ICST-AHMI/HSoundplane_design/eagle/piezo-driver/_export/jpg/piezo-driver-BOT.jpg

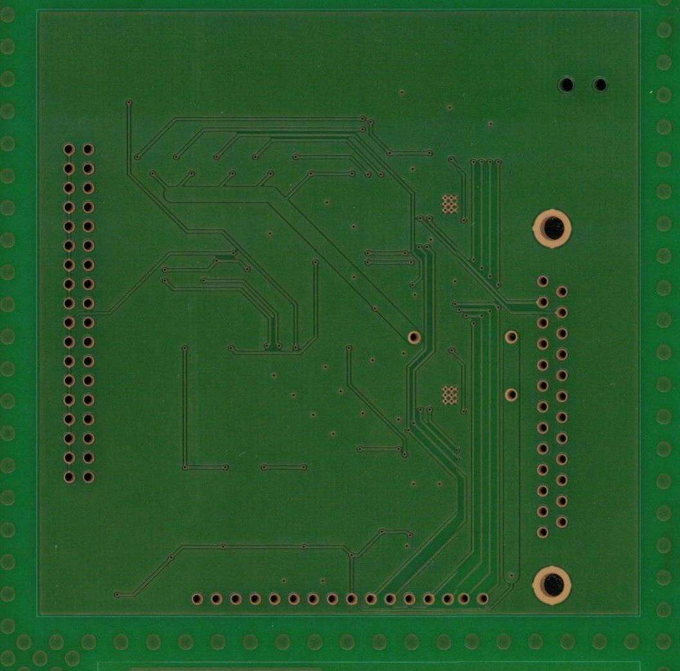
eagle/piezo-driver/_export/jpg/piezo-driver-BOT.jpg
