ICST-AHMI/HSoundplane_design/eagle/piezo-driver/_export/jpg/piezo-driver-TOP.jpg

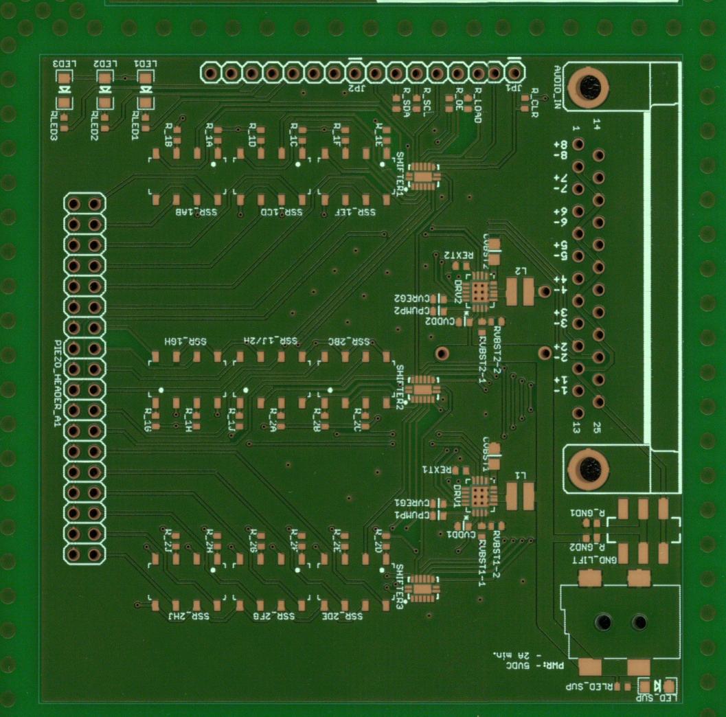
eagle/piezo-driver/_export/jpg/piezo-driver-TOP.jpg
