ICST-AHMI/HSoundplane_design/blender/texturen/soundplane_v0.95-R002.png

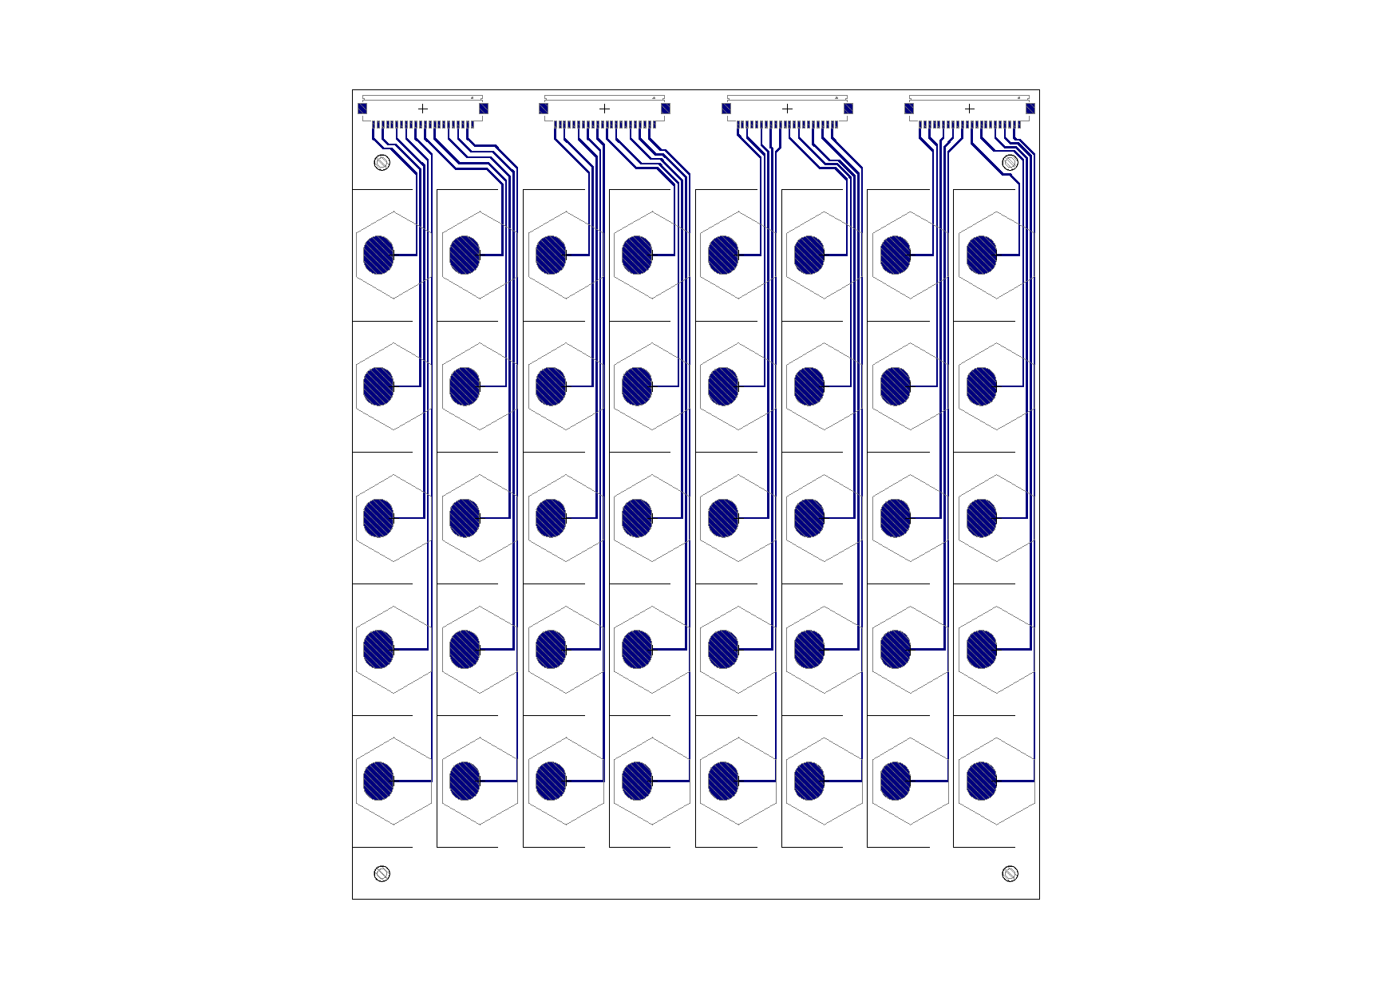
blender/texturen/soundplane_v0.95-R002.png
