ICST-AHMI/HSoundplane_design/blender/texturen/soundplane_v0.95-R004.png

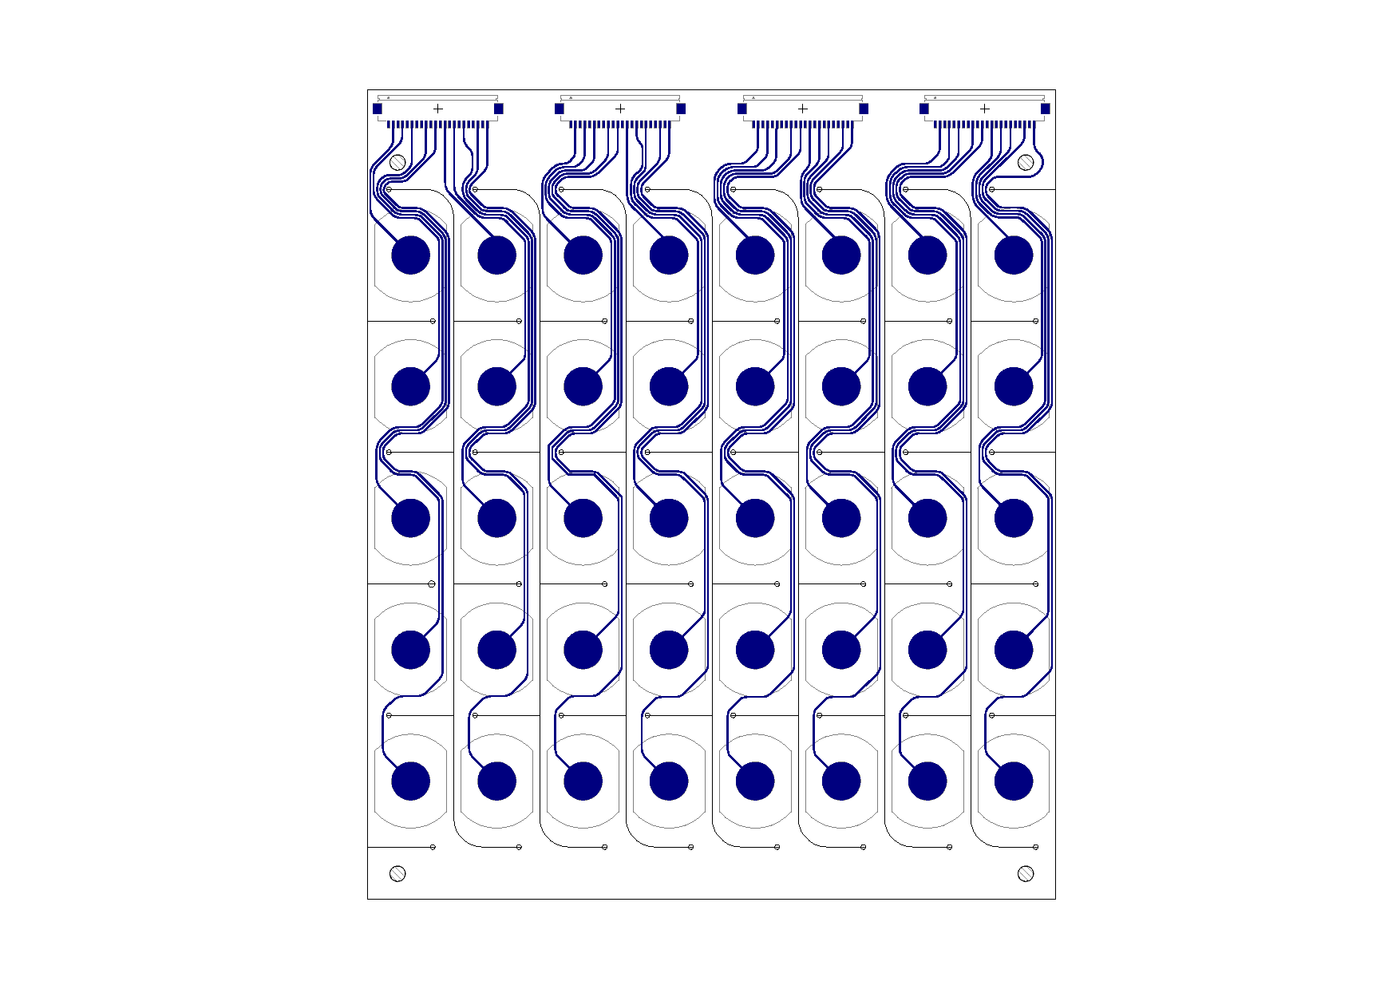
blender/texturen/soundplane_v0.95-R004.png
