ICST-AHMI/HSoundplane_design/blender/texturen/soundplane_v0.95-R006.png

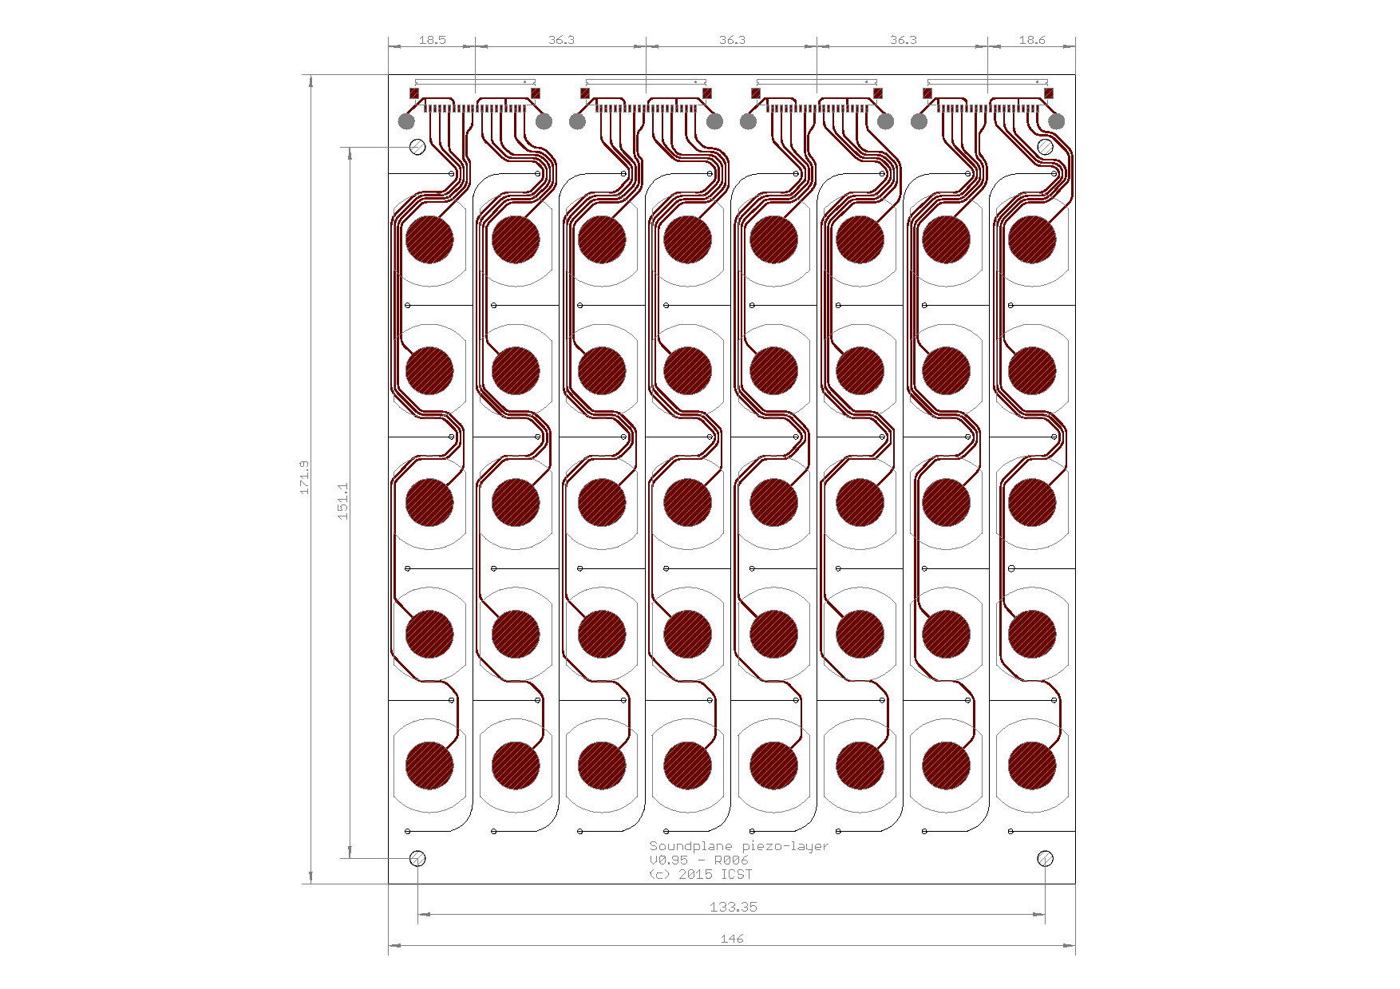
blender/texturen/soundplane_v0.95-R006.png
