ICST-AHMI/HSoundplane_design/(list of files, cad)

Other CAD files:
blender/SP_0072_V2.blend
blender/SP_0072_V3.blend
blender/SP_0072_V4.blend
blender/SP_0072_V5.blend
blender/SP_0072_V6.blend
blender/SP_0072_V7.blend
blender/SP_0072_V8.blend
blender/SP_0072_V9.blend
blender/Sketch.blend
