ICST-AHMI/HSoundplane_design/blender/texturen/multi-touch_v0.95-R003_MEASURES.pdf

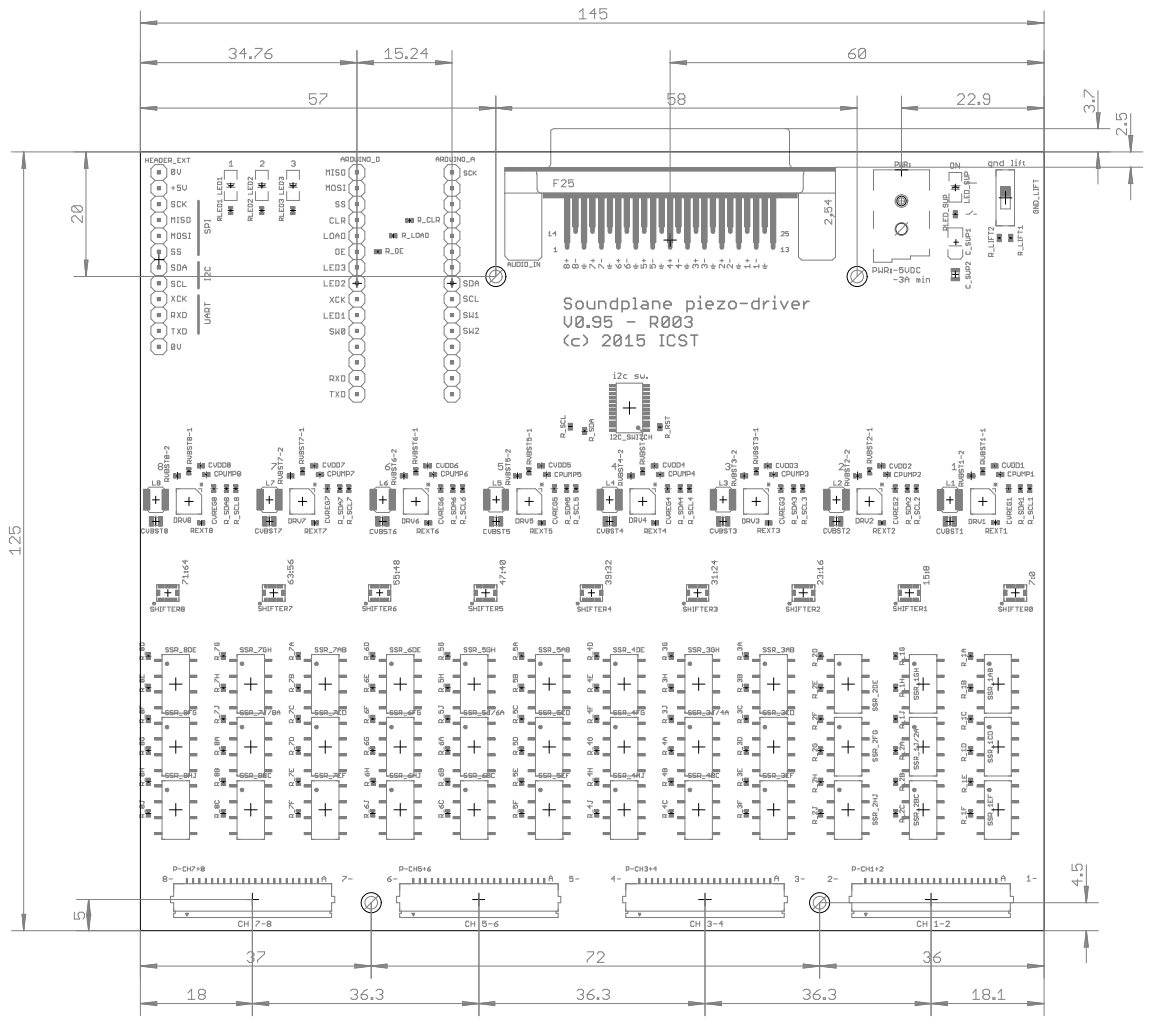
[picture p7: page 1]
