ICST-AHMI/HSoundplane_design/eagle/piezo-driver/_export/pdf/piezo-driver_v0.95-R002_MEASURES.pdf

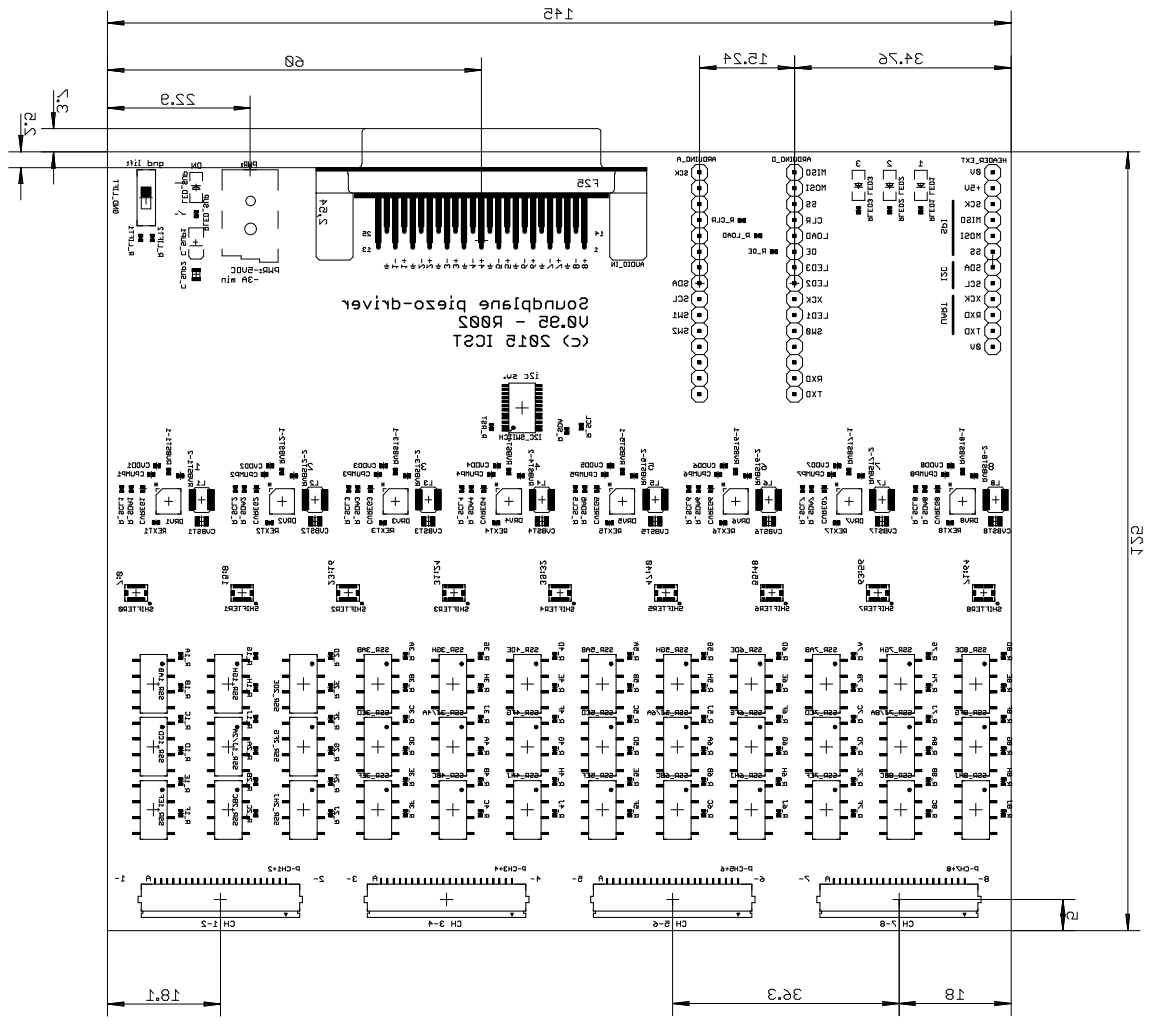
[picture p8: page 1]
