ICST-AHMI/HSoundplane_design/blender/texturen/soundplane_v0.95-R002.pdf

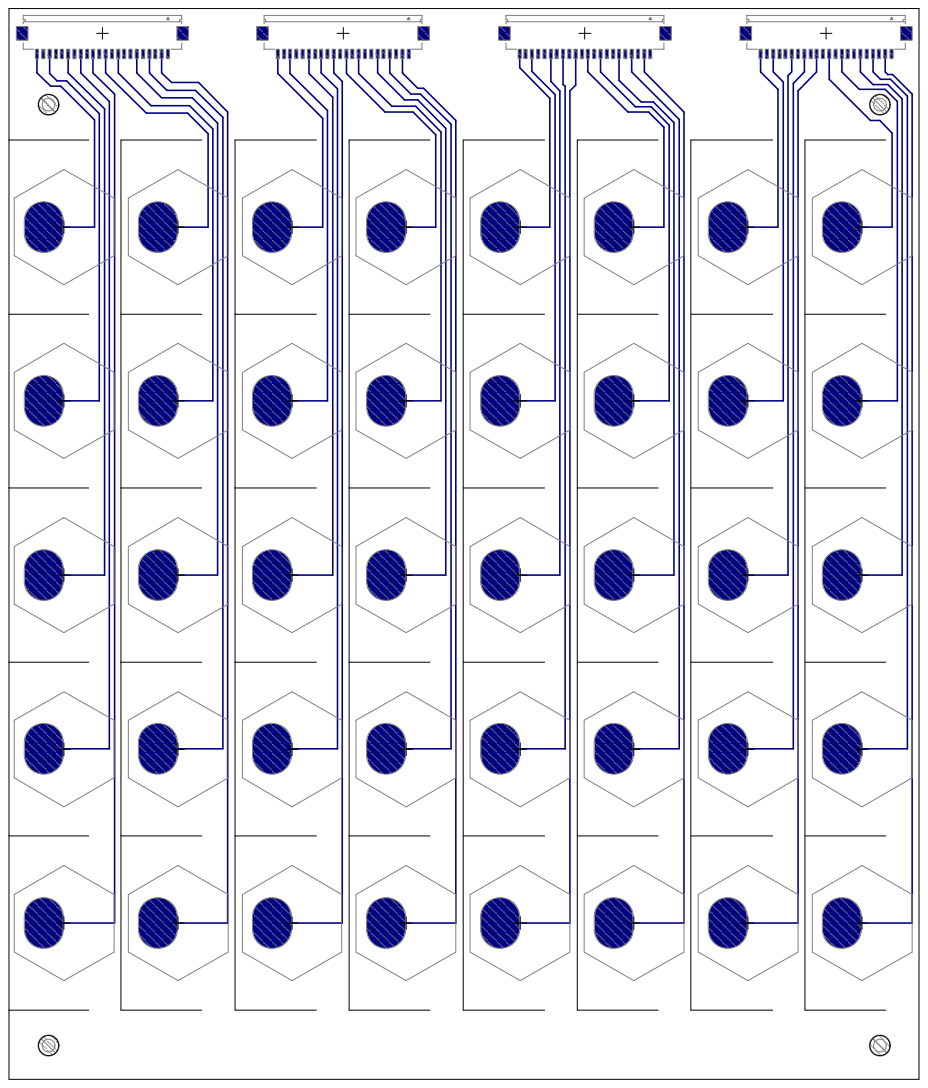
[picture p9: page 1]
