ICST-AHMI/HSoundplane_design/blender/texturen/soundplane_v0.95-R004.pdf

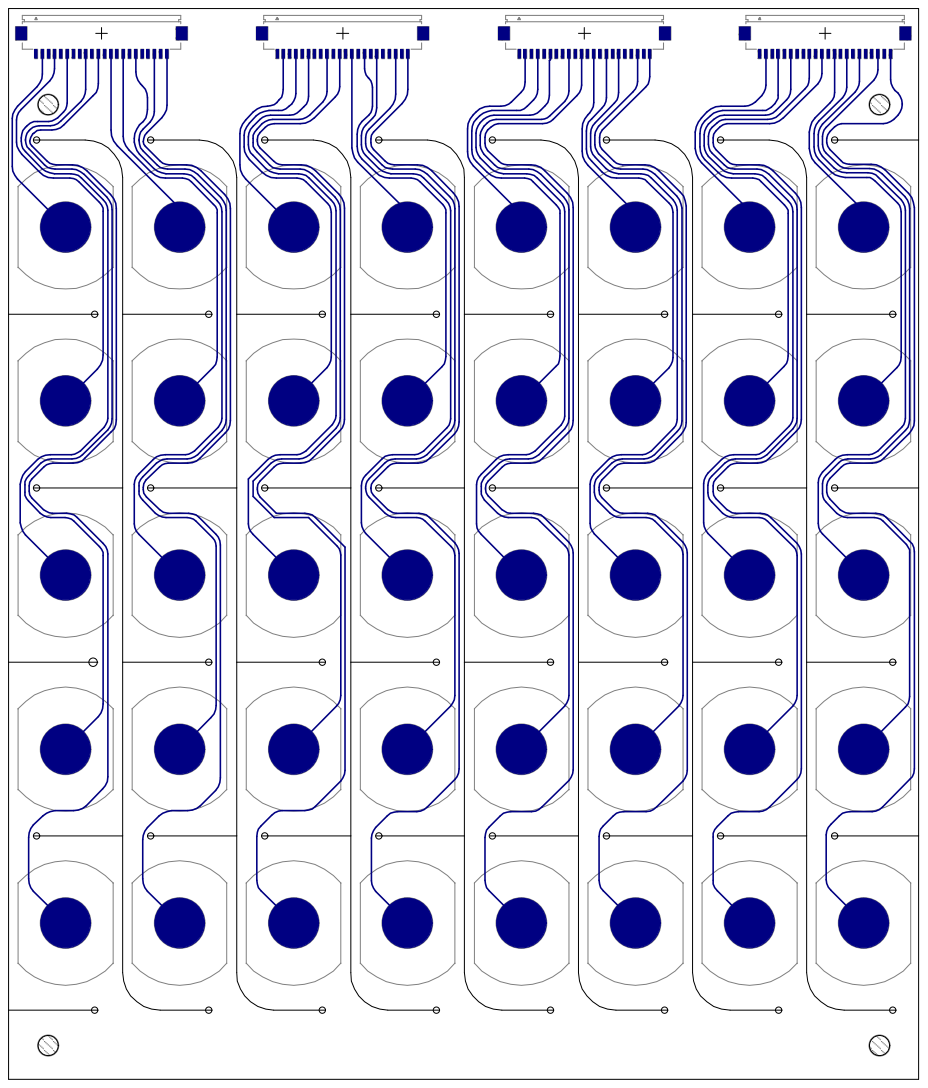
[picture p10: page 1]
