ICST-AHMI/HSoundplane_design/blender/texturen/soundplane_v0.95-R006.pdf

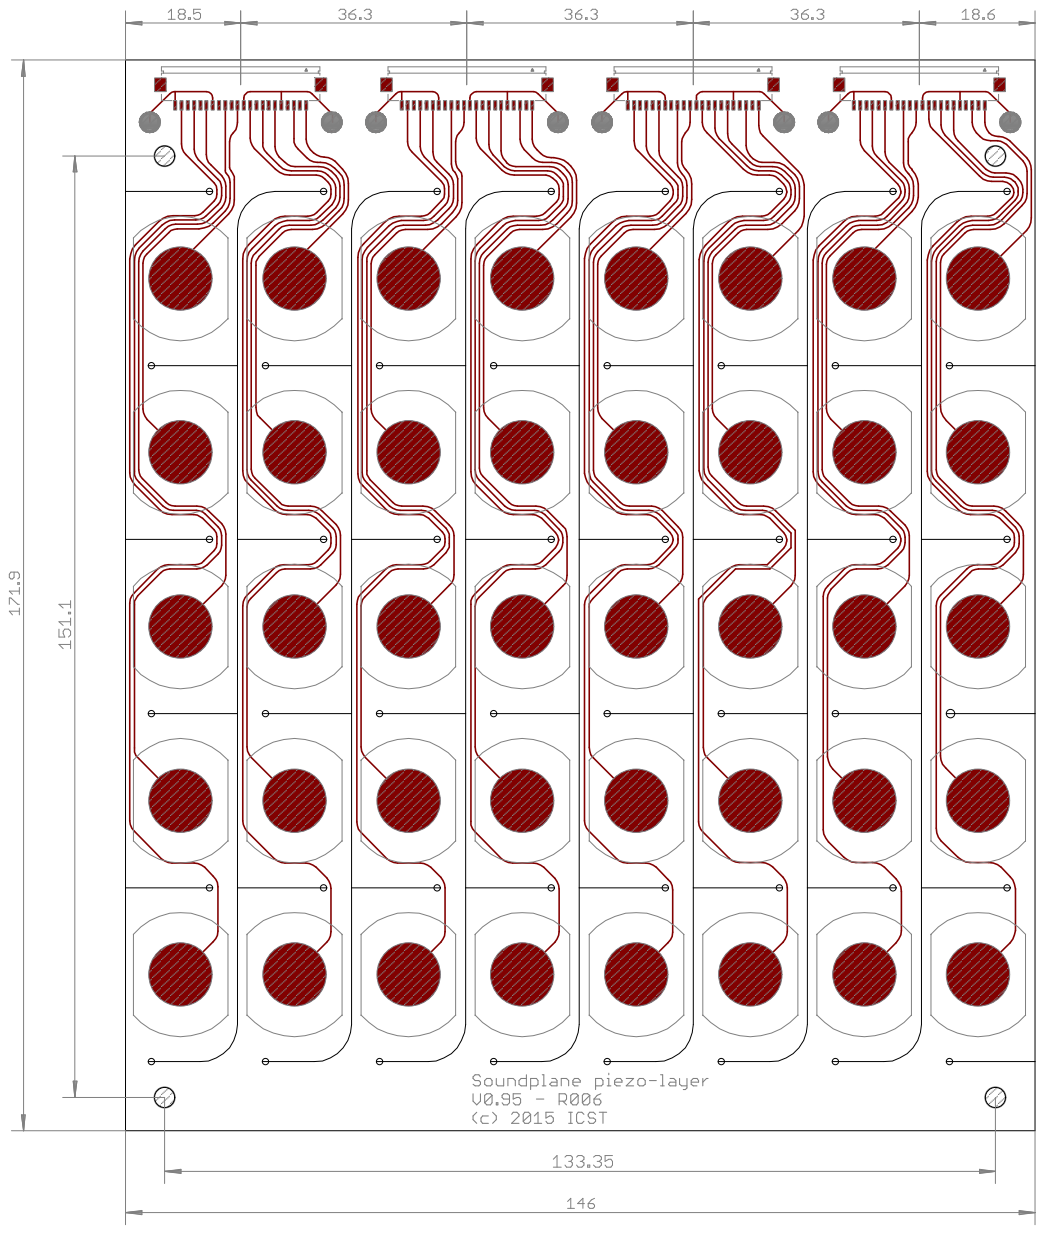
[picture p11: page 1]
