ICST-AHMI/HSoundplane_design/eagle/piezo-driver/_export/pdf/piezo-driver_v0.1-R001_TOP.pdf

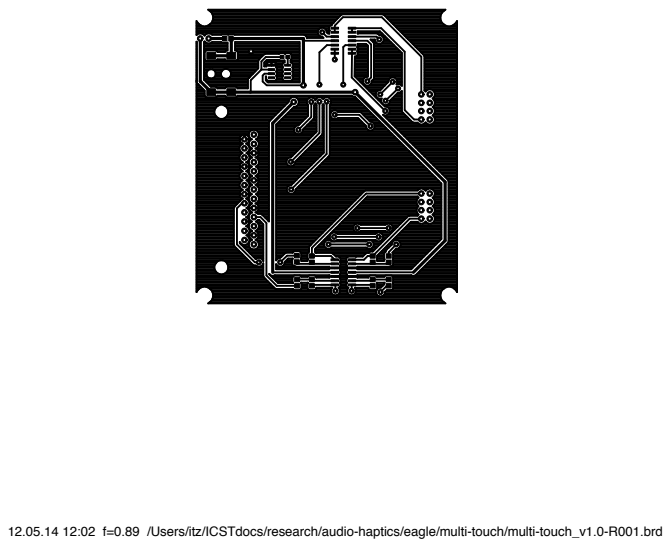
[picture p13: page 1]

12.05.14 12:02 f=0.89 /Users/itz/ICSTdocs/research/audio-haptics/eagle/multi-touch/multi-touch_v1.0-R001.brd
