ICST-AHMI/HSoundplane_design/eagle/piezo-driver/_export/pdf/piezo-driver_v0.1-R002_BOT.pdf

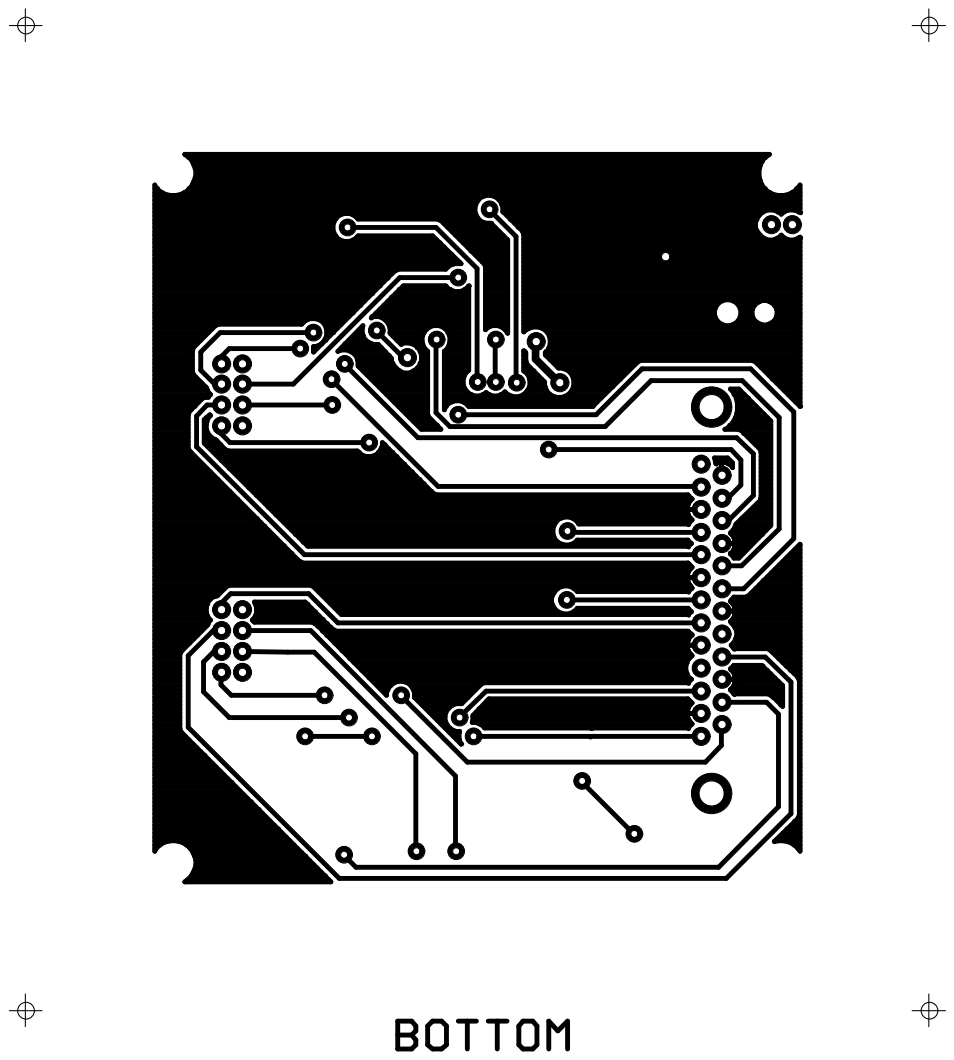
[picture p14: page 1]
