ICST-AHMI/HSoundplane_design/eagle/piezo-driver/_export/pdf/piezo-driver_v0.1-R002_TOP.pdf

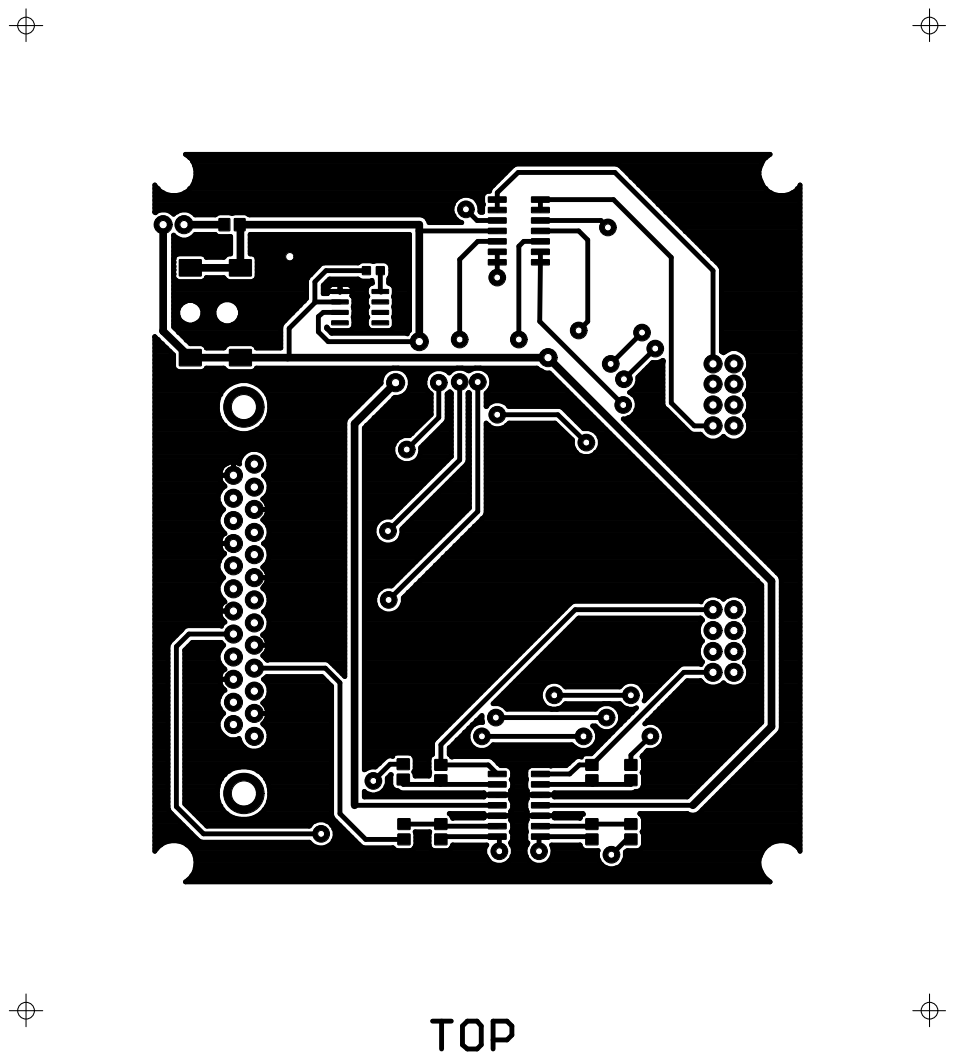
[picture p15: page 1]
