ICST-AHMI/HSoundplane_design/eagle/piezo-driver/_export/pdf/piezo-driver_v0.95-R002.pdf

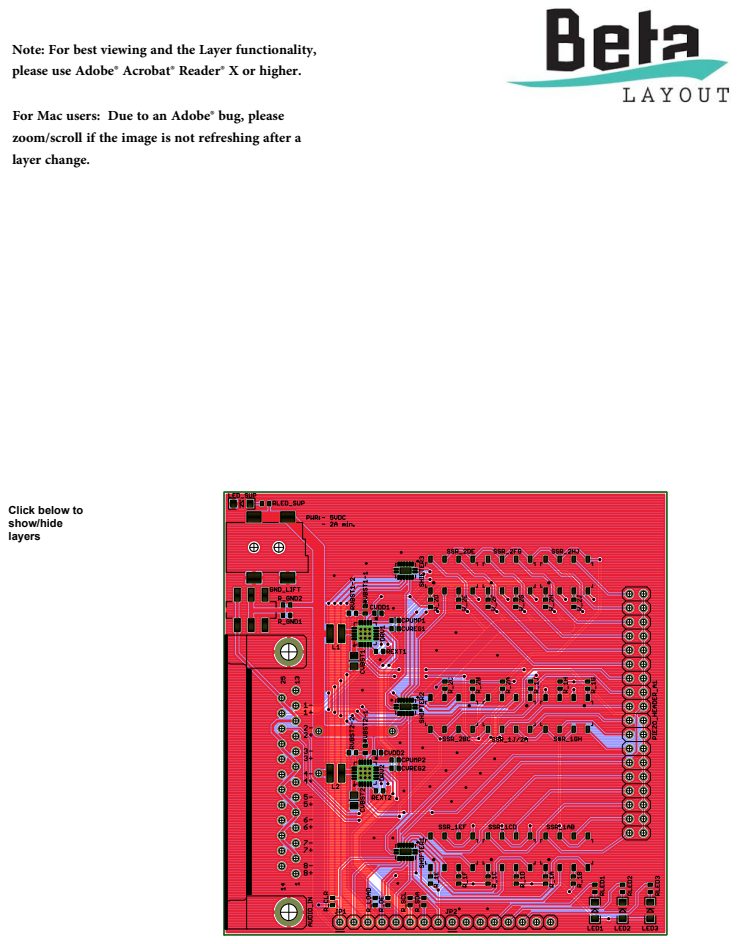
[picture p16: page 1]

Note: For best viewing and the Layer functionality,
please use Adobe® Acrobat® Reader® X or higher.
For Mac users: Due to an Adobe® bug, please
zoom/scroll if the image is not refreshing after a
layer change.
