ICST-AHMI/HSoundplane_design/eagle/piezo-driver/_export/pdf/piezo-driver_v0.95-R002_BESTUECKUNG.pdf

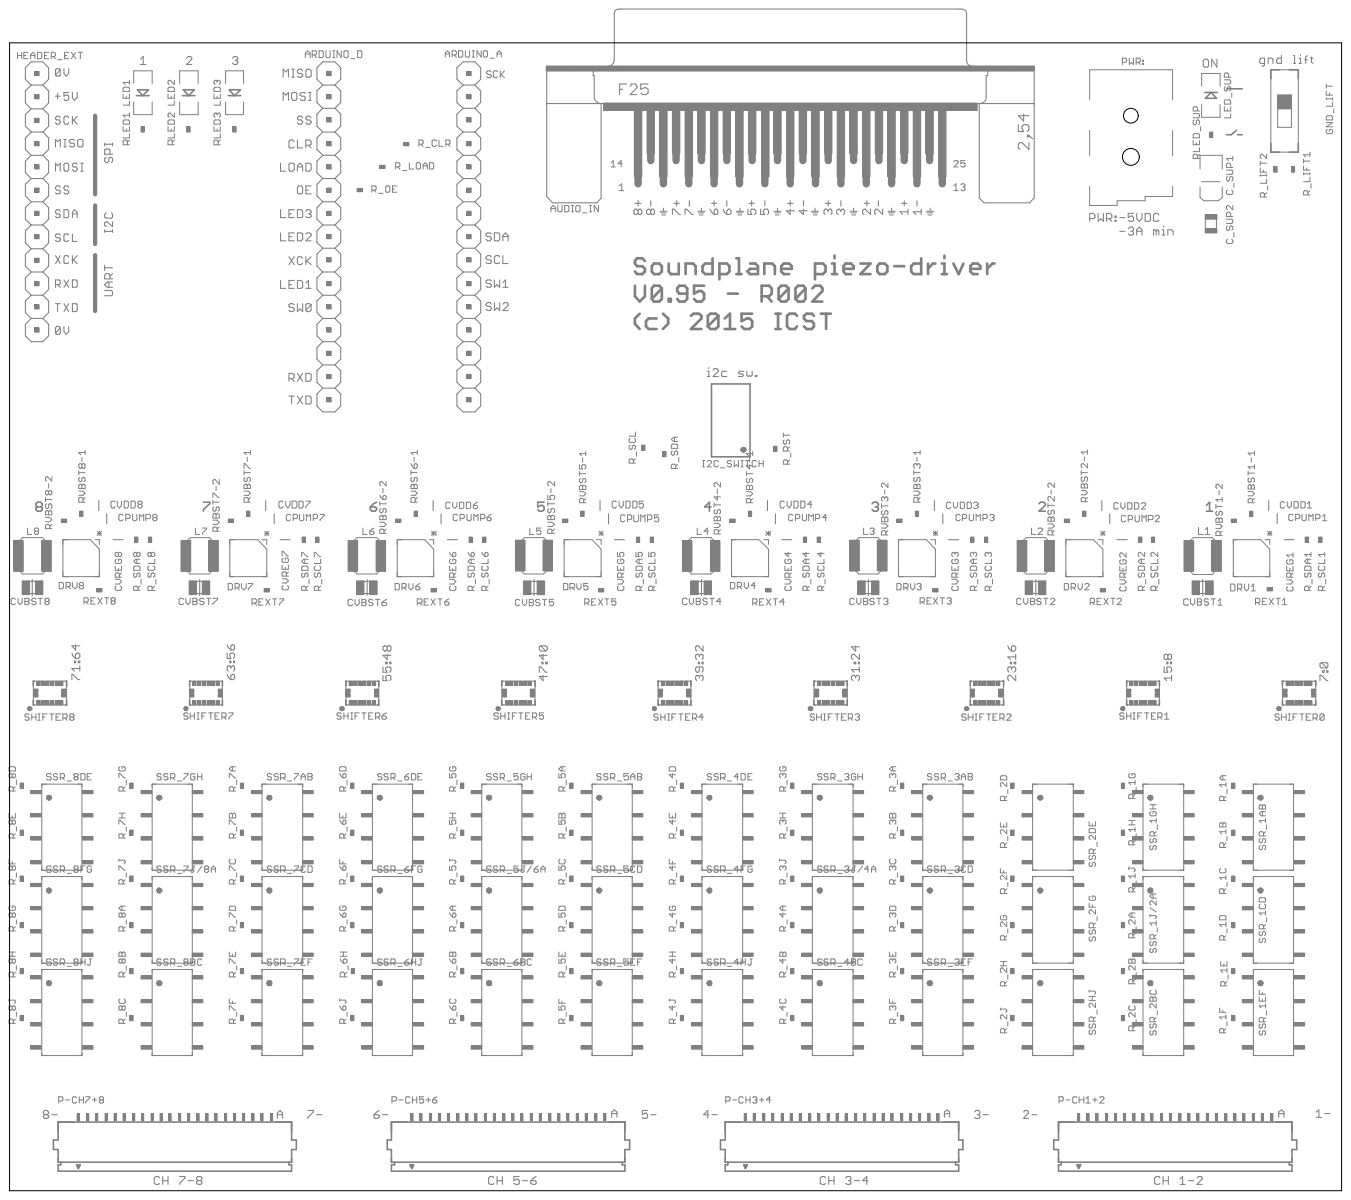
[picture p17: page 1]
