ICST-AHMI/HSoundplane_design/eagle/piezo-layer/_export/pdf/piezo-layer_v0.1-R002.pdf

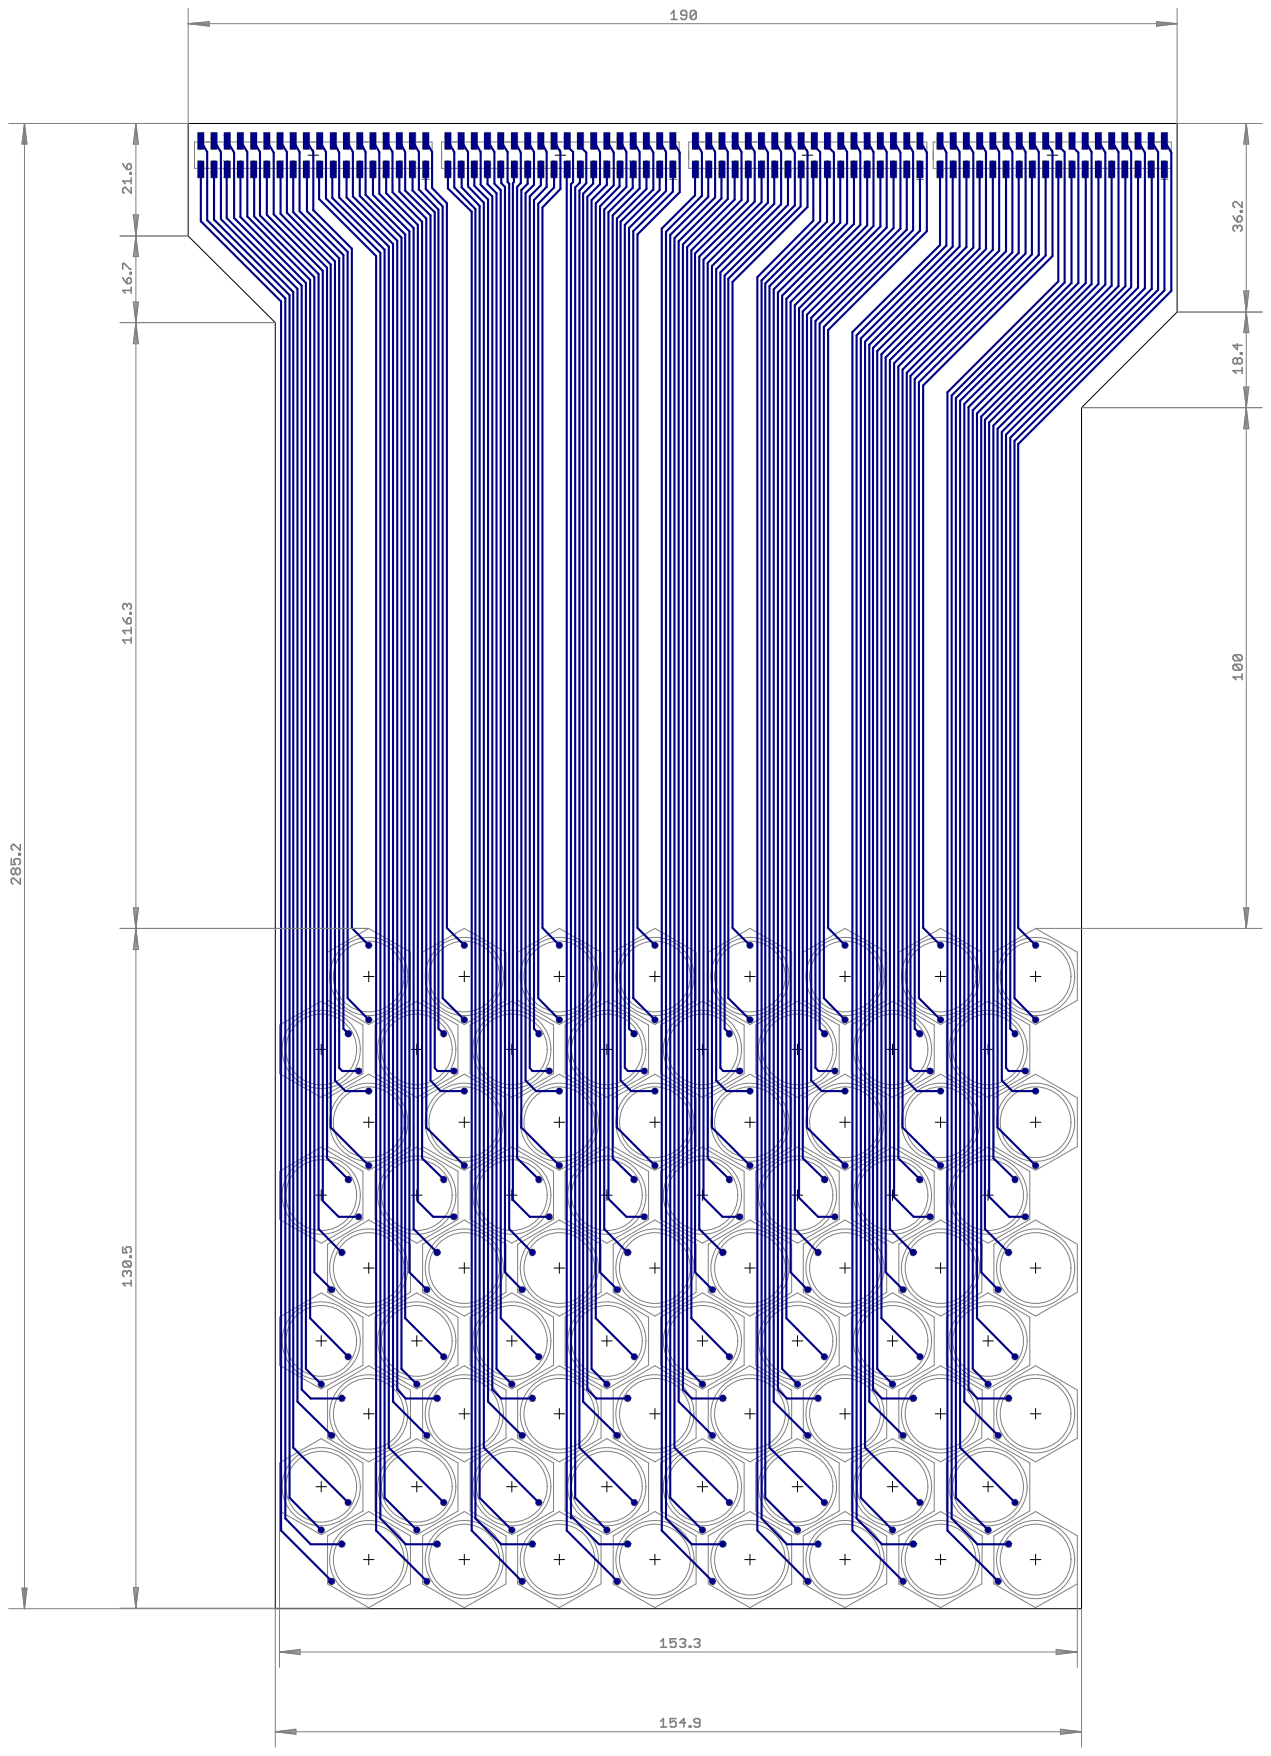
[picture p18: page 1]
