ICST-AHMI/HSoundplane_design/eagle/piezo-layer/_export/pdf/piezo-layer_v0.3-R001.pdf

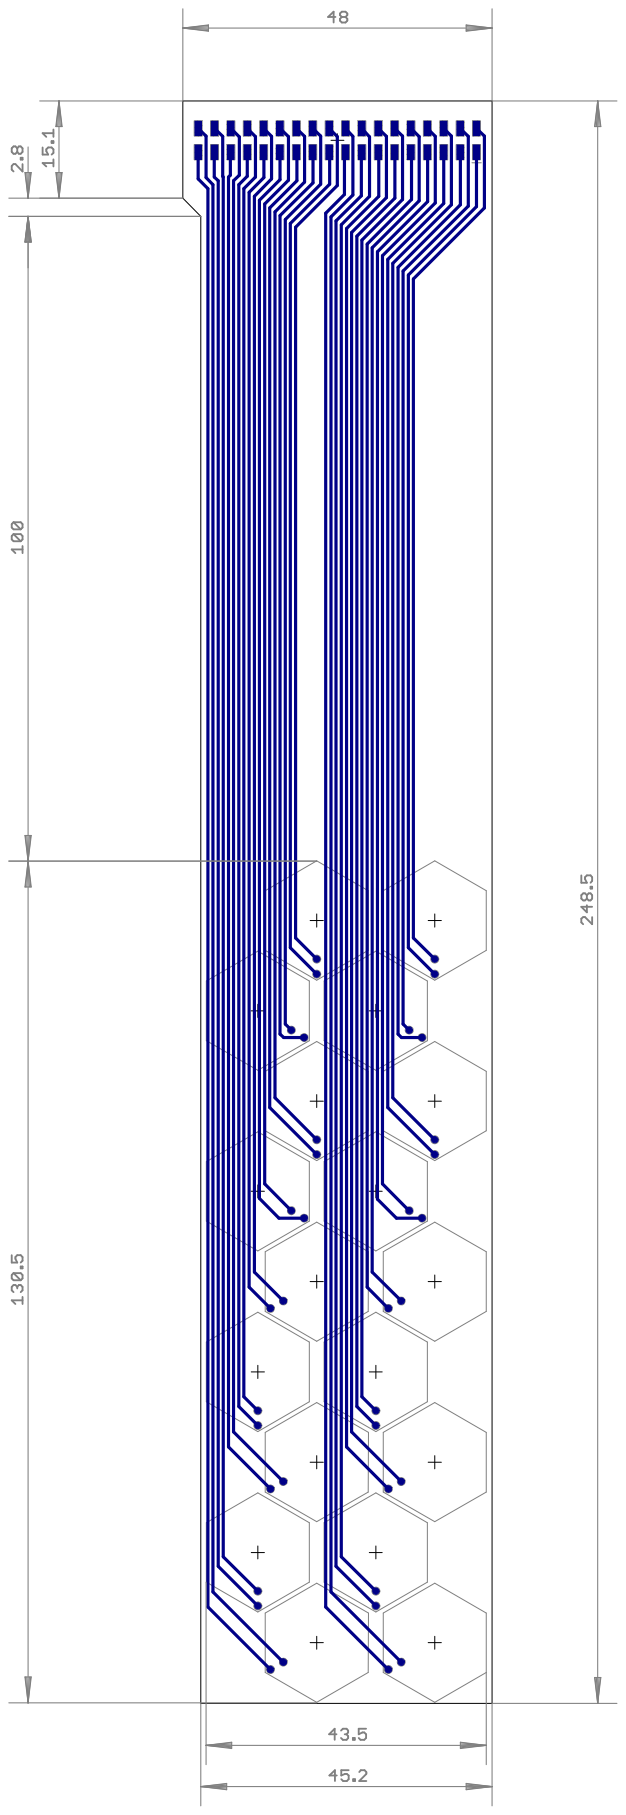
[picture p19: page 1]
