ICST-AHMI/HSoundplane_design/eagle/piezo-layer/_export/pdf/piezo-layer_v0.95-R006_dimension.pdf

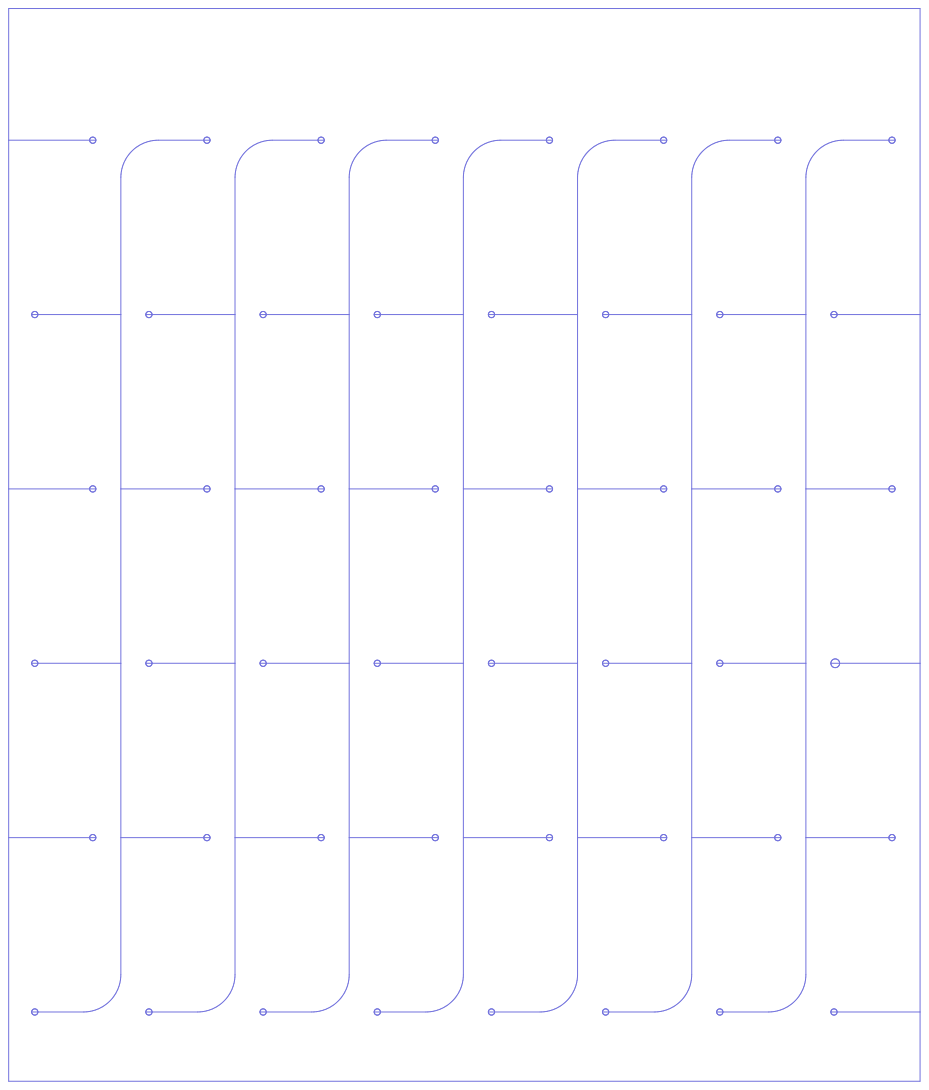
[picture p20: page 1]
