ICST-AHMI/HSoundplane_design/eagle/piezo-layer/_export/pdf/piezo-layer_v0.95-R006_top.pdf

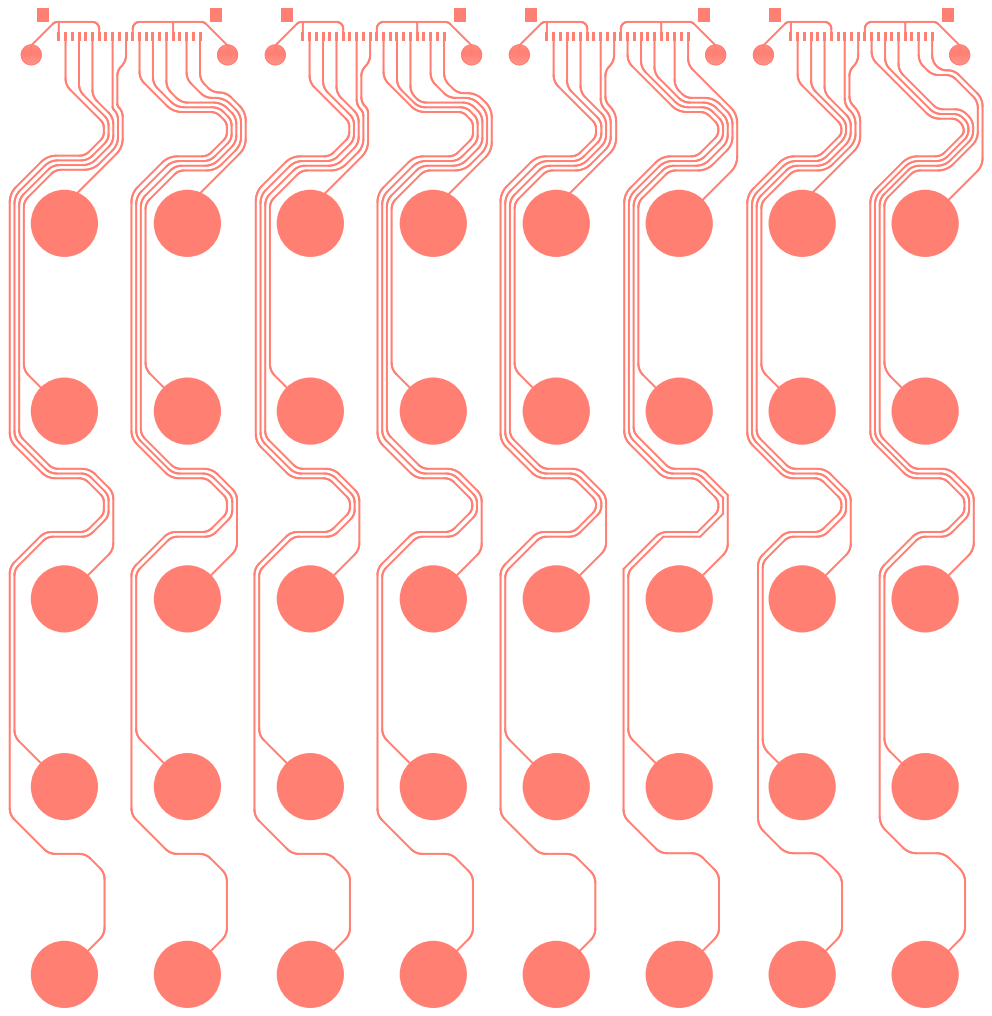
[picture p21: page 1]
