ICST-AHMI/HSoundplane_design/eagle/piezo-layer/_export/pdf/piezo-layer_v0.95-R006_tSilk.pdf

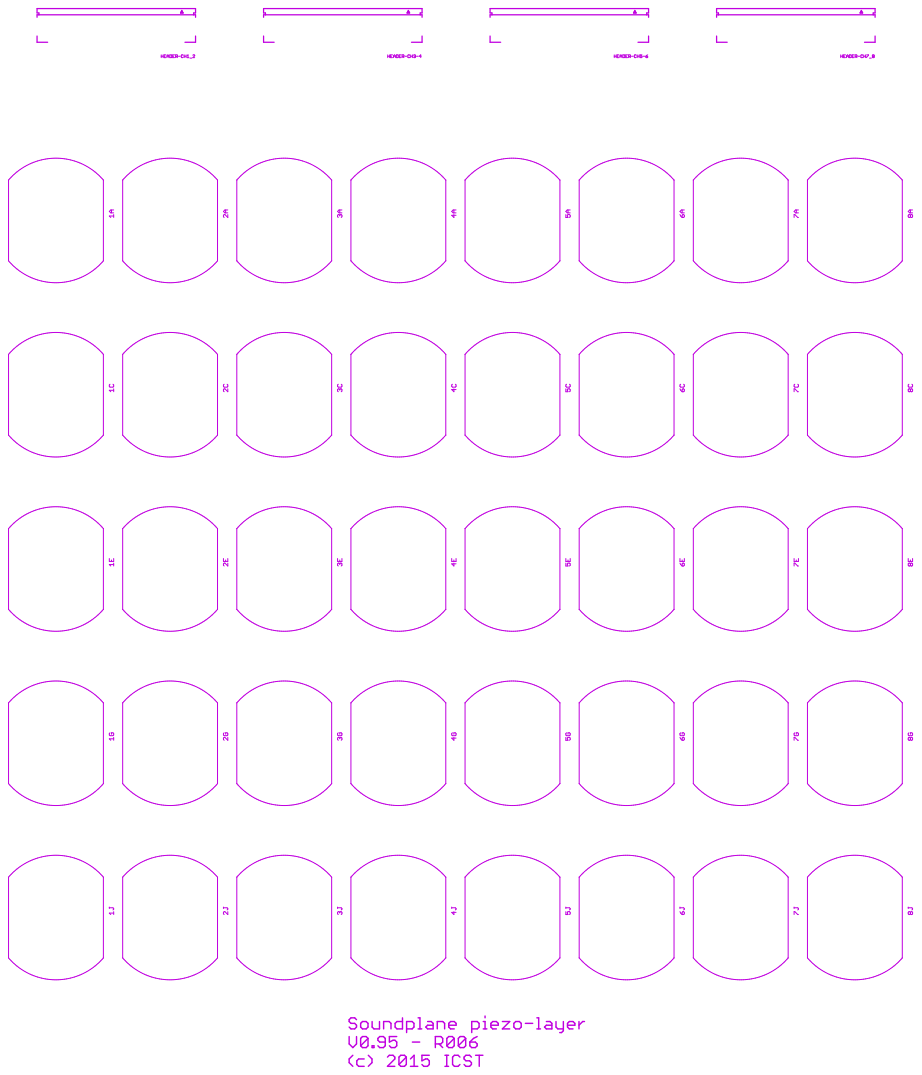
[picture p22: page 1]
