ICST-AHMI/HSoundplane_design/eagle/piezo-layer/_export/pdf/piezo-layer_v0.95-R006_tStop.pdf

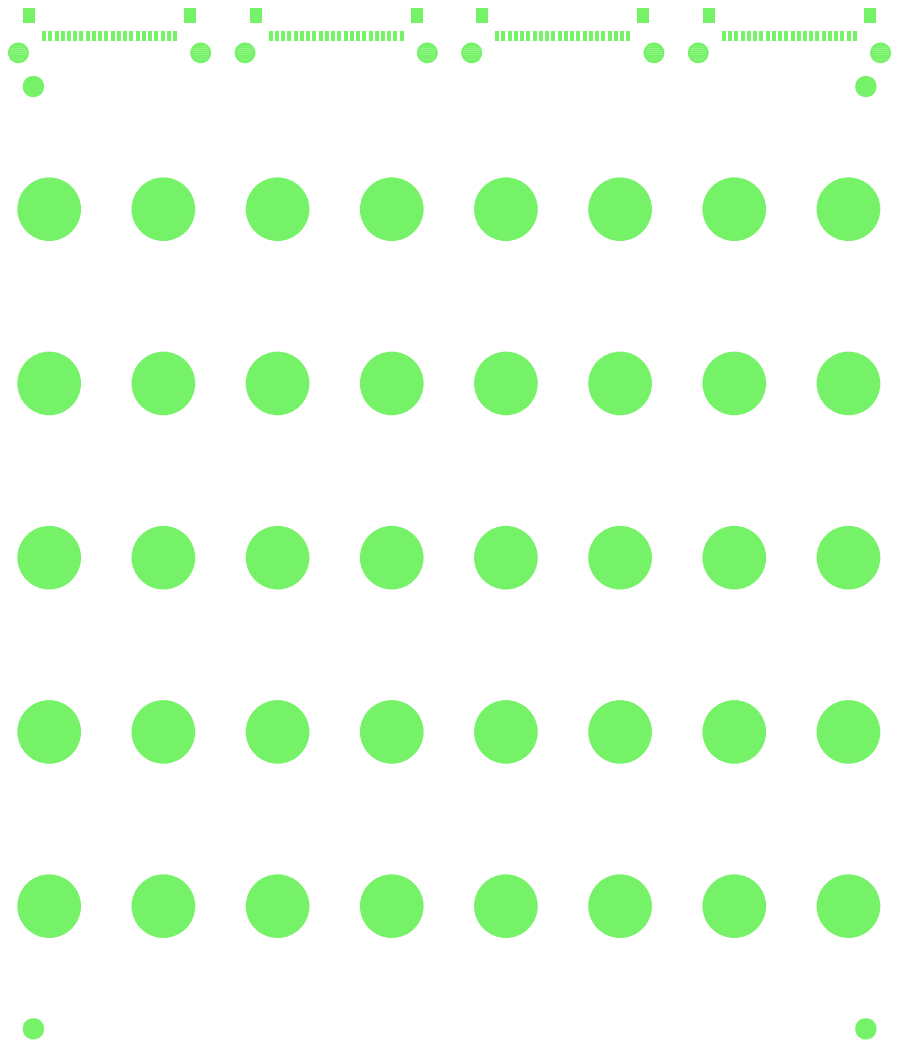
[picture p23: page 1]
