ICST-AHMI/HSoundplane_design/eagle/piezo-layer/_export/pdf/piezo-layer_v0.1-R001.pdf

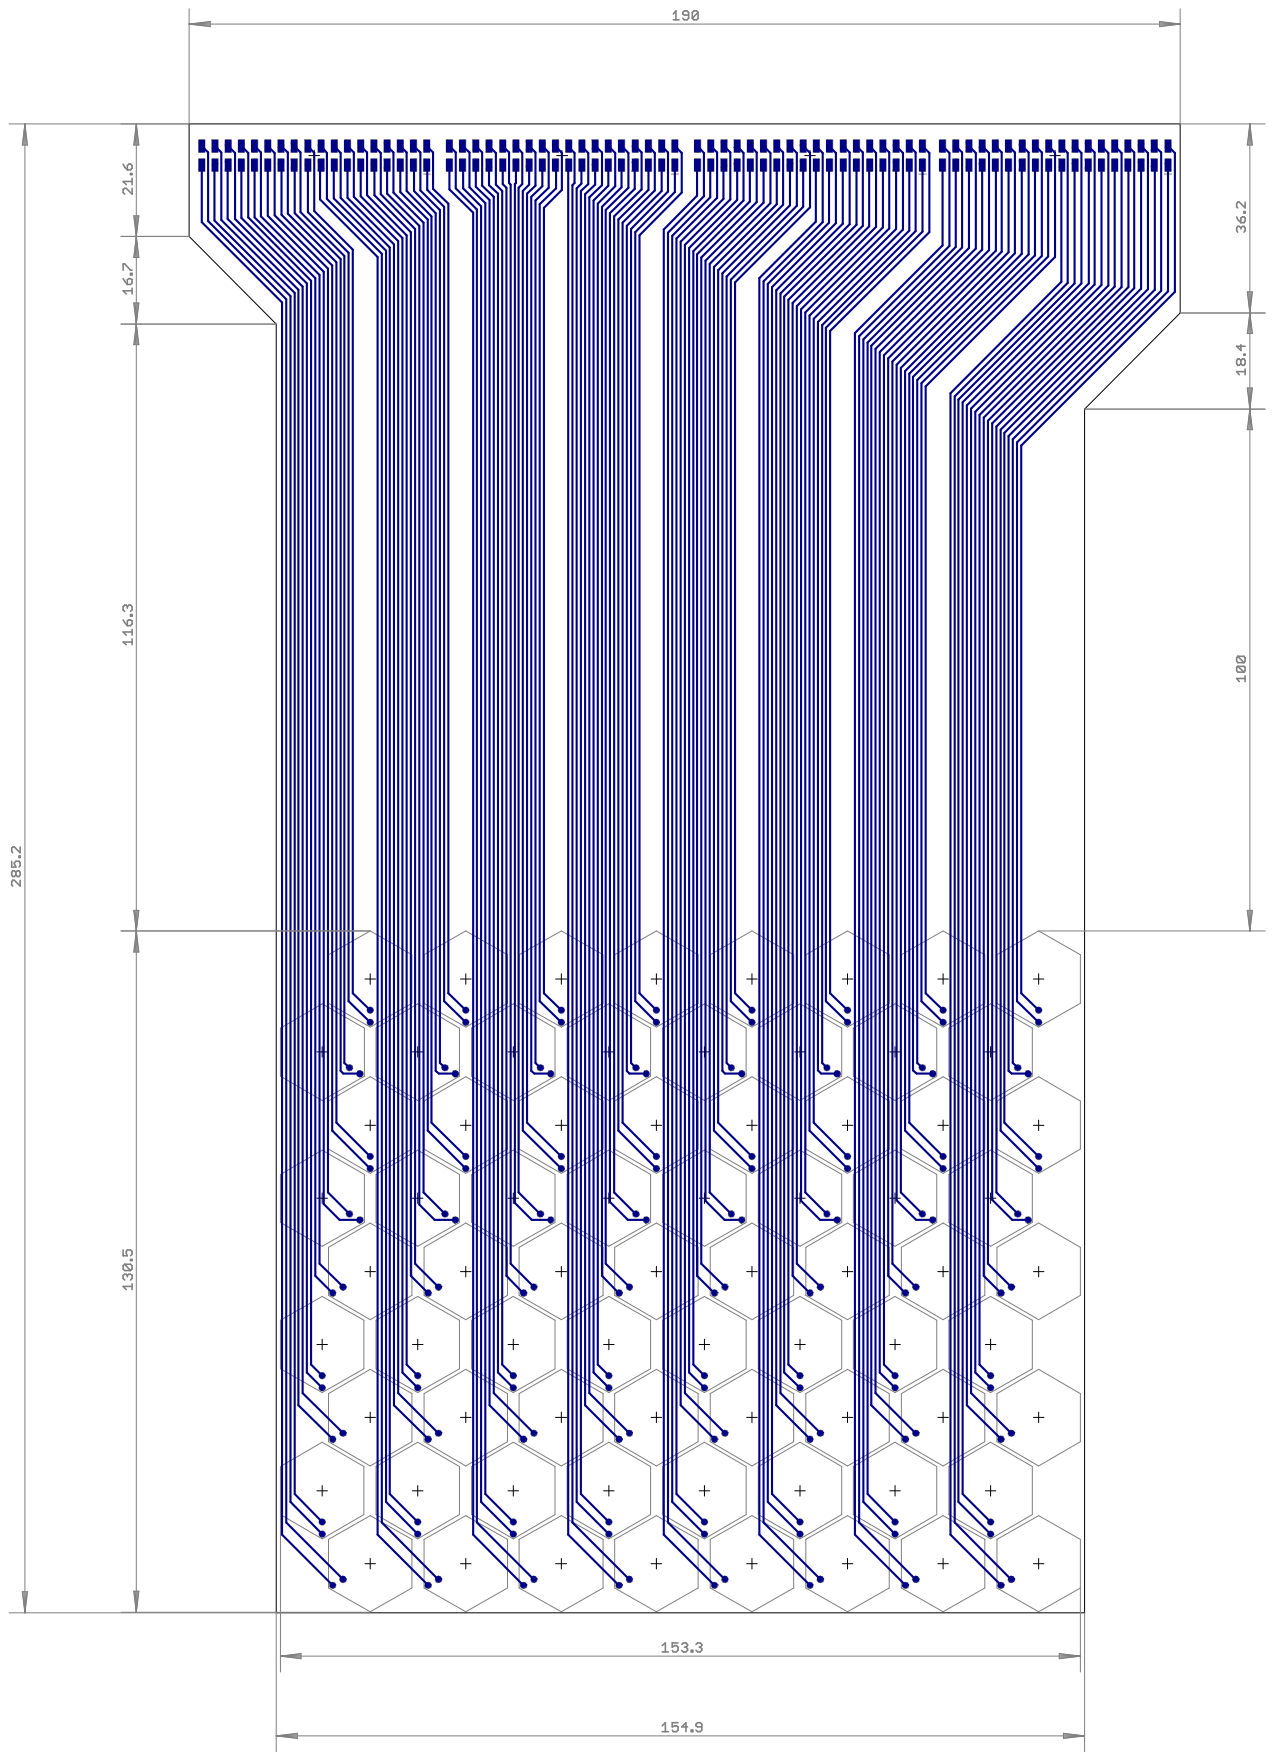
[picture p24: page 1]
