ICST-AHMI/HSoundplane_design/eagle/piezo-layer/_export/pdf/piezo-layer_v0.2-R001.pdf

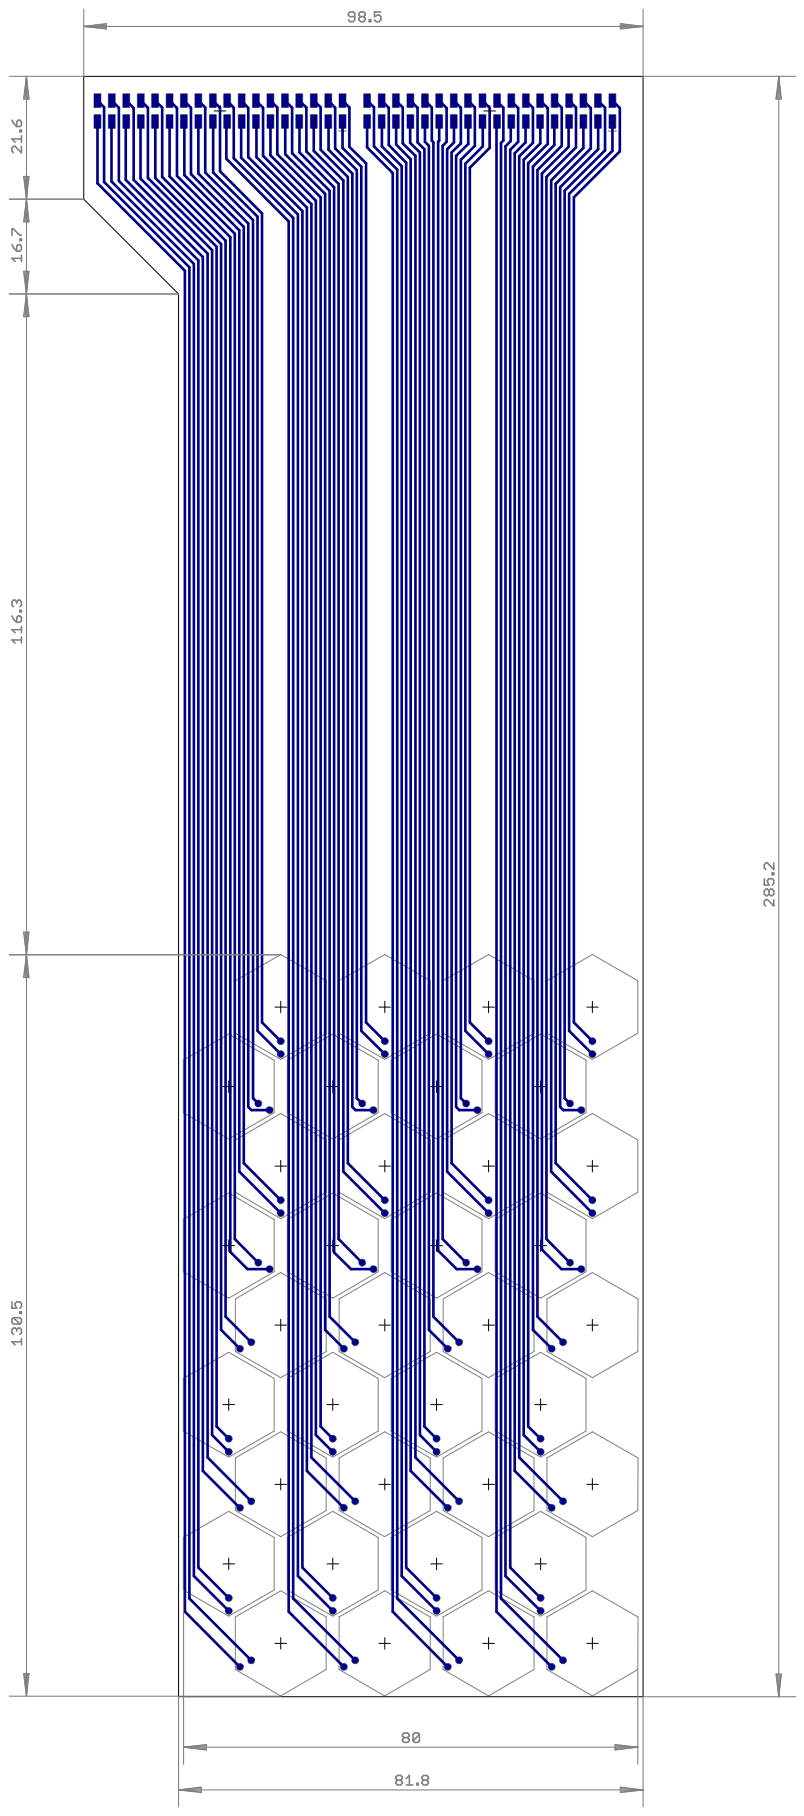
[picture p25: page 1]
