ICST-AHMI/HSoundplane_design/eagle/piezo-layer/piezo-layer_v0.95-R002.brd

## EAGLE design eagle/piezo-layer/piezo-layer_v0.95-R002.brd (2015-09-08)

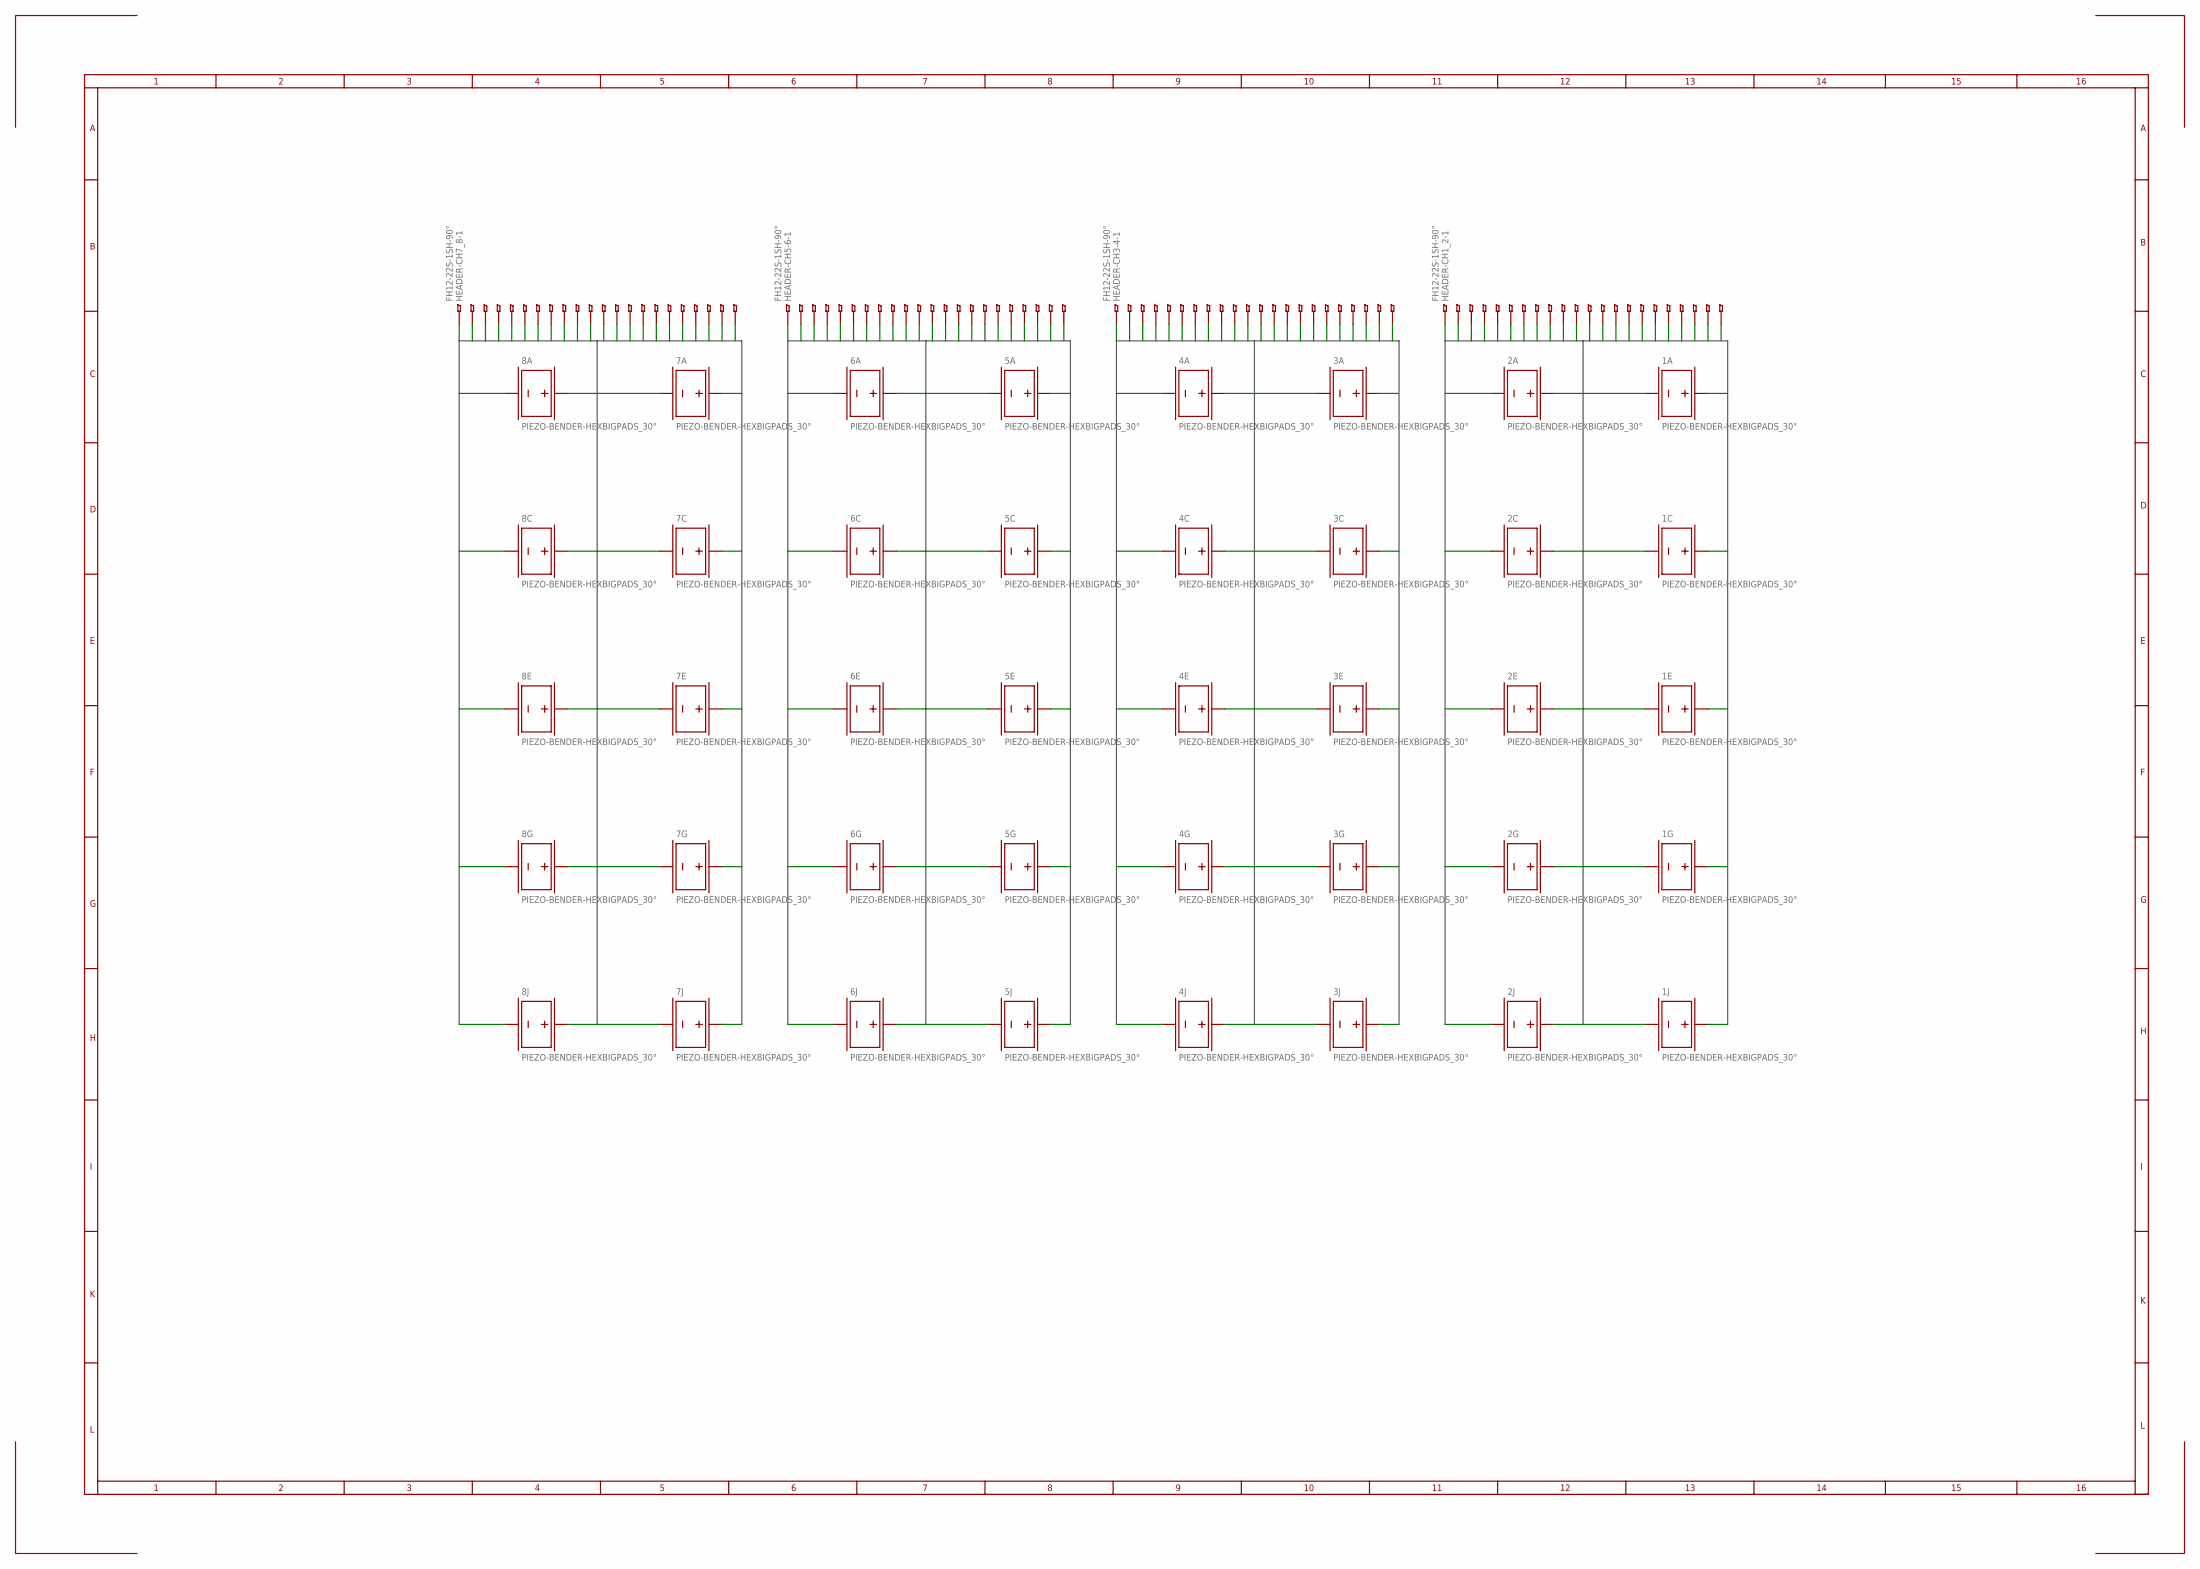
[picture p26: schematic piezo-layer_v0.95-R002.sch]

Parts:
1A, 1C, 1E, 1G, 1J, 2A, 2C, 2E, 2G, 2J, 3A, 3C, 3E, 3G, 3J, 4A, 4C, 4E, 4G, 4J, 5A, 5C, 5E, 5G, 5J, 6A, 6C, 6E, 6G, 6J, 7A, 7C, 7E, 7G, 7J, 8A, 8C, 8E, 8G, 8J: PIEZO-BENDER-HEXBIGPADS_30°; PIEZO-BENDER-HEX_16MM_BIGPAD-30°
HEADER-CH1_2, HEADER-CH3-4, HEADER-CH5-6, HEADER-CH7_8: FH12-22S-1SH-90°; FH12-22S-1SH

Connections:
BUS1: 1A.TOP (+_1), HEADER-CH1_2.22
BUS2: HEADER-CH1_2.21
BUS3: 1C.TOP (+_1), HEADER-CH1_2.20
BUS4: HEADER-CH1_2.19
BUS5: 1A.BOTTOM (-_1), 1C.BOTTOM (-_1), 1E.BOTTOM (-_1), 1G.BOTTOM (-_1), 1J.BOTTOM (-_1), HEADER-CH1_2.12, HEADER-CH1_2.18
BUS6: 1E.TOP (+_1), HEADER-CH1_2.17
BUS7: HEADER-CH1_2.16
BUS8: 1G.TOP (+_1), HEADER-CH1_2.15
BUS9: HEADER-CH1_2.14
BUS10: 1J.TOP (+_1), HEADER-CH1_2.13
BUS11: 2A.TOP (+_1), HEADER-CH1_2.11
BUS12: HEADER-CH1_2.10
BUS13: 2C.TOP (+_1), HEADER-CH1_2.9
BUS14: HEADER-CH1_2.8
BUS15: 2A.BOTTOM (-_1), 2C.BOTTOM (-_1), 2E.BOTTOM (-_1), 2G.BOTTOM (-_1), 2J.BOTTOM (-_1), HEADER-CH1_2.1, HEADER-CH1_2.7
BUS16: 2E.TOP (+_1), HEADER-CH1_2.6
BUS17: HEADER-CH1_2.5
BUS18: 2G.TOP (+_1), HEADER-CH1_2.4
BUS19: HEADER-CH1_2.3
BUS20: 2J.TOP (+_1), HEADER-CH1_2.2
BUS21: 3A.TOP (+_1), HEADER-CH3-4.22
BUS22: HEADER-CH3-4.21
BUS23: 3C.TOP (+_1), HEADER-CH3-4.20
BUS24: HEADER-CH3-4.19
BUS25: 3A.BOTTOM (-_1), 3C.BOTTOM (-_1), 3E.BOTTOM (-_1), 3G.BOTTOM (-_1), 3J.BOTTOM (-_1), HEADER-CH3-4.12, HEADER-CH3-4.18
BUS26: 3E.TOP (+_1), HEADER-CH3-4.17
BUS27: HEADER-CH3-4.16
BUS28: 3G.TOP (+_1), HEADER-CH3-4.15
BUS29: HEADER-CH3-4.14
BUS30: 3J.TOP (+_1), HEADER-CH3-4.13
BUS31: 4A.TOP (+_1), HEADER-CH3-4.11
BUS32: HEADER-CH3-4.10
BUS33: 4C.TOP (+_1), HEADER-CH3-4.9
BUS34: HEADER-CH3-4.8
BUS35: 4A.BOTTOM (-_1), 4C.BOTTOM (-_1), 4E.BOTTOM (-_1), 4G.BOTTOM (-_1), 4J.BOTTOM (-_1), HEADER-CH3-4.1, HEADER-CH3-4.7
BUS36: 4E.TOP (+_1), HEADER-CH3-4.6
BUS37: HEADER-CH3-4.5
BUS38: 4G.TOP (+_1), HEADER-CH3-4.4
BUS39: HEADER-CH3-4.3
BUS40: 4J.TOP (+_1), HEADER-CH3-4.2
BUS41: 5A.TOP (+_1), HEADER-CH5-6.22
BUS42: HEADER-CH5-6.21
BUS43: 5C.TOP (+_1), HEADER-CH5-6.20
BUS44: HEADER-CH5-6.19
BUS45: 5A.BOTTOM (-_1), 5C.BOTTOM (-_1), 5E.BOTTOM (-_1), 5G.BOTTOM (-_1), 5J.BOTTOM (-_1), HEADER-CH5-6.12, HEADER-CH5-6.18
BUS46: 5E.TOP (+_1), HEADER-CH5-6.17
BUS47: HEADER-CH5-6.16
BUS48: 5G.TOP (+_1), HEADER-CH5-6.15
BUS49: HEADER-CH5-6.14
BUS50: 5J.TOP (+_1), HEADER-CH5-6.13
BUS51: 6A.TOP (+_1), HEADER-CH5-6.11
BUS52: HEADER-CH5-6.10
BUS53: 6C.TOP (+_1), HEADER-CH5-6.9
BUS54: HEADER-CH5-6.8
BUS55: 6A.BOTTOM (-_1), 6C.BOTTOM (-_1), 6E.BOTTOM (-_1), 6G.BOTTOM (-_1), 6J.BOTTOM (-_1), HEADER-CH5-6.1, HEADER-CH5-6.7
BUS56: 6E.TOP (+_1), HEADER-CH5-6.6
BUS57: HEADER-CH5-6.5
BUS58: 6G.TOP (+_1), HEADER-CH5-6.4
BUS59: HEADER-CH5-6.3
BUS60: 6J.TOP (+_1), HEADER-CH5-6.2
BUS61: 7A.TOP (+_1), HEADER-CH7_8.22
BUS62: HEADER-CH7_8.21
BUS63: 7C.TOP (+_1), HEADER-CH7_8.20
BUS64: HEADER-CH7_8.19
BUS65: 7A.BOTTOM (-_1), 7C.BOTTOM (-_1), 7E.BOTTOM (-_1), 7G.BOTTOM (-_1), 7J.BOTTOM (-_1), HEADER-CH7_8.12, HEADER-CH7_8.18
BUS66: 7E.TOP (+_1), HEADER-CH7_8.17
BUS67: HEADER-CH7_8.16
BUS68: 7G.TOP (+_1), HEADER-CH7_8.15
BUS69: HEADER-CH7_8.14
BUS70: 7J.TOP (+_1), HEADER-CH7_8.13
BUS71: 8A.TOP (+_1), HEADER-CH7_8.11
BUS72: HEADER-CH7_8.10
BUS73: 8C.TOP (+_1), HEADER-CH7_8.9
BUS74: HEADER-CH7_8.8
BUS75: 8A.BOTTOM (-_1), 8C.BOTTOM (-_1), 8E.BOTTOM (-_1), 8G.BOTTOM (-_1), 8J.BOTTOM (-_1), HEADER-CH7_8.1, HEADER-CH7_8.7
BUS76: 8E.TOP (+_1), HEADER-CH7_8.6
BUS77: HEADER-CH7_8.5
BUS78: 8G.TOP (+_1), HEADER-CH7_8.4
BUS79: HEADER-CH7_8.3
BUS80: 8J.TOP (+_1), HEADER-CH7_8.2

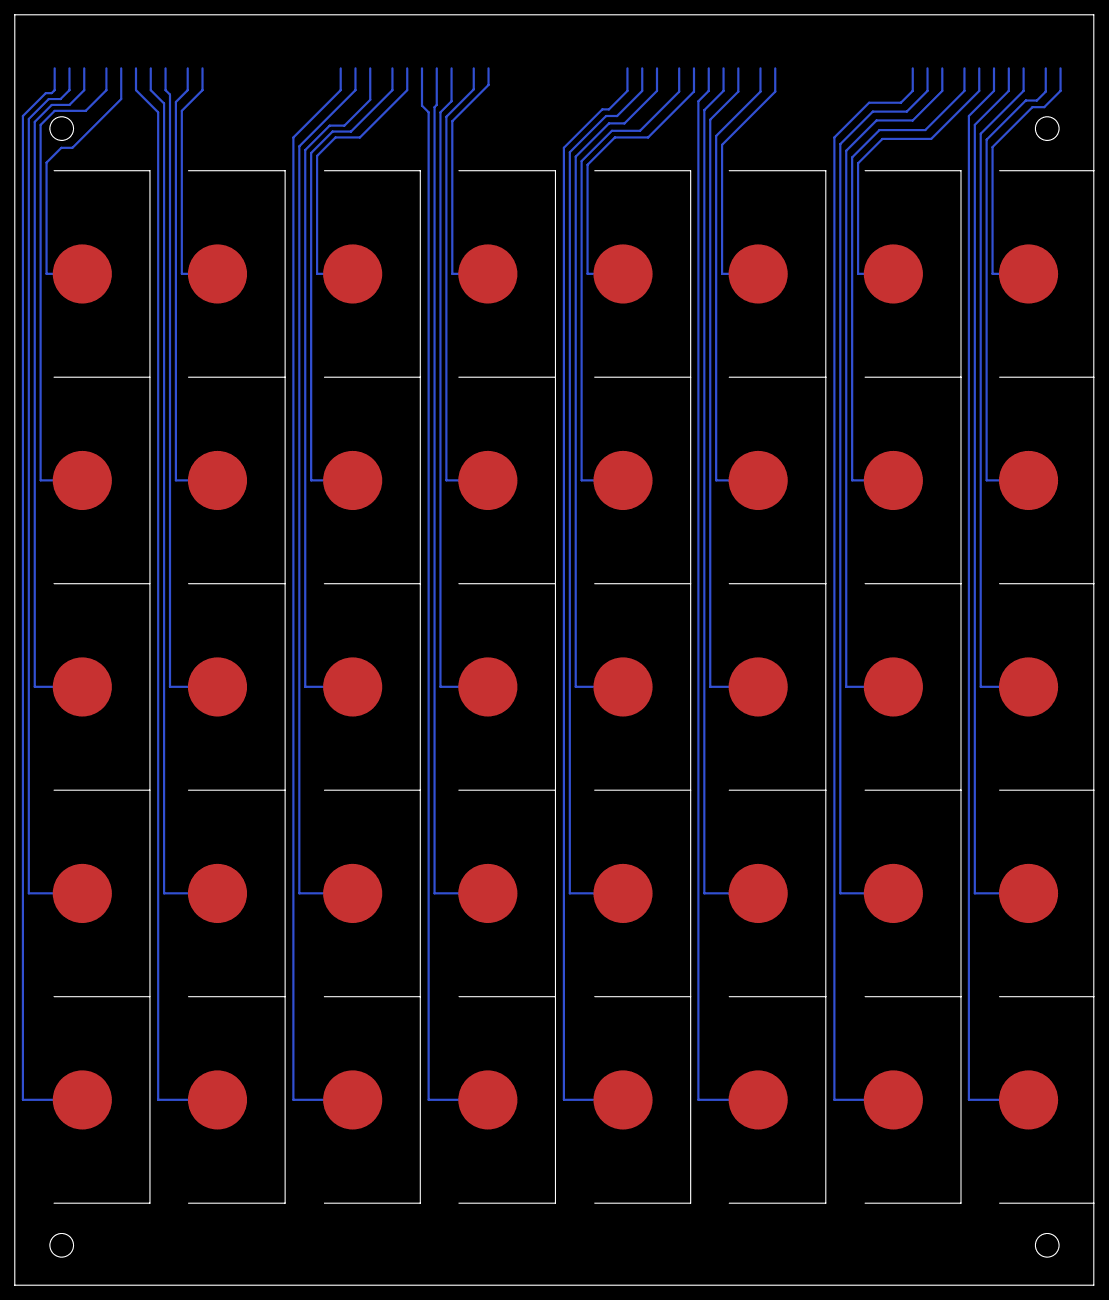
[picture p27: board piezo-layer_v0.95-R002.brd from above]

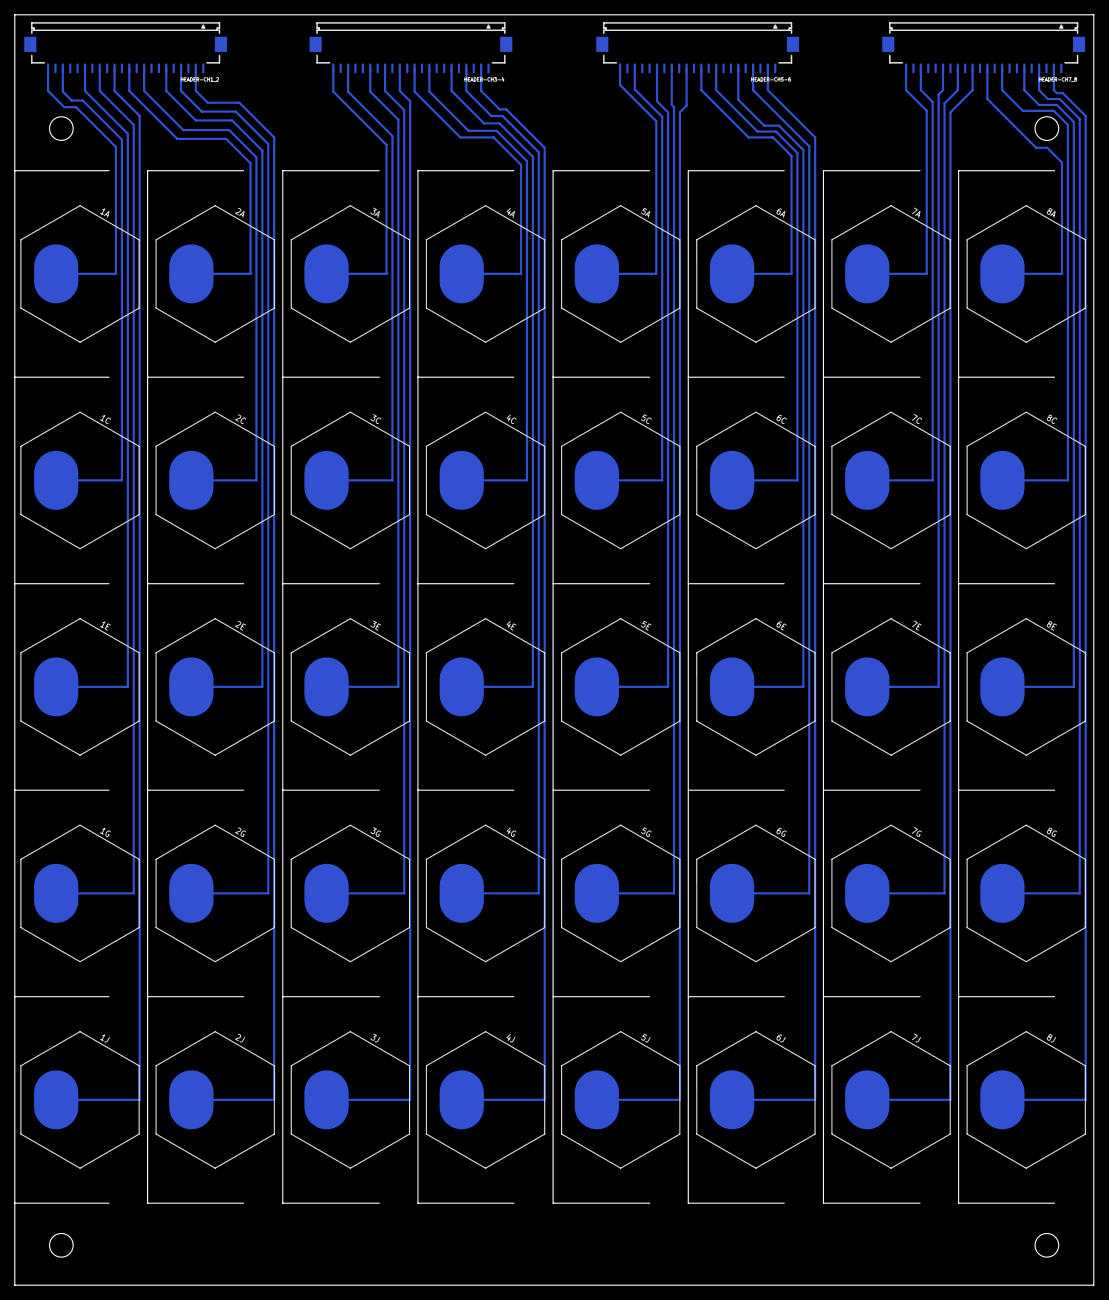
[picture p28: board piezo-layer_v0.95-R002.brd from below]

Board: 2 copper layers, 146.0 x 171.9 mm, 44 parts (44 on the bottom side), 48 nets.
