ICST-AHMI/HSoundplane_design/eagle/piezo-driver/piezo-driver_v0.2-R001.brd

## EAGLE design eagle/piezo-driver/piezo-driver_v0.2-R001.brd (2015-09-08, an earlier design)

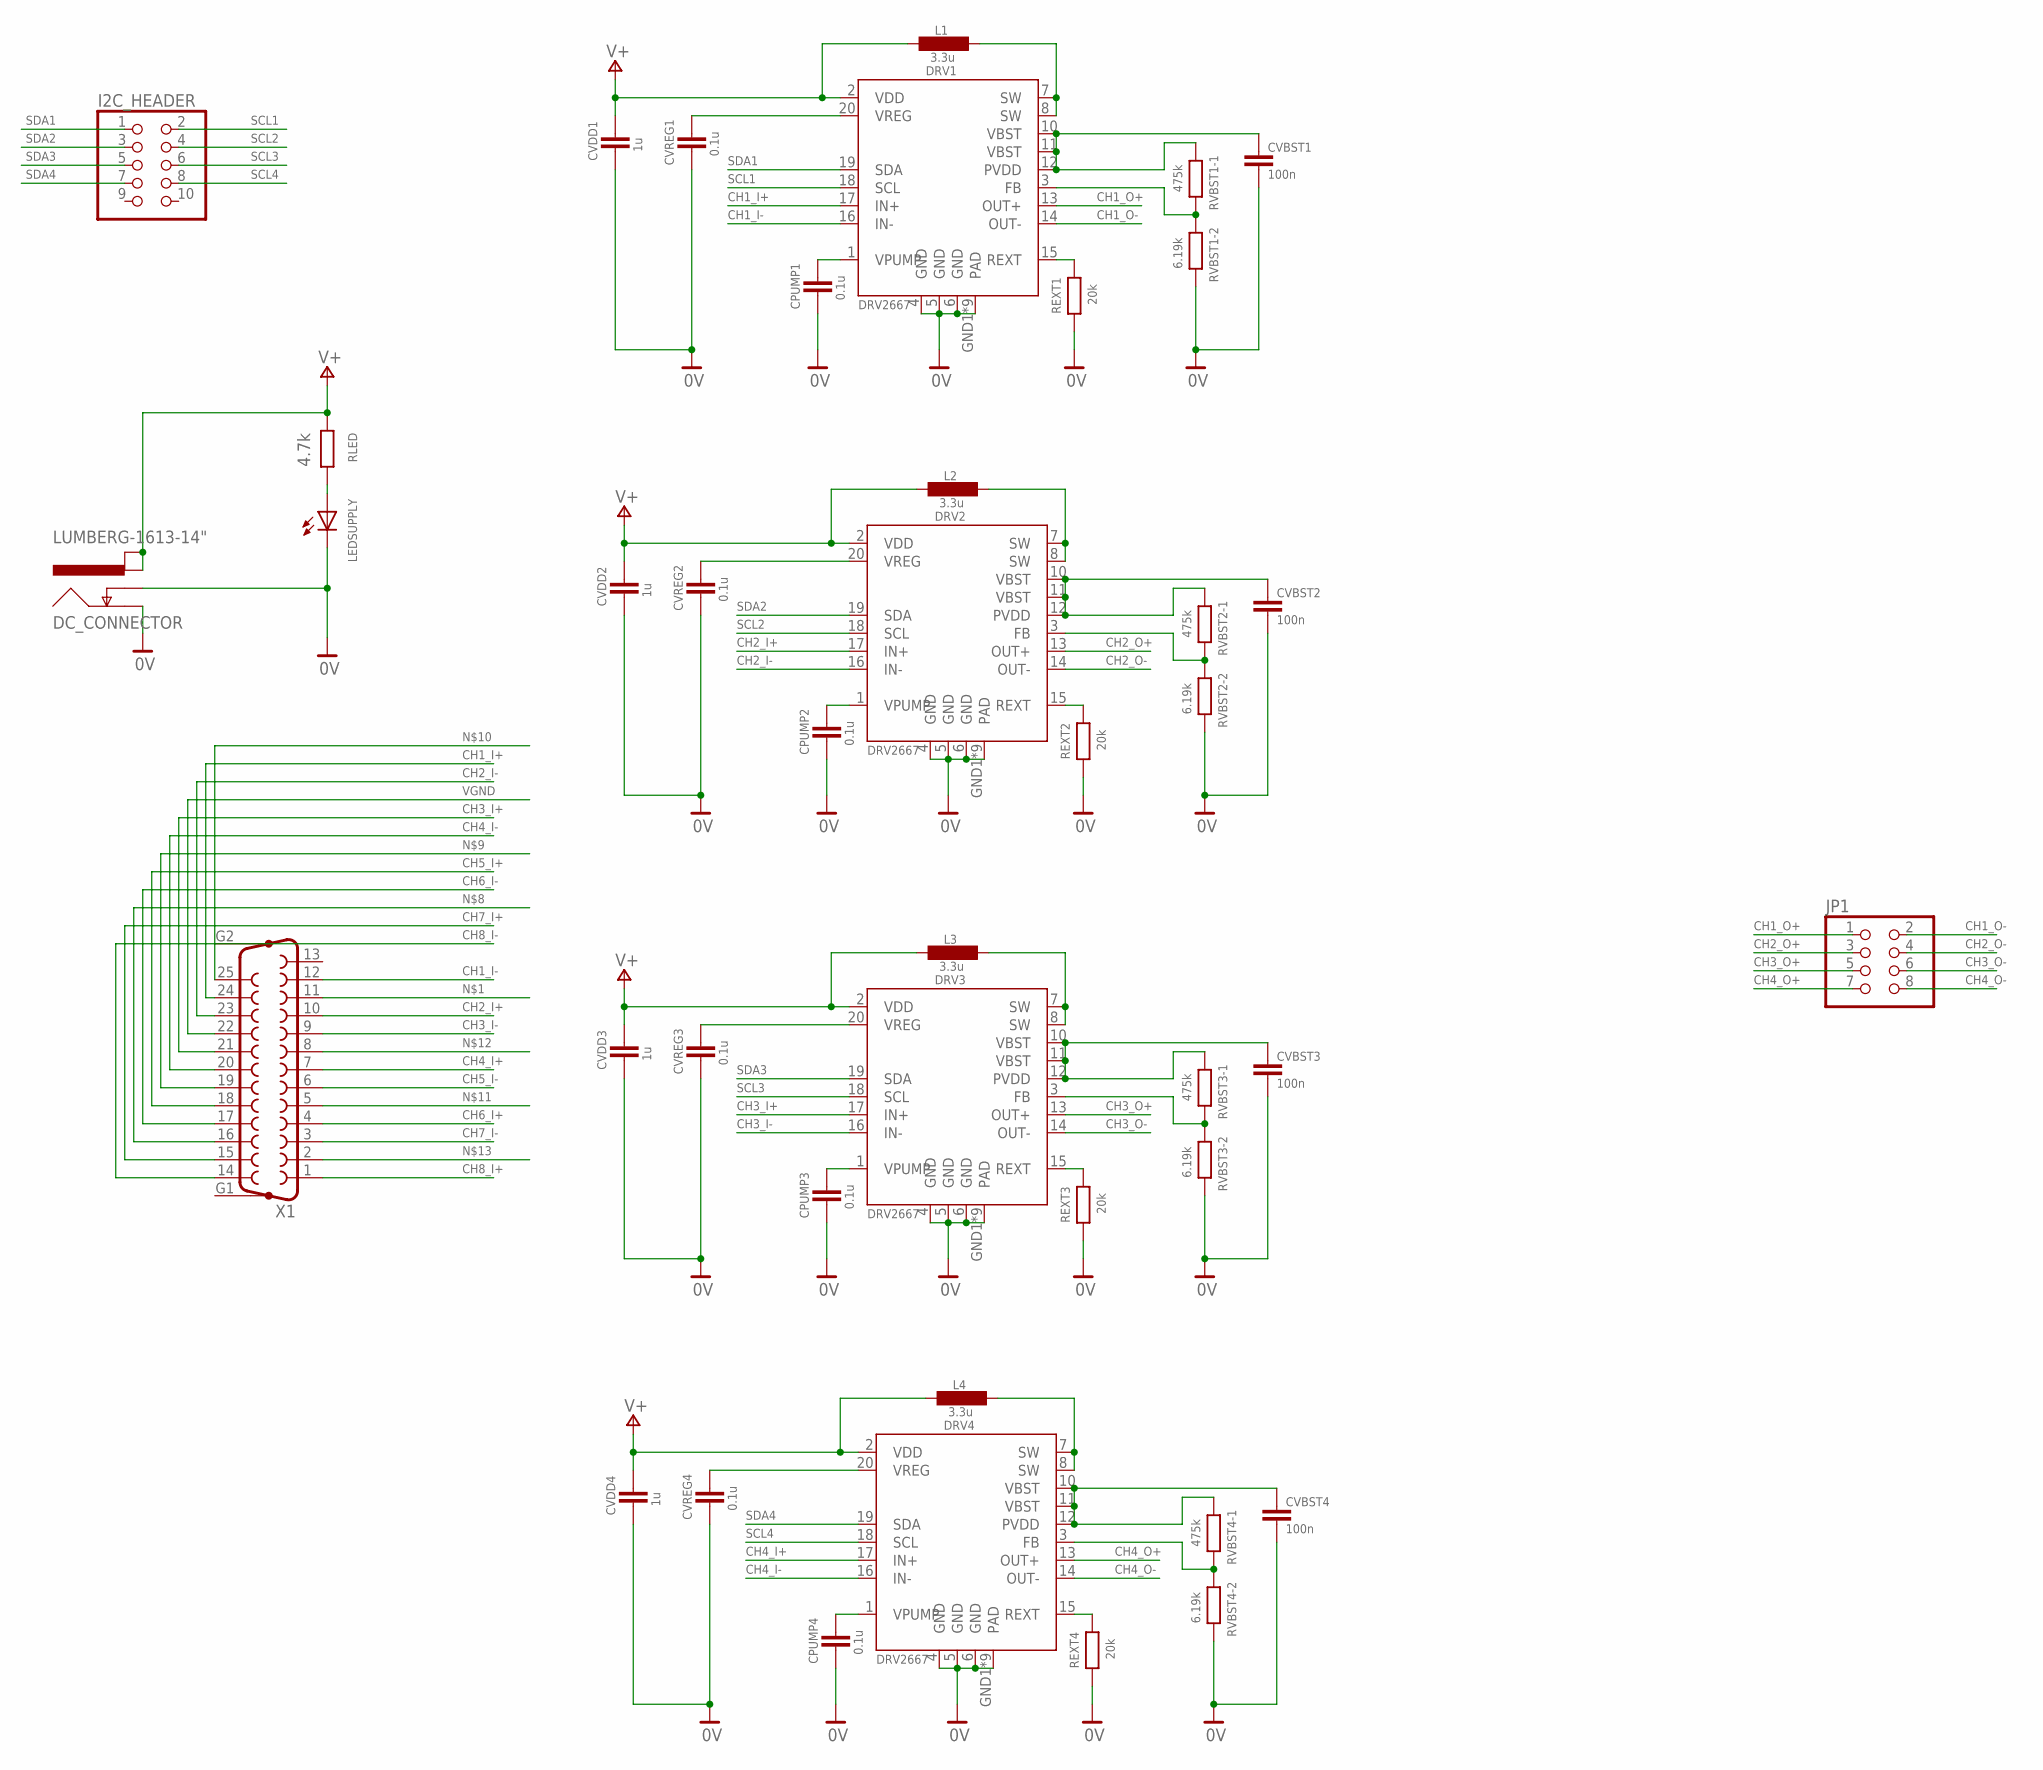
[picture p29: schematic piezo-driver_v0.2-R001.sch]

Parts:
CPUMP1, CPUMP2, CPUMP3, CPUMP4: 0.1u; C0805
CVBST1, CVBST2, CVBST3, CVBST4: 100n; C0805
CVDD1, CVDD2, CVDD3, CVDD4: 1u; C0805
CVREG1, CVREG2, CVREG3, CVREG4: 0.1u; C0805
DC_CONNECTOR: LUMBERG-1613-14"; LUMBERG-1613_14
DRV1, DRV2, DRV3, DRV4: DRV2667QFN; QFN400X400
I2C_HEADER: HEADER_2X52.54_FEMALE; 2X05_2.54
JP1: PINHD-2X4/90; 2X04/90
L1, L2, L3, L4: 3.3u; L3225M
LEDSUPPLY: LED0603; LED-0603
REXT1, REXT2, REXT3, REXT4: 20k; R0805
RLED: 4.7k; R0805
RVBST1-1, RVBST2-1, RVBST3-1, RVBST4-1: 475k; R0805
RVBST1-2, RVBST2-2, RVBST3-2, RVBST4-2: 6.19k; R0805
X1: F25HP

Connections:
0V: CPUMP1.2, CPUMP2.2, CPUMP3.2, CPUMP4.2, CVBST1.2, CVBST2.2, CVBST3.2, CVBST4.2, CVDD1.2, CVDD2.2, CVDD3.2, CVDD4.2, CVREG1.2, CVREG2.2, CVREG3.2, CVREG4.2, DC_CONNECTOR.1 (GND), DC_CONNECTOR.2 (GND_INS), DRV1.4 (GND), DRV1.5 (GND), DRV1.6 (GND), DRV1.GND1 (PAD), DRV1.GND2 (PAD), DRV1.GND3 (PAD), DRV1.GND4 (PAD), DRV1.GND5 (PAD), DRV1.GND6 (PAD), DRV1.GND7 (PAD), DRV1.GND8 (PAD), DRV1.GND9 (PAD), DRV2.4 (GND), DRV2.5 (GND), DRV2.6 (GND), DRV2.GND1 (PAD), DRV2.GND2 (PAD), DRV2.GND3 (PAD), DRV2.GND4 (PAD), DRV2.GND5 (PAD), DRV2.GND6 (PAD), DRV2.GND7 (PAD), DRV2.GND8 (PAD), DRV2.GND9 (PAD), DRV3.4 (GND), DRV3.5 (GND), DRV3.6 (GND), DRV3.GND1 (PAD), DRV3.GND2 (PAD), DRV3.GND3 (PAD), DRV3.GND4 (PAD), DRV3.GND5 (PAD), DRV3.GND6 (PAD), DRV3.GND7 (PAD), DRV3.GND8 (PAD), DRV3.GND9 (PAD), DRV4.4 (GND), DRV4.5 (GND), DRV4.6 (GND), DRV4.GND1 (PAD), DRV4.GND2 (PAD), DRV4.GND3 (PAD), DRV4.GND4 (PAD), DRV4.GND5 (PAD), DRV4.GND6 (PAD), DRV4.GND7 (PAD), DRV4.GND8 (PAD), DRV4.GND9 (PAD), LEDSUPPLY.C, REXT1.1, REXT2.1, REXT3.1, REXT4.1, RVBST1-2.1, RVBST2-2.1, RVBST3-2.1, RVBST4-2.1
CH1_I+: DRV1.17 (IN+), X1.24
CH1_I-: DRV1.16 (IN-), X1.12
CH1_O+: DRV1.13 (OUT+), JP1.1
CH1_O-: DRV1.14 (OUT-), JP1.2
CH2_I+: DRV2.17 (IN+), X1.10
CH2_I-: DRV2.16 (IN-), X1.23
CH2_O+: DRV2.13 (OUT+), JP1.3
CH2_O-: DRV2.14 (OUT-), JP1.4
CH3_I+: DRV3.17 (IN+), X1.21
CH3_I-: DRV3.16 (IN-), X1.9
CH3_O+: DRV3.13 (OUT+), JP1.5
CH3_O-: DRV3.14 (OUT-), JP1.6
CH4_I+: DRV4.17 (IN+), X1.7
CH4_I-: DRV4.16 (IN-), X1.20
CH4_O+: DRV4.13 (OUT+), JP1.7
CH4_O-: DRV4.14 (OUT-), JP1.8
CH5_I+: X1.18
CH5_I-: X1.6
CH6_I+: X1.4
CH6_I-: X1.17
CH7_I+: X1.15
CH7_I-: X1.3
CH8_I+: X1.1
CH8_I-: X1.14
unnamed: DRV1.7 (SW), DRV1.8 (SW), L1.1
unnamed: CVBST1.1, DRV1.10 (VBST), DRV1.11 (VBST), DRV1.12 (PVDD), RVBST1-1.2
unnamed: DRV1.3 (FB), RVBST1-1.1, RVBST1-2.2
unnamed: DRV1.15 (REXT), REXT1.2
unnamed: CPUMP1.1, DRV1.1 (VPUMP)
unnamed: CVREG1.1, DRV1.20 (VREG)
unnamed: LEDSUPPLY.A, RLED.1
unnamed: DRV2.7 (SW), DRV2.8 (SW), L2.1
unnamed: CVBST2.1, DRV2.10 (VBST), DRV2.11 (VBST), DRV2.12 (PVDD), RVBST2-1.2
unnamed: DRV2.3 (FB), RVBST2-1.1, RVBST2-2.2
unnamed: DRV2.15 (REXT), REXT2.2
unnamed: CPUMP2.1, DRV2.1 (VPUMP)
unnamed: CVREG2.1, DRV2.20 (VREG)
unnamed: DRV3.7 (SW), DRV3.8 (SW), L3.1
unnamed: CVBST3.1, DRV3.10 (VBST), DRV3.11 (VBST), DRV3.12 (PVDD), RVBST3-1.2
unnamed: DRV3.3 (FB), RVBST3-1.1, RVBST3-2.2
unnamed: DRV3.15 (REXT), REXT3.2
unnamed: CPUMP3.1, DRV3.1 (VPUMP)
unnamed: CVREG3.1, DRV3.20 (VREG)
unnamed: DRV4.7 (SW), DRV4.8 (SW), L4.1
unnamed: CVBST4.1, DRV4.10 (VBST), DRV4.11 (VBST), DRV4.12 (PVDD), RVBST4-1.2
unnamed: DRV4.3 (FB), RVBST4-1.1, RVBST4-2.2
unnamed: DRV4.15 (REXT), REXT4.2
unnamed: CPUMP4.1, DRV4.1 (VPUMP)
unnamed: CVREG4.1, DRV4.20 (VREG)
SCL1: DRV1.18 (SCL), I2C_HEADER.2
SCL2: DRV2.18 (SCL), I2C_HEADER.4
SCL3: DRV3.18 (SCL), I2C_HEADER.6
SCL4: DRV4.18 (SCL), I2C_HEADER.8
SDA1: DRV1.19 (SDA), I2C_HEADER.1
SDA2: DRV2.19 (SDA), I2C_HEADER.3
SDA3: DRV3.19 (SDA), I2C_HEADER.5
SDA4: DRV4.19 (SDA), I2C_HEADER.7
V+: CVDD1.1, CVDD2.1, CVDD3.1, CVDD4.1, DC_CONNECTOR.3 (PWR_1), DC_CONNECTOR.4 (PWR_2), DRV1.2 (VDD), DRV2.2 (VDD), DRV3.2 (VDD), DRV4.2 (VDD), L1.2, L2.2, L3.2, L4.2, RLED.2
VGND: X1.22

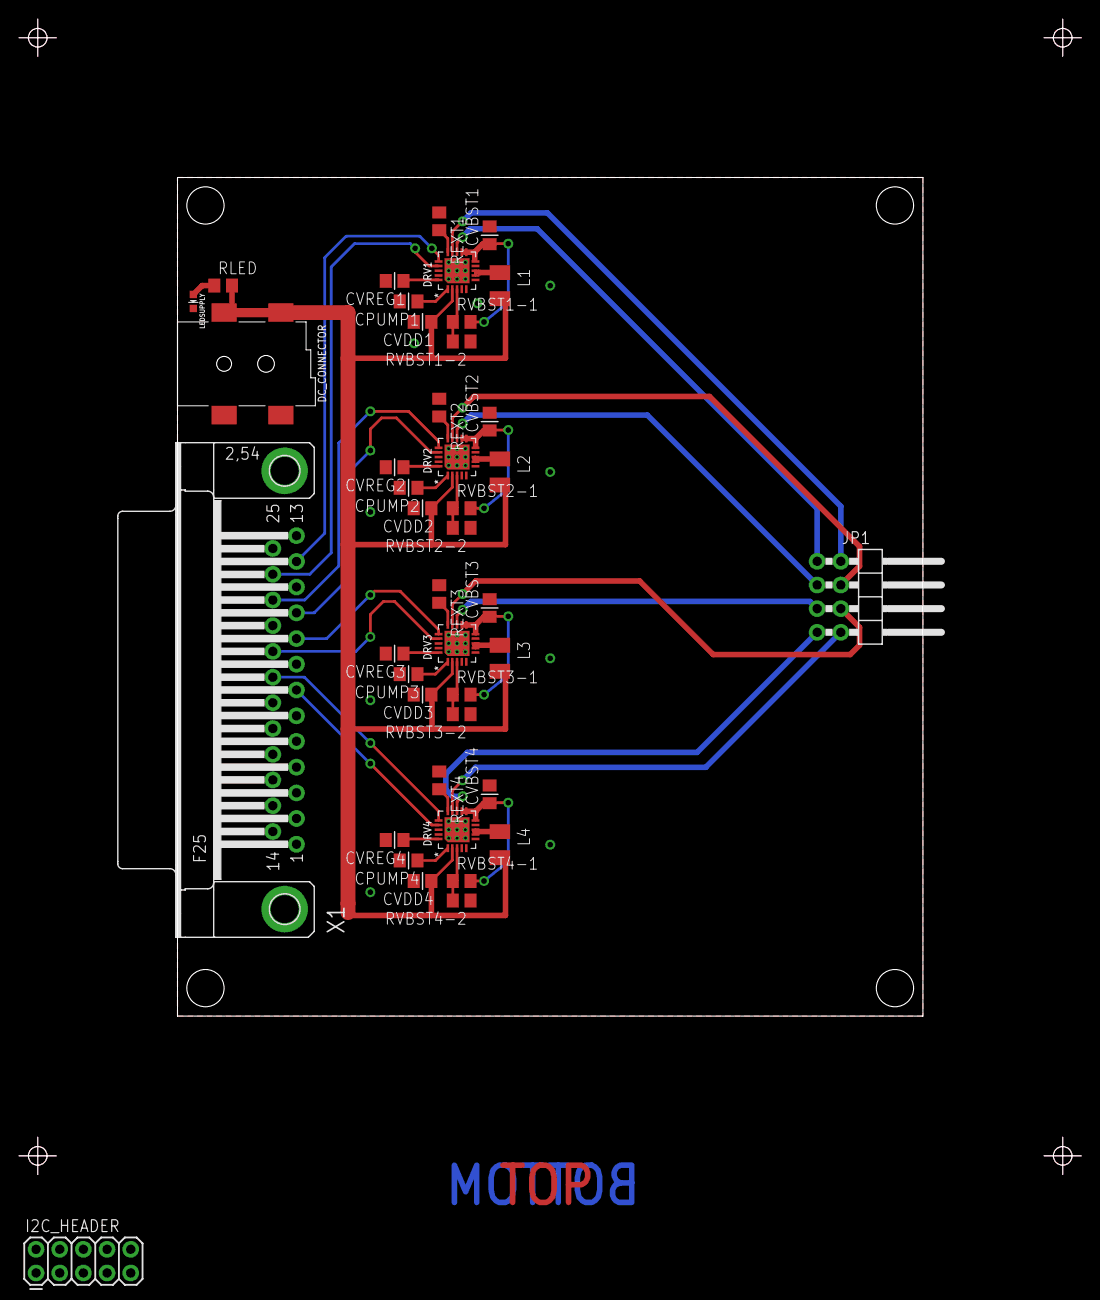
[picture p30: board piezo-driver_v0.2-R001.brd from above]

Board: 2 copper layers, 80.0 x 90.0 mm, 42 parts (0 on the bottom side), 51 nets.
