ICST-AHMI/HSoundplane_design/eagle/piezo-layer/piezo-layer_v0.95-R006.brd

## EAGLE design eagle/piezo-layer/piezo-layer_v0.95-R006.brd (2015-09-08)

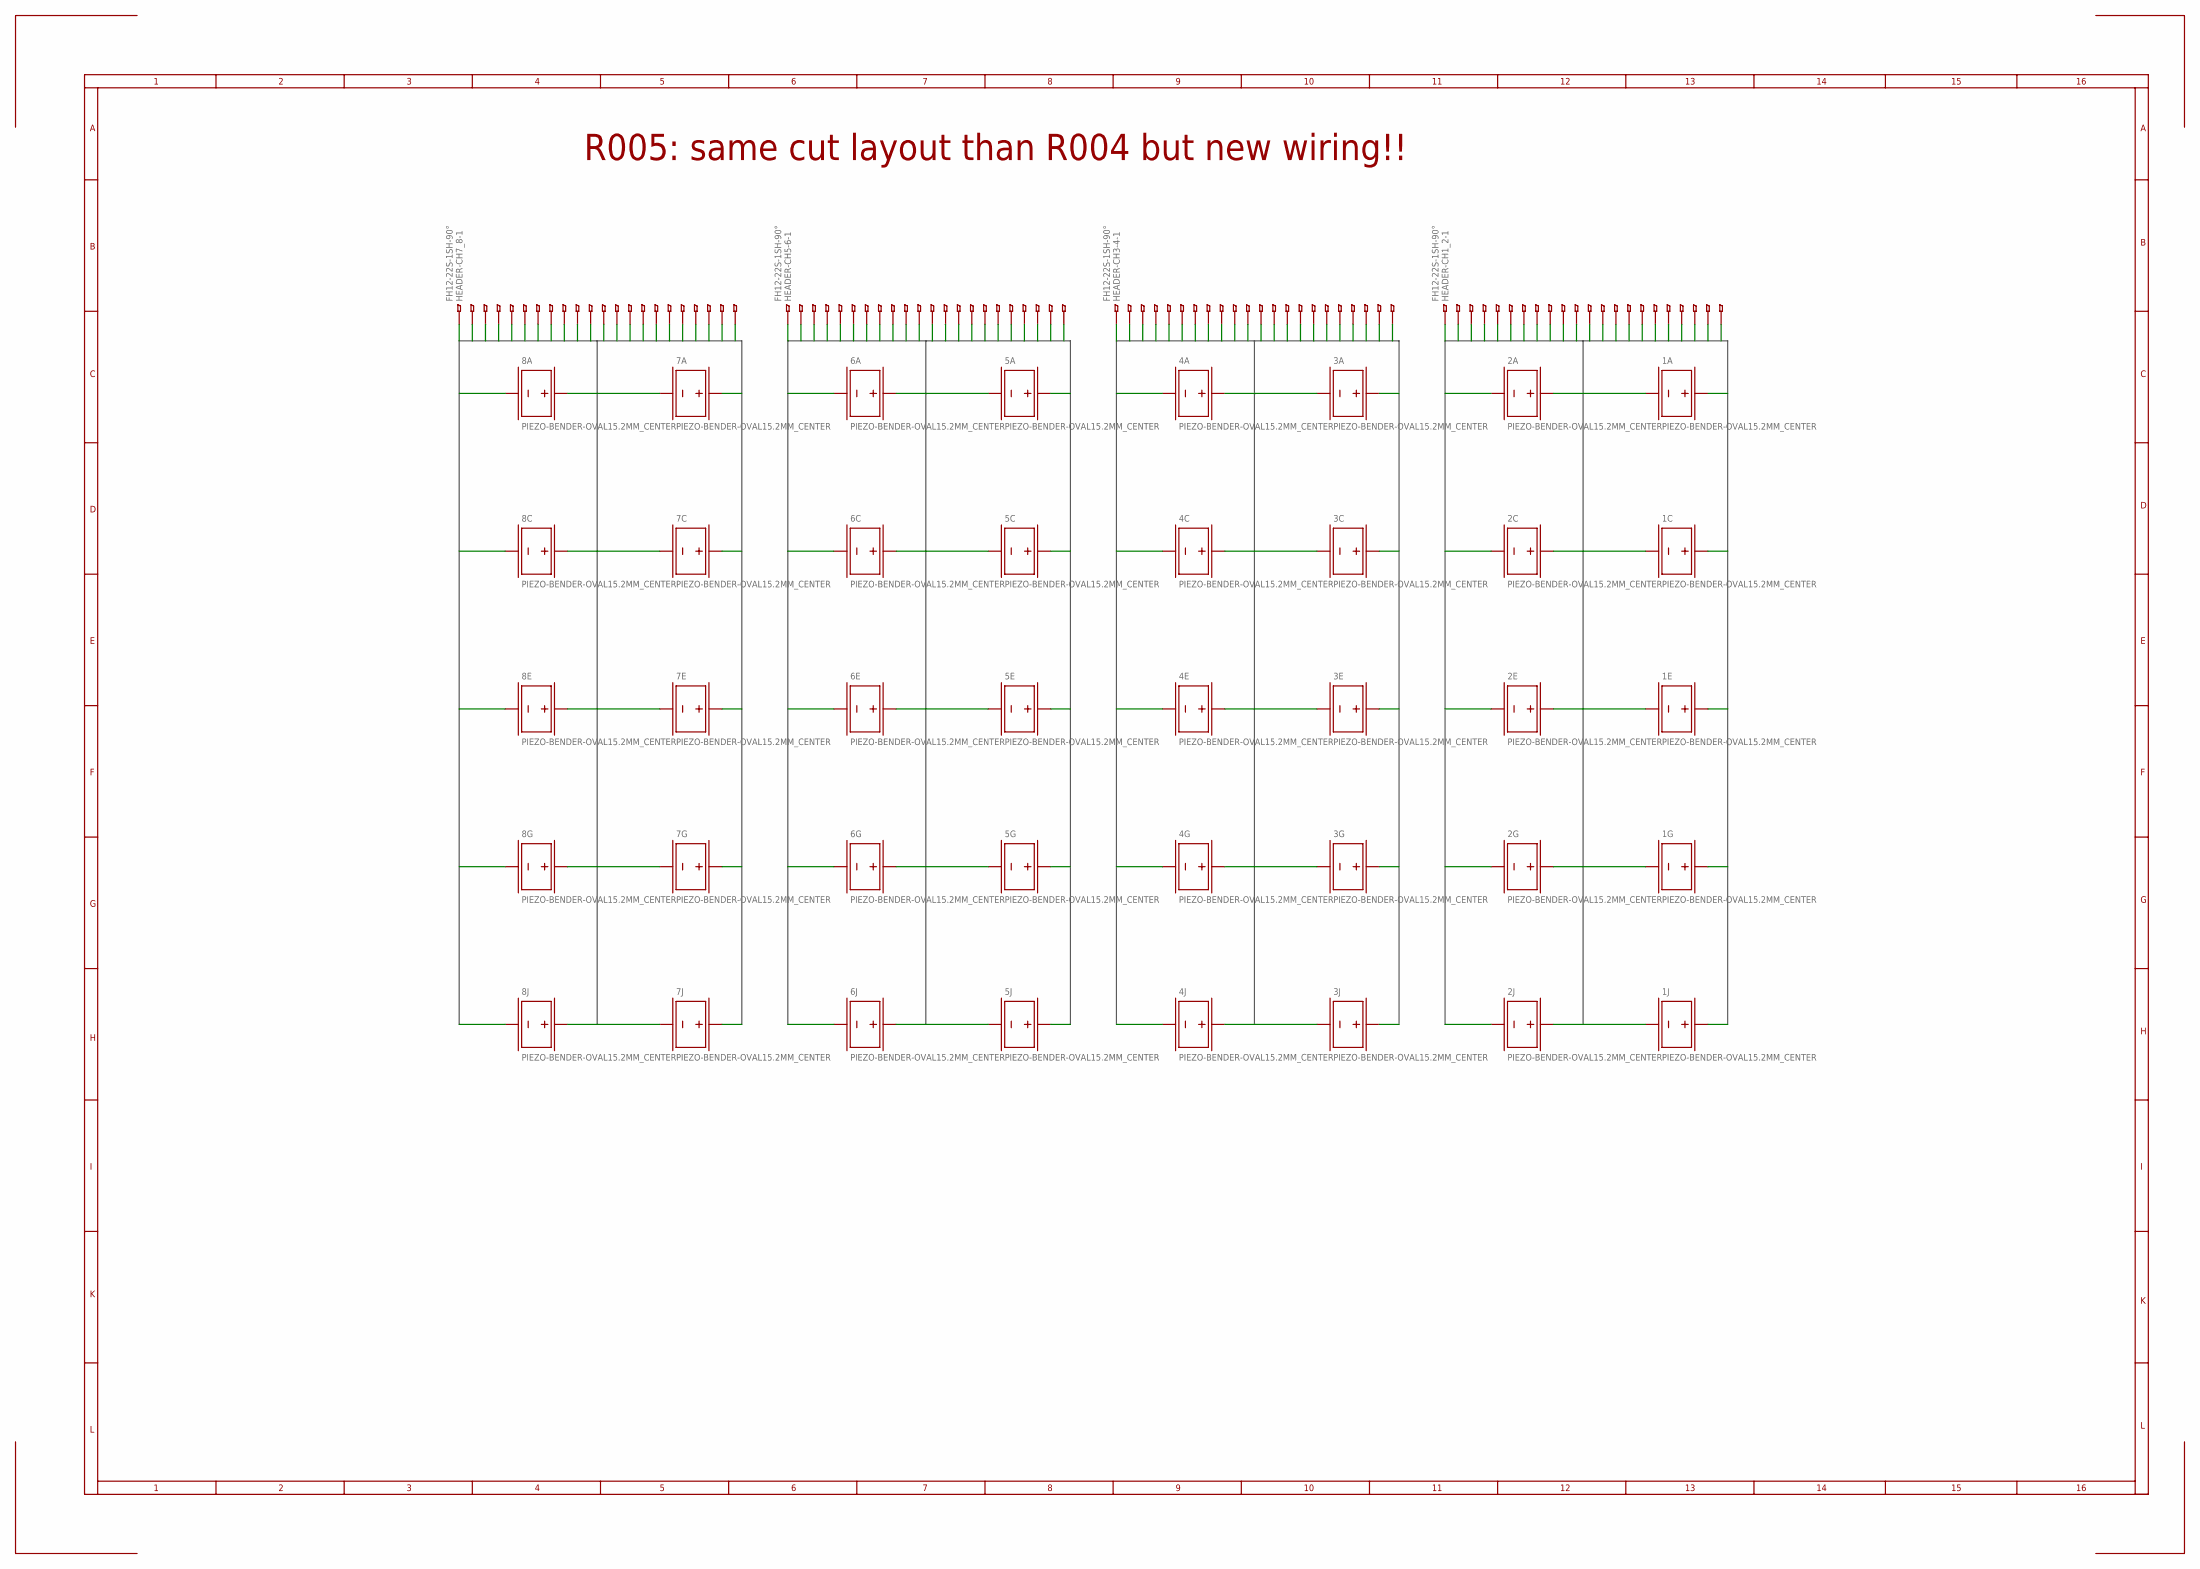
[picture p31: schematic piezo-layer_v0.95-R006.sch]

Parts:
1A, 1C, 1E, 1G, 1J, 2A, 2C, 2E, 2G, 2J, 3A, 3C, 3E, 3G, 3J, 4A, 4C, 4E, 4G, 4J, 5A, 5C, 5E, 5G, 5J, 6A, 6C, 6E, 6G, 6J, 7A, 7C, 7E, 7G, 7J, 8A, 8C, 8E, 8G, 8J: PIEZO-BENDER-OVAL15.2MM_CENTER; PIEZO-BENDER-OVAL_15.2MM_BIGPADS_CENTER
HEADER-CH1_2, HEADER-CH3-4, HEADER-CH5-6, HEADER-CH7_8: FH12-22S-1SH-90°; FH12-22S-1SH

Connections:
BUS1: 1J.TOP (+_1), HEADER-CH1_2.21
BUS2: HEADER-CH1_2.20
BUS3: 1G.TOP (+_1), HEADER-CH1_2.19
BUS4: HEADER-CH1_2.18
BUS5: 1A.BOTTOM (-_1), 1C.BOTTOM (-_1), 1E.BOTTOM (-_1), 1G.BOTTOM (-_1), 1J.BOTTOM (-_1), HEADER-CH1_2.16, HEADER-CH1_2.22
BUS6: 1E.TOP (+_1), HEADER-CH1_2.17
BUS7: HEADER-CH1_2.15
BUS8: 1C.TOP (+_1), HEADER-CH1_2.14
BUS9: HEADER-CH1_2.13
BUS10: 1A.TOP (+_1), HEADER-CH1_2.12
BUS11: 2J.TOP (+_1), HEADER-CH1_2.10
BUS12: HEADER-CH1_2.9
BUS13: 2G.TOP (+_1), HEADER-CH1_2.8
BUS14: HEADER-CH1_2.7
BUS15: 2A.BOTTOM (-_1), 2C.BOTTOM (-_1), 2E.BOTTOM (-_1), 2G.BOTTOM (-_1), 2J.BOTTOM (-_1), HEADER-CH1_2.5, HEADER-CH1_2.11
BUS16: 2E.TOP (+_1), HEADER-CH1_2.6
BUS17: HEADER-CH1_2.4
BUS18: 2C.TOP (+_1), HEADER-CH1_2.3
BUS19: HEADER-CH1_2.2
BUS20: 2A.TOP (+_1), HEADER-CH1_2.1
BUS21: 3J.TOP (+_1), HEADER-CH3-4.21
BUS22: HEADER-CH3-4.20
BUS23: 3G.TOP (+_1), HEADER-CH3-4.19
BUS24: HEADER-CH3-4.18
BUS25: 3A.BOTTOM (-_1), 3C.BOTTOM (-_1), 3E.BOTTOM (-_1), 3G.BOTTOM (-_1), 3J.BOTTOM (-_1), HEADER-CH3-4.16, HEADER-CH3-4.22
BUS26: 3E.TOP (+_1), HEADER-CH3-4.17
BUS27: HEADER-CH3-4.15
BUS28: 3C.TOP (+_1), HEADER-CH3-4.14
BUS29: HEADER-CH3-4.13
BUS30: 3A.TOP (+_1), HEADER-CH3-4.12
BUS31: 4J.TOP (+_1), HEADER-CH3-4.10
BUS32: HEADER-CH3-4.9
BUS33: 4G.TOP (+_1), HEADER-CH3-4.8
BUS34: HEADER-CH3-4.7
BUS35: 4A.BOTTOM (-_1), 4C.BOTTOM (-_1), 4E.BOTTOM (-_1), 4G.BOTTOM (-_1), 4J.BOTTOM (-_1), HEADER-CH3-4.5, HEADER-CH3-4.11
BUS36: 4E.TOP (+_1), HEADER-CH3-4.6
BUS37: HEADER-CH3-4.4
BUS38: 4C.TOP (+_1), HEADER-CH3-4.3
BUS39: HEADER-CH3-4.2
BUS40: 4A.TOP (+_1), HEADER-CH3-4.1
BUS41: 5J.TOP (+_1), HEADER-CH5-6.21
BUS42: HEADER-CH5-6.20
BUS43: 5G.TOP (+_1), HEADER-CH5-6.19
BUS44: HEADER-CH5-6.18
BUS45: 5A.BOTTOM (-_1), 5C.BOTTOM (-_1), 5E.BOTTOM (-_1), 5G.BOTTOM (-_1), 5J.BOTTOM (-_1), HEADER-CH5-6.16, HEADER-CH5-6.22
BUS46: 5E.TOP (+_1), HEADER-CH5-6.17
BUS47: HEADER-CH5-6.15
BUS48: 5C.TOP (+_1), HEADER-CH5-6.14
BUS49: HEADER-CH5-6.13
BUS50: 5A.TOP (+_1), HEADER-CH5-6.12
BUS51: 6J.TOP (+_1), HEADER-CH5-6.10
BUS52: HEADER-CH5-6.9
BUS53: 6G.TOP (+_1), HEADER-CH5-6.8
BUS54: HEADER-CH5-6.7
BUS55: 6A.BOTTOM (-_1), 6C.BOTTOM (-_1), 6E.BOTTOM (-_1), 6G.BOTTOM (-_1), 6J.BOTTOM (-_1), HEADER-CH5-6.5, HEADER-CH5-6.11
BUS56: 6E.TOP (+_1), HEADER-CH5-6.6
BUS57: HEADER-CH5-6.4
BUS58: 6C.TOP (+_1), HEADER-CH5-6.3
BUS59: HEADER-CH5-6.2
BUS60: 6A.TOP (+_1), HEADER-CH5-6.1
BUS61: 7J.TOP (+_1), HEADER-CH7_8.21
BUS62: HEADER-CH7_8.20
BUS63: 7G.TOP (+_1), HEADER-CH7_8.19
BUS64: HEADER-CH7_8.18
BUS65: 7A.BOTTOM (-_1), 7C.BOTTOM (-_1), 7E.BOTTOM (-_1), 7G.BOTTOM (-_1), 7J.BOTTOM (-_1), HEADER-CH7_8.16, HEADER-CH7_8.22
BUS66: 7E.TOP (+_1), HEADER-CH7_8.17
BUS67: HEADER-CH7_8.15
BUS68: 7C.TOP (+_1), HEADER-CH7_8.14
BUS69: HEADER-CH7_8.13
BUS70: 7A.TOP (+_1), HEADER-CH7_8.12
BUS71: 8J.TOP (+_1), HEADER-CH7_8.10
BUS72: HEADER-CH7_8.9
BUS73: 8G.TOP (+_1), HEADER-CH7_8.8
BUS74: HEADER-CH7_8.7
BUS75: 8A.BOTTOM (-_1), 8C.BOTTOM (-_1), 8E.BOTTOM (-_1), 8G.BOTTOM (-_1), 8J.BOTTOM (-_1), HEADER-CH7_8.5, HEADER-CH7_8.11
BUS76: 8E.TOP (+_1), HEADER-CH7_8.6
BUS77: HEADER-CH7_8.4
BUS78: 8C.TOP (+_1), HEADER-CH7_8.3
BUS79: HEADER-CH7_8.2
BUS80: 8A.TOP (+_1), HEADER-CH7_8.1

Notes on the sheet:
R005: same cut layout than R004 but new wiring!!
