ICST-AHMI/HSoundplane_design/eagle/piezo-layer/piezo-layer_v0.95-R006.brd

## EAGLE design eagle/piezo-layer/piezo-layer_v0.95-R006.brd (continued)

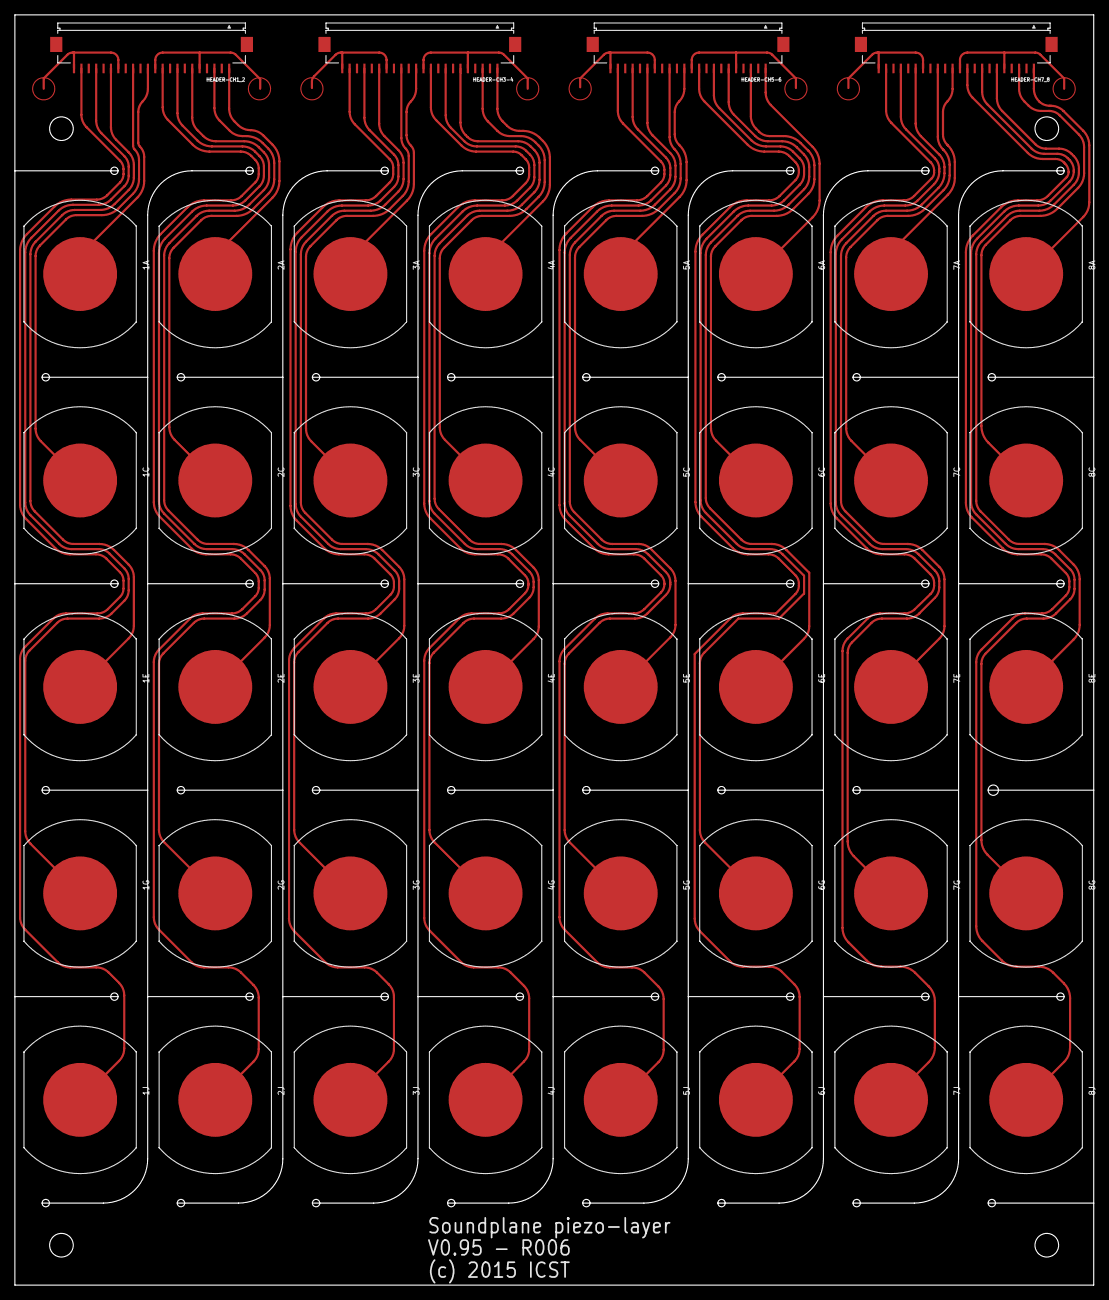
[picture p32: board piezo-layer_v0.95-R006.brd from above]

Board: 2 copper layers, 146.0 x 171.9 mm, 44 parts (0 on the bottom side), 48 nets.
