ICST-AHMI/HSoundplane_design/eagle/piezo-layer/piezo-layer_v0.1-R003.brd

## EAGLE design eagle/piezo-layer/piezo-layer_v0.1-R003.brd (2015-09-08, an earlier design)

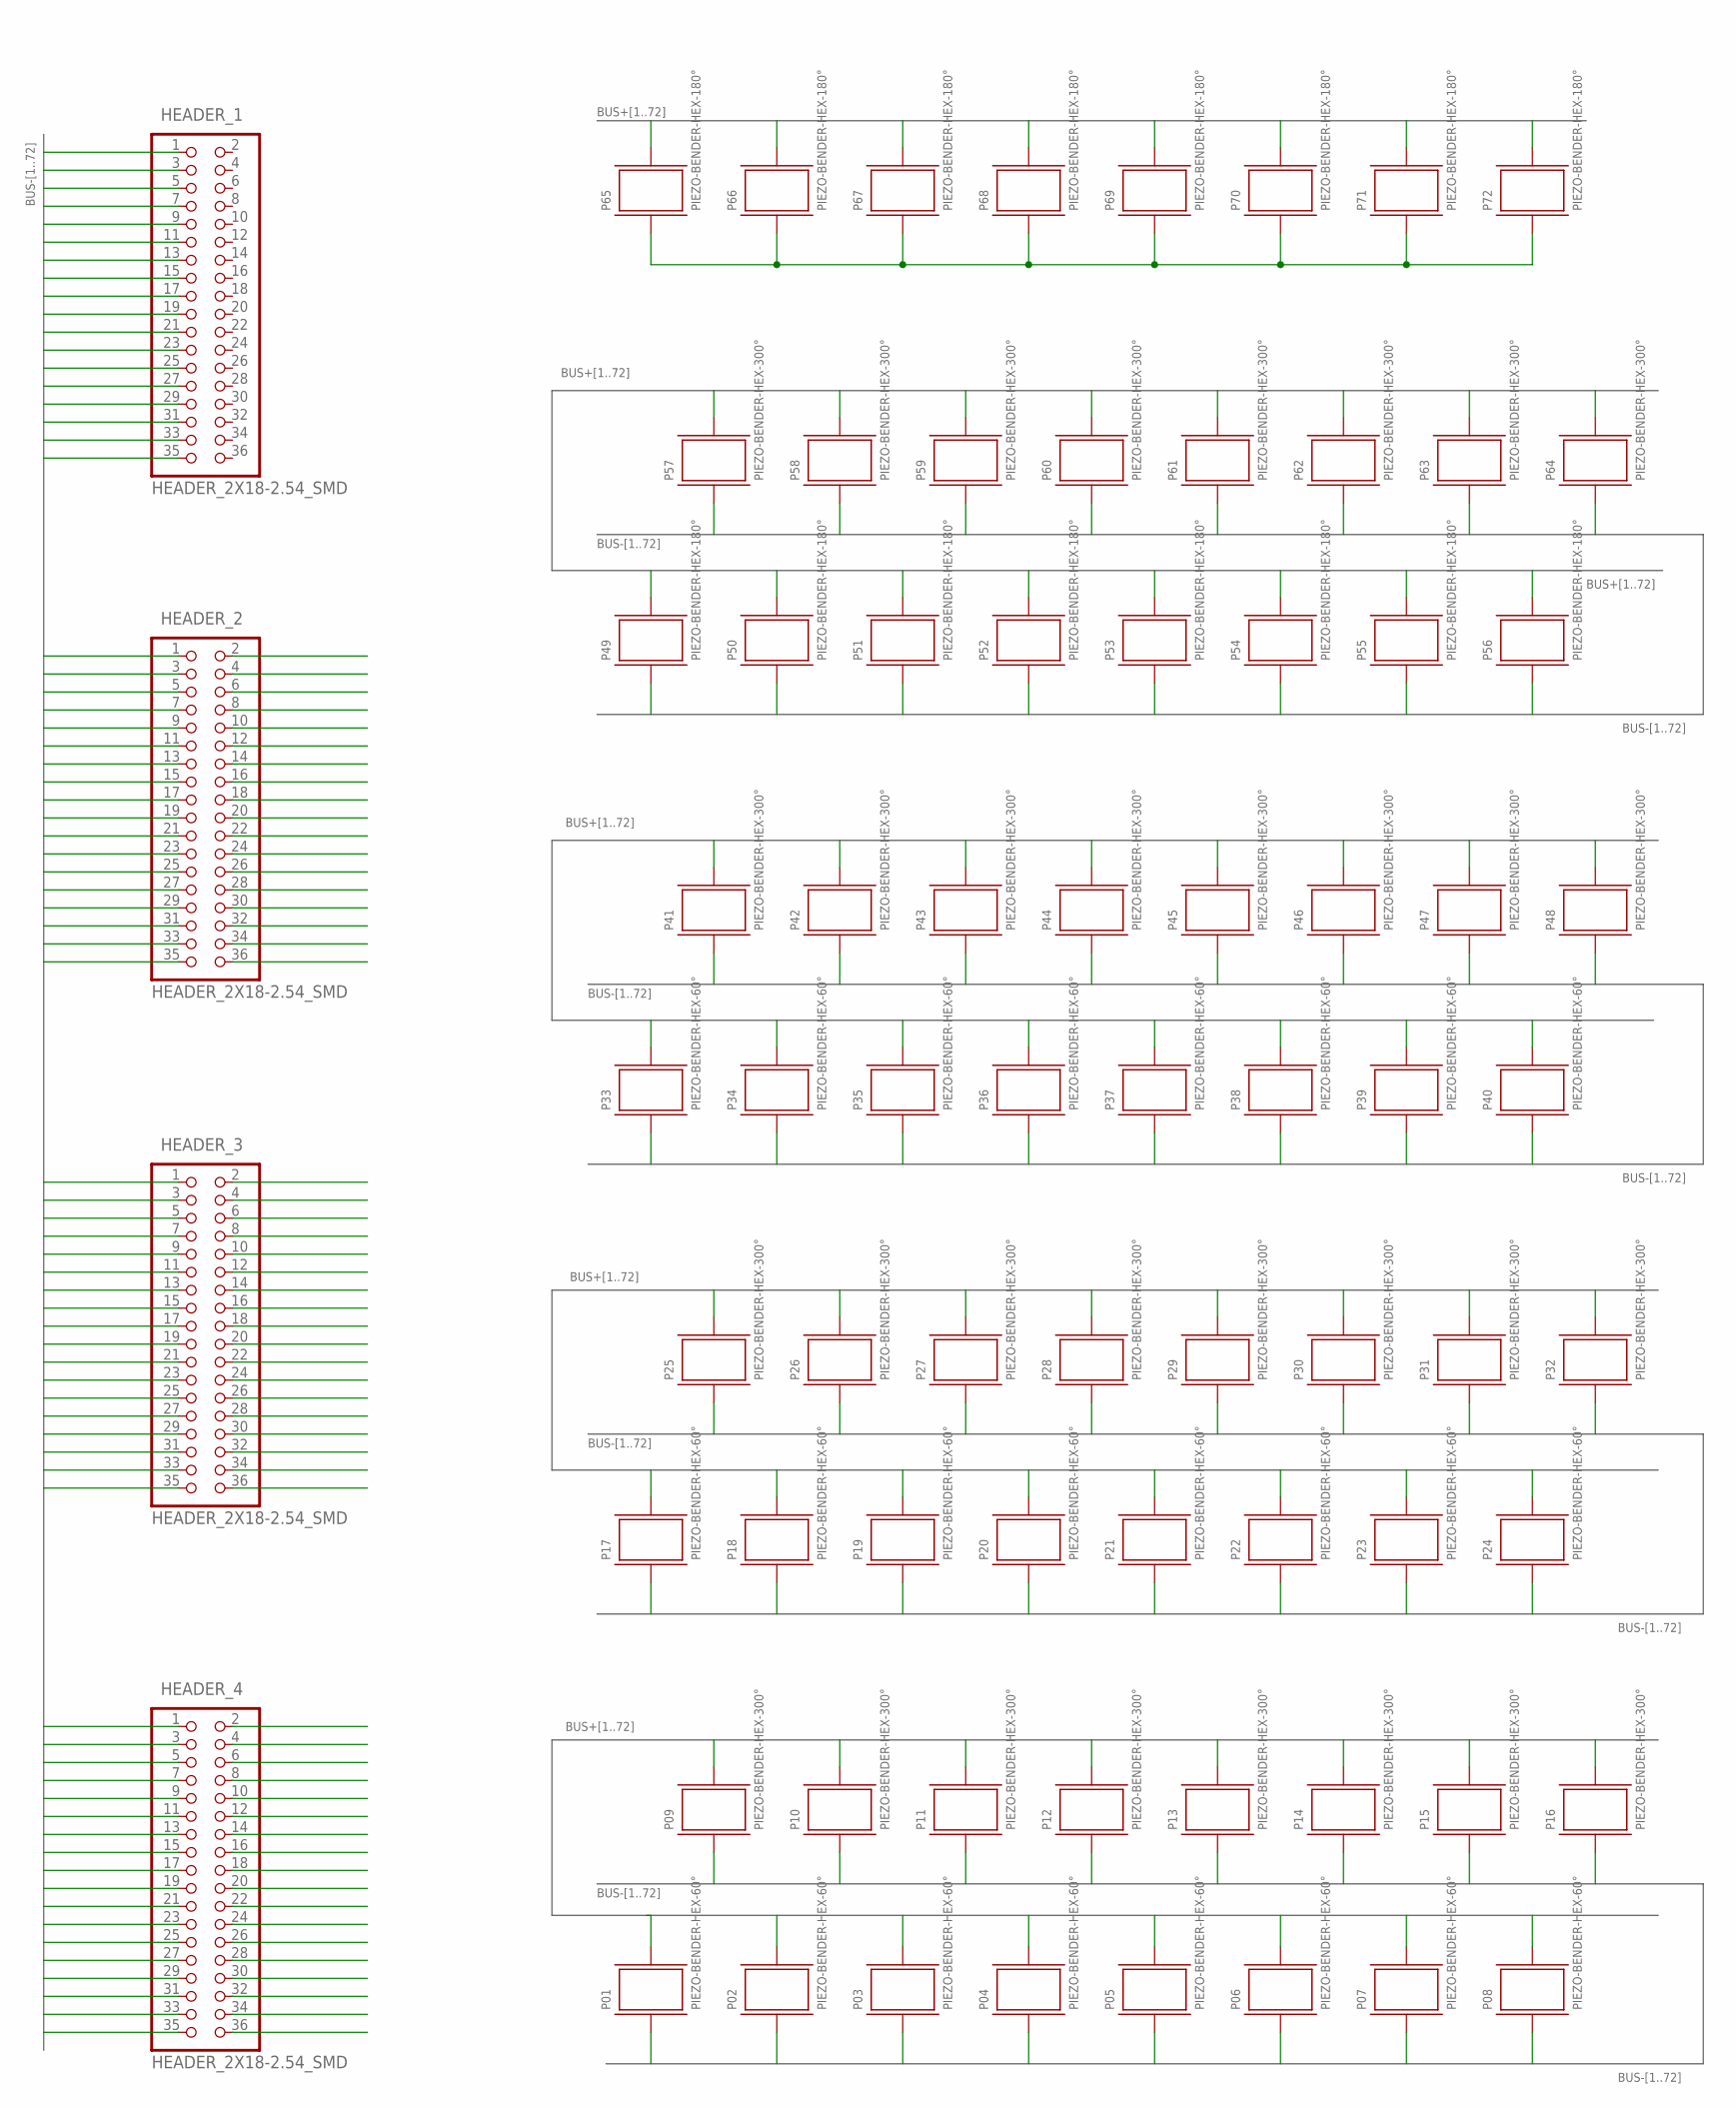
[picture p33: schematic piezo-layer_v0.1-R003.sch]

Parts:
HEADER_1, HEADER_2, HEADER_3, HEADER_4: HEADER_2X18-2.54_SMD; 2X18_2.54_SMD
P01, P02, P03, P04, P05, P06, P07, P08, P17, P18, P19, P20, P21, P22, P23, P24, P33, P34, P35, P36, P37, P38, P39, P40: PIEZO-BENDER-HEX-60°; PIEZO-BENDER-HEX_16MM_60°
P09, P10, P11, P12, P13, P14, P15, P16, P25, P26, P27, P28, P29, P30, P31, P32, P41, P42, P43, P44, P45, P46, P47, P48, P57, P58, P59, P60, P61, P62, P63, P64: PIEZO-BENDER-HEX-300°; PIEZO-BENDER-HEX_16MM_300°
P49, P50, P51, P52, P53, P54, P55, P56, P65, P66, P67, P68, P69, P70, P71, P72: PIEZO-BENDER-HEX-180°; PIEZO-BENDER-HEX_16MM_180°

Connections:
BUS+1: P01.TIP1 (+_1)
BUS+2: P02.TIP1 (+_1)
BUS+3: HEADER_2.18, P03.TIP1 (+_1)
BUS+4: HEADER_2.36, P04.TIP1 (+_1)
BUS+5: HEADER_3.18, P05.TIP1 (+_1)
BUS+6: HEADER_3.36, P06.TIP1 (+_1)
BUS+7: HEADER_4.18, P07.TIP1 (+_1)
BUS+8: HEADER_4.36, P08.TIP1 (+_1)
BUS+9: P09.TIP1 (+_1)
BUS+10: P10.TIP1 (+_1)
BUS+11: HEADER_2.16, P11.TIP1 (+_1)
BUS+12: HEADER_2.34, P12.TIP1 (+_1)
BUS+13: HEADER_3.16, P13.TIP1 (+_1)
BUS+14: HEADER_3.34, P14.TIP1 (+_1)
BUS+15: HEADER_4.16, P15.TIP1 (+_1)
BUS+16: HEADER_4.34, P16.TIP1 (+_1)
BUS+17: P17.TIP1 (+_1)
BUS+18: P18.TIP1 (+_1)
BUS+19: HEADER_2.14, P19.TIP1 (+_1)
BUS+20: HEADER_2.32, P20.TIP1 (+_1)
BUS+21: HEADER_3.14, P21.TIP1 (+_1)
BUS+22: HEADER_3.32, P22.TIP1 (+_1)
BUS+23: HEADER_4.14, P23.TIP1 (+_1)
BUS+24: HEADER_4.32, P24.TIP1 (+_1)
BUS+25: P25.TIP1 (+_1)
BUS+26: P26.TIP1 (+_1)
BUS+27: HEADER_2.12, P27.TIP1 (+_1)
BUS+28: HEADER_2.30, P28.TIP1 (+_1)
BUS+29: HEADER_3.12, P29.TIP1 (+_1)
BUS+30: HEADER_3.30, P30.TIP1 (+_1)
BUS+31: HEADER_4.12, P31.TIP1 (+_1)
BUS+32: HEADER_4.30, P32.TIP1 (+_1)
BUS+33: P33.TIP1 (+_1)
BUS+34: P34.TIP1 (+_1)
BUS+35: HEADER_2.10, P35.TIP1 (+_1)
BUS+36: HEADER_2.28, P36.TIP1 (+_1)
BUS+37: HEADER_3.10, P37.TIP1 (+_1)
BUS+38: HEADER_3.28, P38.TIP1 (+_1)
BUS+39: HEADER_4.10, P39.TIP1 (+_1)
BUS+40: HEADER_4.28, P40.TIP1 (+_1)
BUS+41: P41.TIP1 (+_1)
BUS+42: P42.TIP1 (+_1)
BUS+43: HEADER_2.8, P43.TIP1 (+_1)
BUS+44: HEADER_2.26, P44.TIP1 (+_1)
BUS+45: HEADER_3.8, P45.TIP1 (+_1)
BUS+46: HEADER_3.26, P46.TIP1 (+_1)
BUS+47: HEADER_4.8, P47.TIP1 (+_1)
BUS+48: HEADER_4.26, P48.TIP1 (+_1)
BUS+49: P49.TIP1 (+_1)
BUS+50: P50.TIP1 (+_1)
BUS+51: HEADER_2.6, P51.TIP1 (+_1)
BUS+52: HEADER_2.24, P52.TIP1 (+_1)
BUS+53: HEADER_3.6, P53.TIP1 (+_1)
BUS+54: HEADER_3.24, P54.TIP1 (+_1)
BUS+55: HEADER_4.6, P55.TIP1 (+_1)
BUS+56: HEADER_4.24, P56.TIP1 (+_1)
BUS+57: P57.TIP1 (+_1)
BUS+58: P58.TIP1 (+_1)
BUS+59: HEADER_2.4, P59.TIP1 (+_1)
BUS+60: HEADER_2.22, P60.TIP1 (+_1)
BUS+61: HEADER_3.4, P61.TIP1 (+_1)
BUS+62: HEADER_3.22, P62.TIP1 (+_1)
BUS+63: HEADER_4.4, P63.TIP1 (+_1)
BUS+64: HEADER_4.22, P64.TIP1 (+_1)
BUS+65: P65.TIP1 (+_1)
BUS+66: P66.TIP1 (+_1)
BUS+67: HEADER_2.2, P67.TIP1 (+_1)
BUS+68: HEADER_2.20, P68.TIP1 (+_1)
BUS+69: HEADER_3.2, P69.TIP1 (+_1)
BUS+70: HEADER_3.20, P70.TIP1 (+_1)
BUS+71: HEADER_4.2, P71.TIP1 (+_1)
BUS+72: HEADER_4.20, P72.TIP1 (+_1)
BUS-1: HEADER_1.17, P01.PAD1 (-_1)
BUS-2: HEADER_1.35, P02.PAD1 (-_1)
BUS-3: HEADER_2.17, P03.PAD1 (-_1)
BUS-4: HEADER_2.35, P04.PAD1 (-_1)
BUS-5: HEADER_3.17, P05.PAD1 (-_1)
BUS-6: HEADER_3.35, P06.PAD1 (-_1)
BUS-7: HEADER_4.17, P07.PAD1 (-_1)
BUS-8: HEADER_4.35, P08.PAD1 (-_1)
BUS-9: HEADER_1.15, P09.PAD1 (-_1)
BUS-10: HEADER_1.33, P10.PAD1 (-_1)
BUS-11: HEADER_2.15, P11.PAD1 (-_1)
BUS-12: HEADER_2.33, P12.PAD1 (-_1)
BUS-13: HEADER_3.15, P13.PAD1 (-_1)
BUS-14: HEADER_3.33, P14.PAD1 (-_1)
BUS-15: HEADER_4.15, P15.PAD1 (-_1)
BUS-16: HEADER_4.33, P16.PAD1 (-_1)
BUS-17: HEADER_1.13, P17.PAD1 (-_1)
BUS-18: HEADER_1.31, P18.PAD1 (-_1)
BUS-19: HEADER_2.13, P19.PAD1 (-_1)
BUS-20: HEADER_2.31, P20.PAD1 (-_1)
BUS-21: HEADER_3.13, P21.PAD1 (-_1)
BUS-22: HEADER_3.31, P22.PAD1 (-_1)
BUS-23: HEADER_4.13, P23.PAD1 (-_1)
BUS-24: HEADER_4.31, P24.PAD1 (-_1)
BUS-25: HEADER_1.11, P25.PAD1 (-_1)
BUS-26: HEADER_1.29, P26.PAD1 (-_1)
BUS-27: HEADER_2.11, P27.PAD1 (-_1)
BUS-28: HEADER_2.29, P28.PAD1 (-_1)
BUS-29: HEADER_3.11, P29.PAD1 (-_1)
BUS-30: HEADER_3.29, P30.PAD1 (-_1)
BUS-31: HEADER_4.11, P31.PAD1 (-_1)
BUS-32: HEADER_4.29, P32.PAD1 (-_1)
BUS-33: HEADER_1.9, P33.PAD1 (-_1)
BUS-34: HEADER_1.27, P34.PAD1 (-_1)
BUS-35: HEADER_2.9, P35.PAD1 (-_1)
BUS-36: HEADER_2.27, P36.PAD1 (-_1)
BUS-37: HEADER_3.9, P37.PAD1 (-_1)
BUS-38: HEADER_3.27, P38.PAD1 (-_1)
BUS-39: HEADER_4.9, P39.PAD1 (-_1)
BUS-40: HEADER_4.27, P40.PAD1 (-_1)
BUS-41: HEADER_1.7, P41.PAD1 (-_1)
BUS-42: HEADER_1.25, P42.PAD1 (-_1)
BUS-43: HEADER_2.7, P43.PAD1 (-_1)
BUS-44: HEADER_2.25, P44.PAD1 (-_1)
BUS-45: HEADER_3.7, P45.PAD1 (-_1)
BUS-46: HEADER_3.25, P46.PAD1 (-_1)
BUS-47: HEADER_4.7, P47.PAD1 (-_1)
BUS-48: HEADER_4.25, P48.PAD1 (-_1)
BUS-49: HEADER_1.5, P49.PAD1 (-_1)
BUS-50: HEADER_1.23, P50.PAD1 (-_1)
BUS-51: HEADER_2.5, P51.PAD1 (-_1)
BUS-52: HEADER_2.23, P52.PAD1 (-_1)
BUS-53: HEADER_3.5, P53.PAD1 (-_1)
BUS-54: HEADER_3.23, P54.PAD1 (-_1)
BUS-55: HEADER_4.5, P55.PAD1 (-_1)
BUS-56: HEADER_4.23, P56.PAD1 (-_1)
BUS-57: HEADER_1.3, P57.PAD1 (-_1)
BUS-58: HEADER_1.21, P58.PAD1 (-_1)
BUS-59: HEADER_2.3, P59.PAD1 (-_1)
BUS-60: HEADER_2.21, P60.PAD1 (-_1)
BUS-61: HEADER_3.3, P61.PAD1 (-_1)
BUS-62: HEADER_3.21, P62.PAD1 (-_1)
BUS-63: HEADER_4.3, P63.PAD1 (-_1)
BUS-64: HEADER_4.21, P64.PAD1 (-_1)
BUS-65: HEADER_1.1
BUS-66: HEADER_1.19
BUS-67: HEADER_2.1
BUS-68: HEADER_2.19
BUS-69: HEADER_3.1
BUS-70: HEADER_3.19, P65.PAD1 (-_1), P66.PAD1 (-_1), P67.PAD1 (-_1), P68.PAD1 (-_1), P69.PAD1 (-_1), P70.PAD1 (-_1), P71.PAD1 (-_1), P72.PAD1 (-_1)
BUS-71: HEADER_4.1
BUS-72: HEADER_4.19

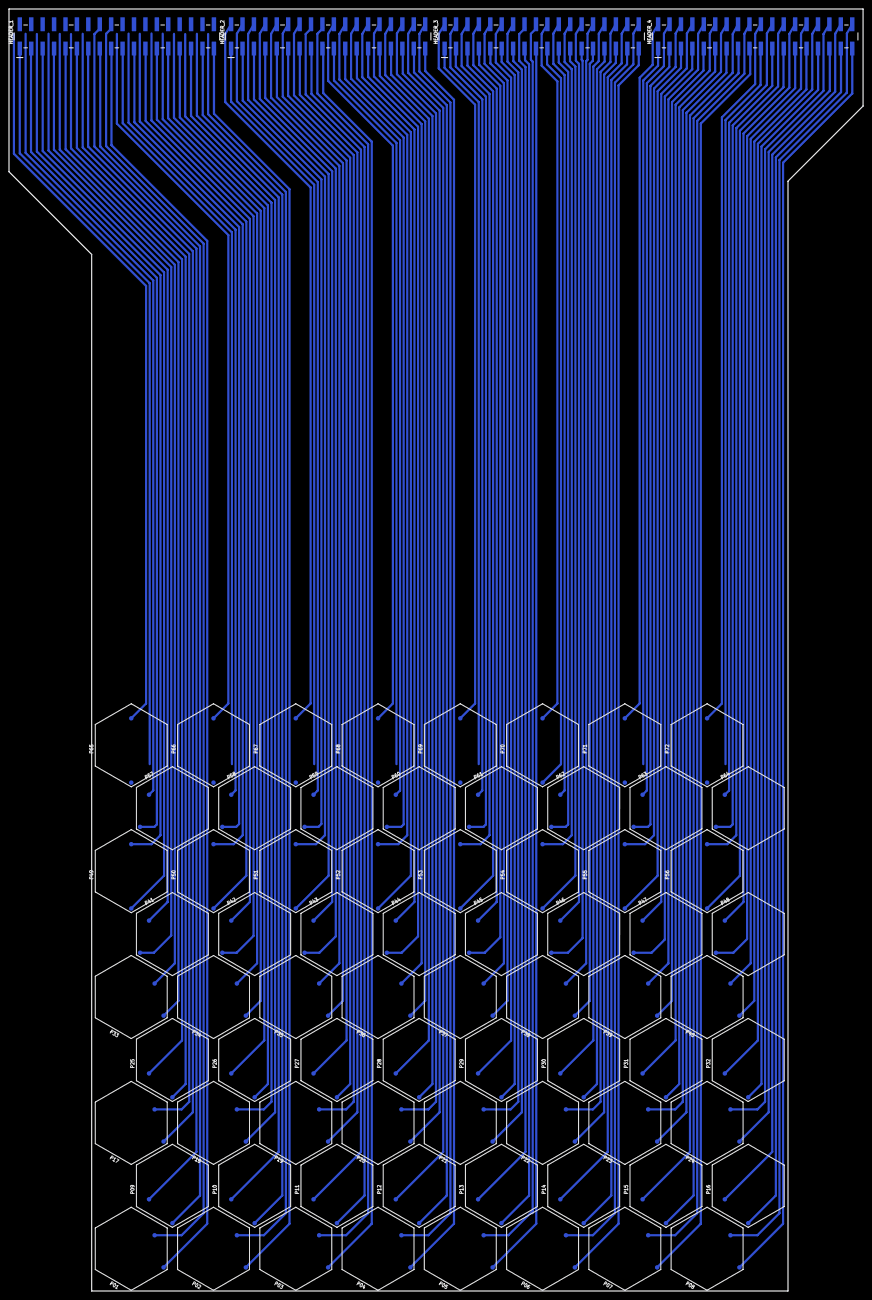
[picture p34: board piezo-layer_v0.1-R003.brd from below]

Board: 1 copper layer, 190.0 x 285.2 mm, 76 parts (76 on the bottom side), 119 nets.
