ICST-AHMI/HSoundplane_design/eagle/piezo-driver/piezo-driver_v0.95-R003.brd

## EAGLE design eagle/piezo-driver/piezo-driver_v0.95-R003.brd (2015-09-08)

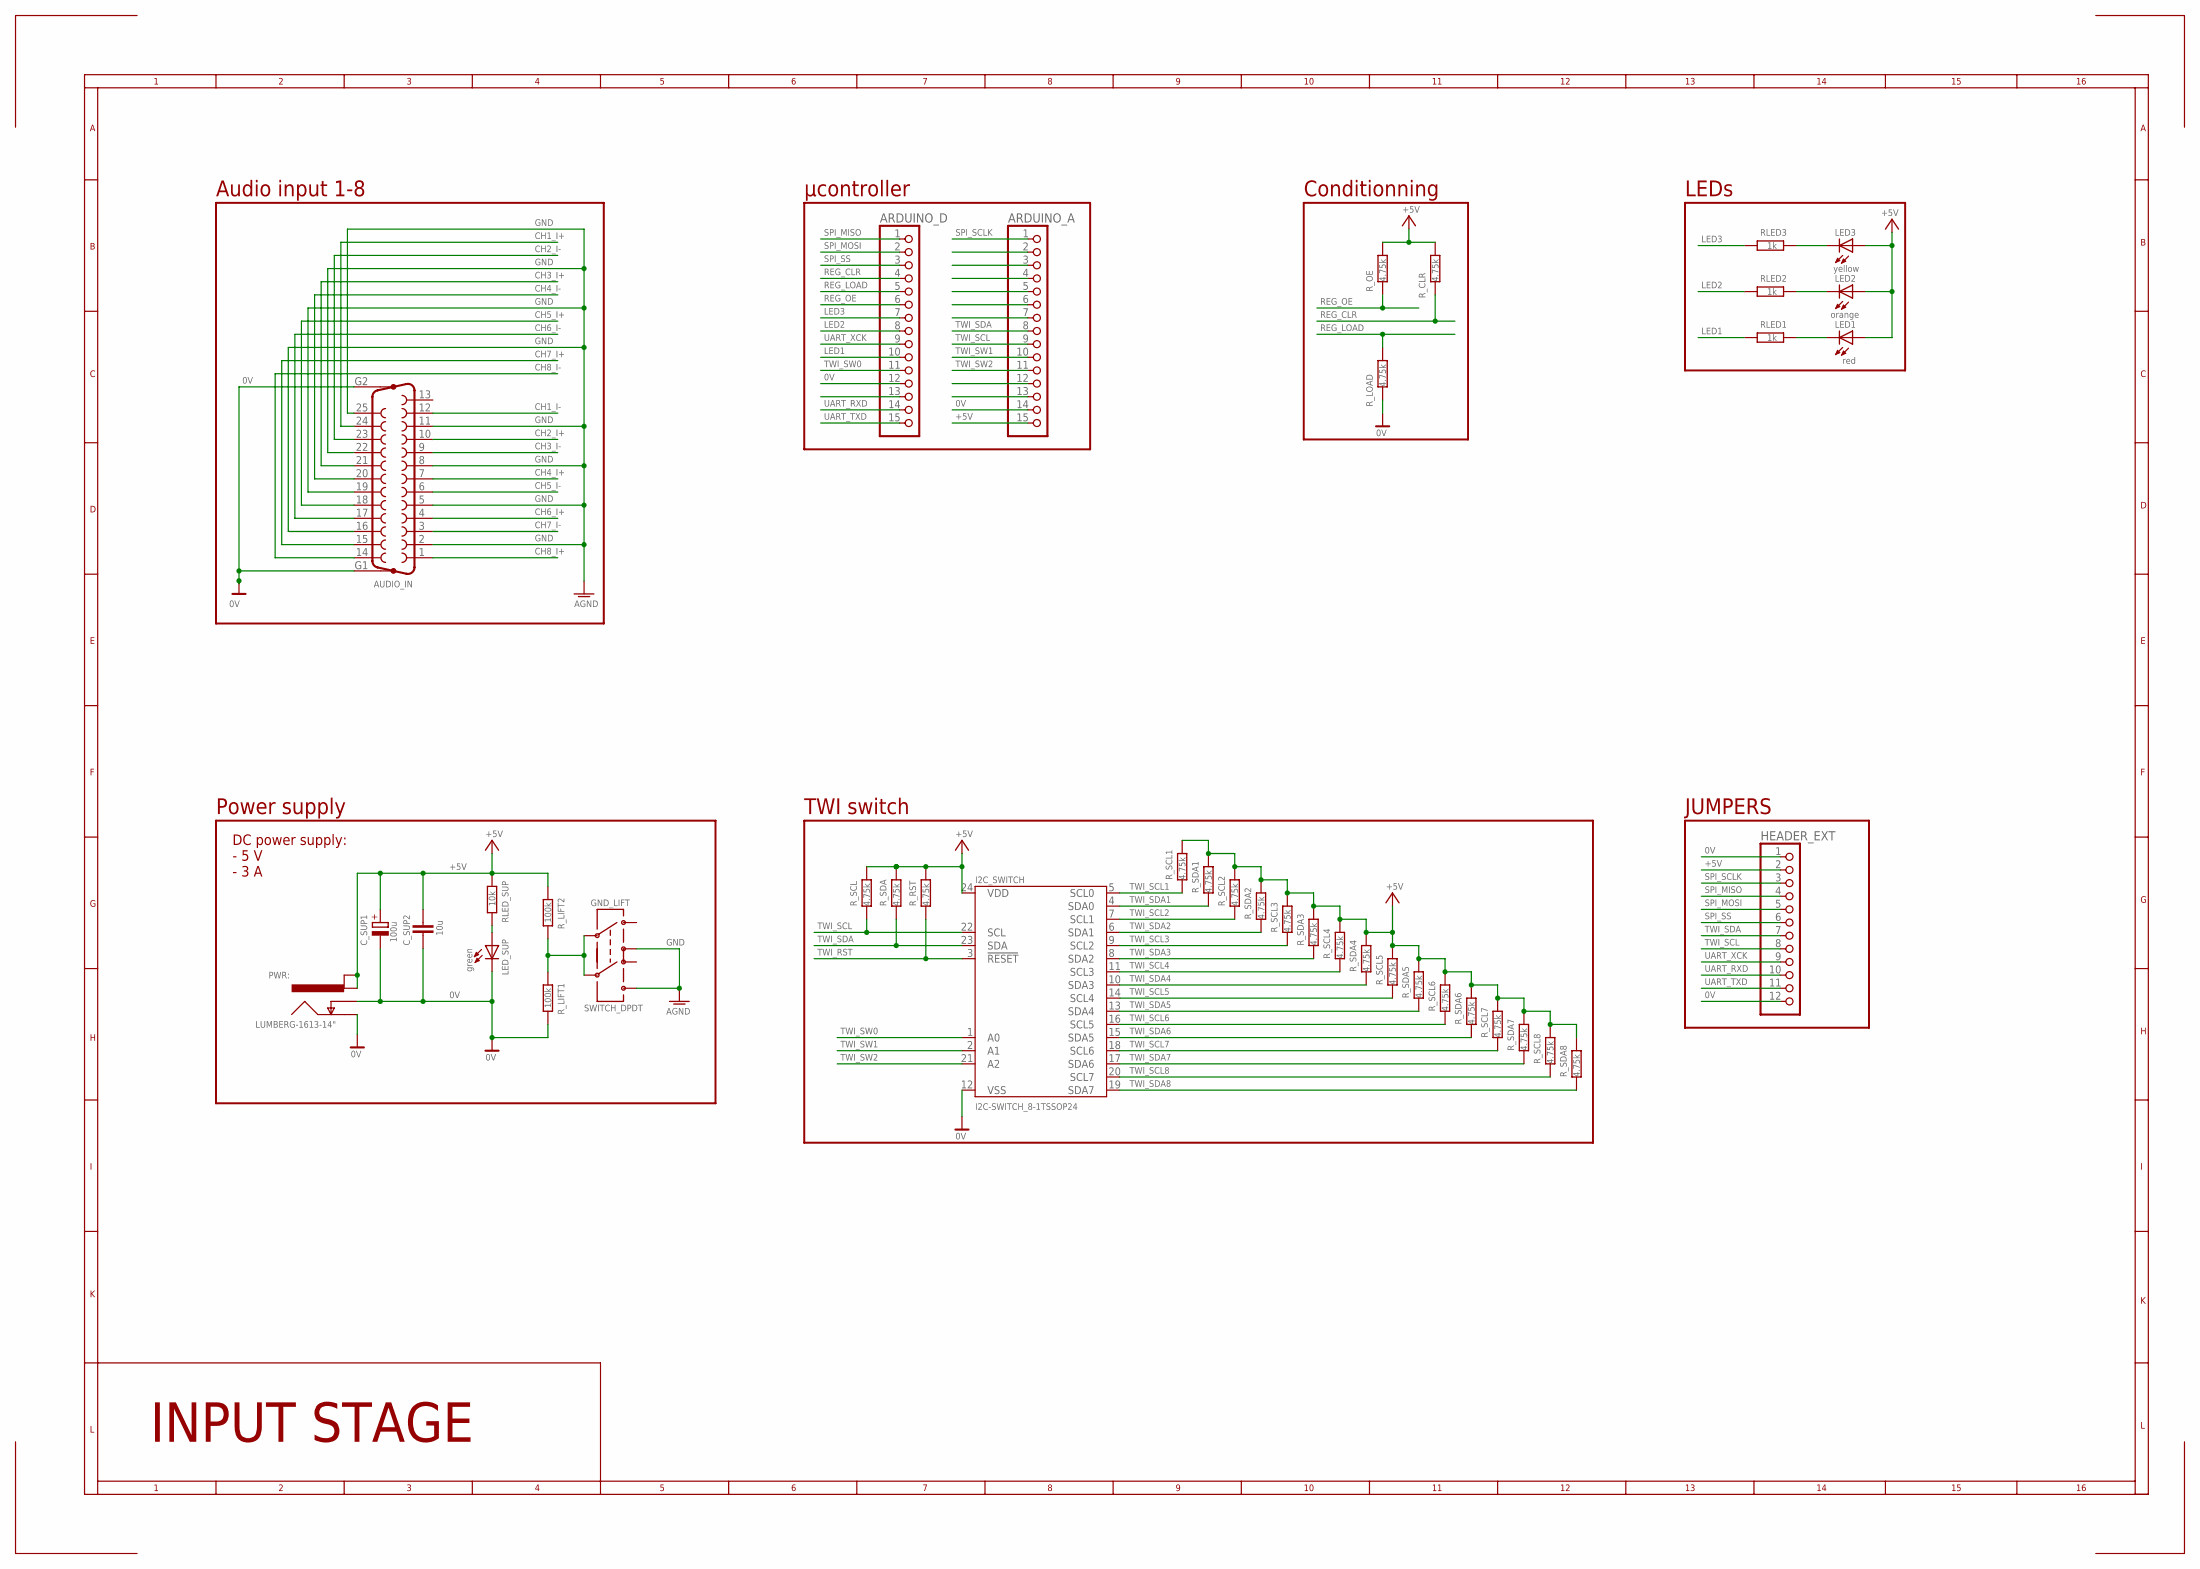
[picture p35: schematic piezo-driver_v0.95-R003.sch, sheet 1]

Parts:
ARDUINO_A: PINHD-1X15; 1X15
ARDUINO_D: PINHD-1X15; 1X15
AUDIO_IN: F25HP
C_SUP1: 100u; EIA3216
C_SUP2: 10u; C0805K
GND_LIFT: SWITCH_DPDT; SWITCH_JS202011
HEADER_EXT: PINHD-1X12; 1X12
I2C_SWITCH: I2C-SWITCH_8-1TSSOP24; TSSOP24
LED1: red; LED-1206
LED2: orange; LED-1206
LED3: yellow; LED-1206
LED_SUP: green; LED-1206
PWR:: LUMBERG-1613-14"; LUMBERG-1613_14
RLED1, RLED2, RLED3: 1k; R0402
RLED_SUP: 10k; R0402
R_CLR: 4.75k; R0402
R_LIFT1, R_LIFT2: 100k; R0402
R_LOAD: 4.75k; R0402
R_OE: 4.75k; R0402
R_RST: 4.75k; R0402
R_SCL, R_SCL1, R_SCL2, R_SCL3, R_SCL4, R_SCL5, R_SCL6, R_SCL7, R_SCL8: 4.75k; R0402
R_SDA, R_SDA1, R_SDA2, R_SDA3, R_SDA4, R_SDA5, R_SDA6, R_SDA7, R_SDA8: 4.75k; R0402

Connections:
0V: ARDUINO_A.14, ARDUINO_D.12, AUDIO_IN.G1, AUDIO_IN.G2, C_SUP1.C (-), C_SUP2.2, HEADER_EXT.1, HEADER_EXT.12, I2C_SWITCH.12 (VSS), LED_SUP.C, PWR:.1 (GND), PWR:.2 (GND_INS), R_LIFT1.1, R_LOAD.1; also elsewhere on the board
+5V: ARDUINO_A.15, C_SUP1.A (+), C_SUP2.1, HEADER_EXT.2, I2C_SWITCH.24 (VDD), LED1.A, LED2.A, LED3.A, PWR:.3 (PWR_1), PWR:.4 (PWR_2), RLED_SUP.2, R_CLR.2, R_LIFT2.2, R_OE.2, R_RST.2, R_SCL.2, R_SCL1.2, R_SCL2.2, R_SCL3.2, R_SCL4.2, R_SCL5.2, R_SCL6.2, R_SCL7.2, R_SCL8.2, R_SDA.2, R_SDA1.2, R_SDA2.2, R_SDA3.2, R_SDA4.2, R_SDA5.2, R_SDA6.2, R_SDA7.2, R_SDA8.2; also elsewhere on the board
A_3V3: ARDUINO_A.2
A_5V: ARDUINO_A.12
A_A0: ARDUINO_A.4
A_A1: ARDUINO_A.5
A_A2: ARDUINO_A.6
A_A3: ARDUINO_A.7
A_REF: ARDUINO_A.3
A_RST1: ARDUINO_D.13
A_RST2: ARDUINO_A.13
CH1_I+: AUDIO_IN.24; also elsewhere on the board
CH1_I-: AUDIO_IN.12; also elsewhere on the board
CH2_I+: AUDIO_IN.10; also elsewhere on the board
CH2_I-: AUDIO_IN.23; also elsewhere on the board
CH3_I+: AUDIO_IN.21; also elsewhere on the board
CH3_I-: AUDIO_IN.9; also elsewhere on the board
CH4_I+: AUDIO_IN.7; also elsewhere on the board
CH4_I-: AUDIO_IN.20; also elsewhere on the board
CH5_I+: AUDIO_IN.18; also elsewhere on the board
CH5_I-: AUDIO_IN.6; also elsewhere on the board
CH6_I+: AUDIO_IN.4; also elsewhere on the board
CH6_I-: AUDIO_IN.17; also elsewhere on the board
CH7_I+: AUDIO_IN.15; also elsewhere on the board
CH7_I-: AUDIO_IN.3; also elsewhere on the board
CH8_I+: AUDIO_IN.1; also elsewhere on the board
CH8_I-: AUDIO_IN.14; also elsewhere on the board
GND: AUDIO_IN.2, AUDIO_IN.5, AUDIO_IN.8, AUDIO_IN.11, AUDIO_IN.16, AUDIO_IN.19, AUDIO_IN.22, AUDIO_IN.25, GND_LIFT.1 (T1A), GND_LIFT.6 (T2A)
LED1: ARDUINO_D.10, RLED1.1
LED2: ARDUINO_D.8, RLED2.1
LED3: ARDUINO_D.7, RLED3.1
unnamed: LED_SUP.A, RLED_SUP.1
unnamed: LED3.C, RLED3.2
unnamed: LED2.C, RLED2.2
unnamed: LED1.C, RLED1.2
unnamed: GND_LIFT.2 (P1), GND_LIFT.5 (P2), R_LIFT1.2, R_LIFT2.1
REG_CLR: ARDUINO_D.4, R_CLR.1; also elsewhere on the board
REG_LOAD: ARDUINO_D.5, R_LOAD.2; also elsewhere on the board
REG_OE: ARDUINO_D.6, R_OE.1; also elsewhere on the board
SPI_MISO: ARDUINO_D.1, HEADER_EXT.4
SPI_MOSI: ARDUINO_D.2, HEADER_EXT.5; also elsewhere on the board
SPI_SCLK: ARDUINO_A.1, HEADER_EXT.3; also elsewhere on the board
SPI_SS: ARDUINO_D.3, HEADER_EXT.6
TWI_RST: I2C_SWITCH.3 (!RESET), R_RST.1
TWI_SCL: ARDUINO_A.9, HEADER_EXT.8, I2C_SWITCH.22 (SCL), R_SCL.1
TWI_SCL1: I2C_SWITCH.5 (SCL0), R_SCL1.1; also elsewhere on the board
TWI_SCL2: I2C_SWITCH.7 (SCL1), R_SCL2.1; also elsewhere on the board
TWI_SCL3: I2C_SWITCH.9 (SCL2), R_SCL3.1; also elsewhere on the board
TWI_SCL4: I2C_SWITCH.11 (SCL3), R_SCL4.1; also elsewhere on the board
TWI_SCL5: I2C_SWITCH.14 (SCL4), R_SCL5.1; also elsewhere on the board
TWI_SCL6: I2C_SWITCH.16 (SCL5), R_SCL6.1; also elsewhere on the board
TWI_SCL7: I2C_SWITCH.18 (SCL6), R_SCL7.1; also elsewhere on the board
TWI_SCL8: I2C_SWITCH.20 (SCL7), R_SCL8.1; also elsewhere on the board
TWI_SDA: ARDUINO_A.8, HEADER_EXT.7, I2C_SWITCH.23 (SDA), R_SDA.1
TWI_SDA1: I2C_SWITCH.4 (SDA0), R_SDA1.1; also elsewhere on the board
TWI_SDA2: I2C_SWITCH.6 (SDA1), R_SDA2.1; also elsewhere on the board
TWI_SDA3: I2C_SWITCH.8 (SDA2), R_SDA3.1; also elsewhere on the board
TWI_SDA4: I2C_SWITCH.10 (SDA3), R_SDA4.1; also elsewhere on the board
TWI_SDA5: I2C_SWITCH.13 (SDA4), R_SDA5.1; also elsewhere on the board
TWI_SDA6: I2C_SWITCH.15 (SDA5), R_SDA6.1; also elsewhere on the board
TWI_SDA7: I2C_SWITCH.17 (SDA6), R_SDA7.1; also elsewhere on the board
TWI_SDA8: I2C_SWITCH.19 (SDA7), R_SDA8.1; also elsewhere on the board
TWI_SW0: ARDUINO_D.11, I2C_SWITCH.1 (A0)
TWI_SW1: ARDUINO_A.10, I2C_SWITCH.2 (A1)
TWI_SW2: ARDUINO_A.11, I2C_SWITCH.21 (A2)
UART_RXD: ARDUINO_D.14, HEADER_EXT.10
UART_TXD: ARDUINO_D.15, HEADER_EXT.11
UART_XCK: ARDUINO_D.9, HEADER_EXT.9

Notes on the sheet:
Audio input 1-8
Power supply
DC power supply: - 5 V - 3 A
INPUT STAGE
µcontroller
LEDs
JUMPERS
TWI switch
Conditionning
