ICST-AHMI/HSoundplane_design/eagle/piezo-driver/piezo-driver_v0.95-R003.brd

## EAGLE design eagle/piezo-driver/piezo-driver_v0.95-R003.brd (continued)

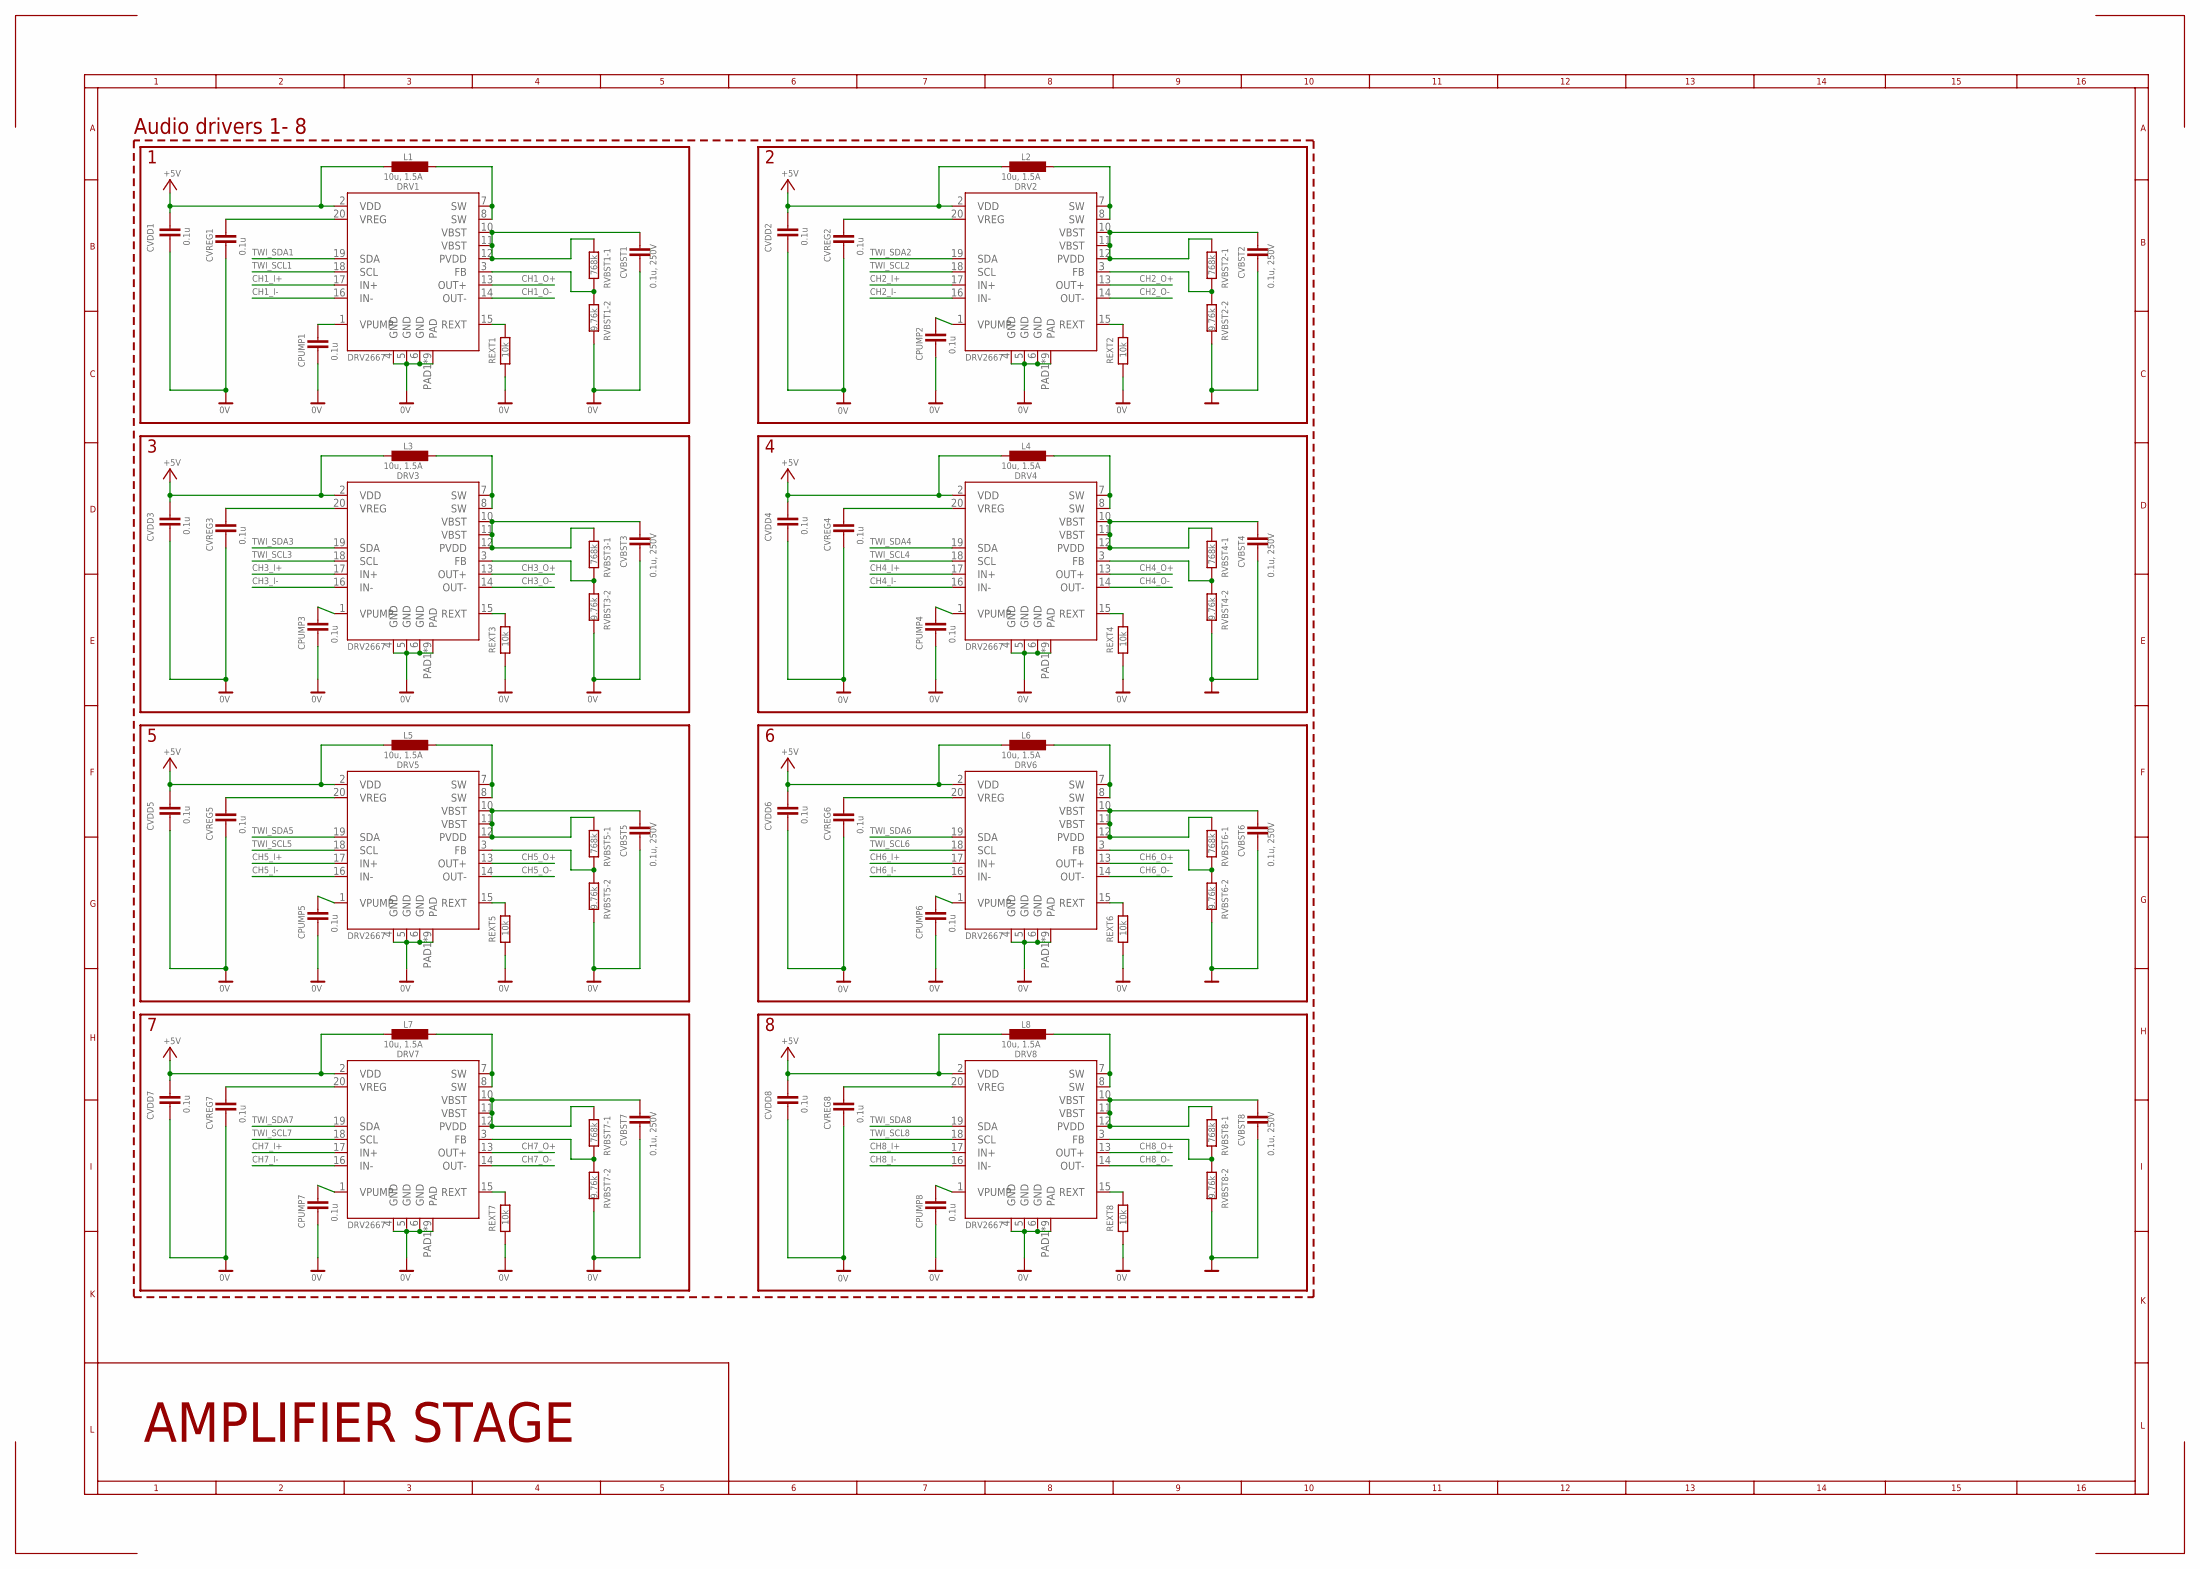
[picture p36: schematic piezo-driver_v0.95-R003.sch, sheet 2]

Parts:
CPUMP1, CPUMP2, CPUMP3, CPUMP4, CPUMP5, CPUMP6, CPUMP7, CPUMP8: 0.1u; C0402
CVBST1, CVBST2, CVBST3, CVBST4, CVBST5, CVBST6, CVBST7, CVBST8: 0.1u, 250V; C0805
CVDD1, CVDD2, CVDD3, CVDD4, CVDD5, CVDD6, CVDD7, CVDD8: 0.1u; C0402
CVREG1, CVREG2, CVREG3, CVREG4, CVREG5, CVREG6, CVREG7, CVREG8: 0.1u; C0402
DRV1, DRV2, DRV3, DRV4, DRV5, DRV6, DRV7, DRV8: DRV2667; QFN-20_9TH
L1, L2, L3, L4, L5, L6, L7, L8: 10u, 1.5A; L4.0X4.0
REXT1, REXT2, REXT3, REXT4, REXT5, REXT6, REXT7, REXT8: 10k; R0402
RVBST1-1, RVBST2-1, RVBST3-1, RVBST4-1, RVBST5-1, RVBST6-1, RVBST7-1, RVBST8-1: 768k; R0402
RVBST1-2, RVBST2-2, RVBST3-2, RVBST4-2, RVBST5-2, RVBST6-2, RVBST7-2, RVBST8-2: 9.76k; R0402

Connections:
0V: CPUMP1.2, CPUMP2.2, CPUMP3.2, CPUMP4.2, CPUMP5.2, CPUMP6.2, CPUMP7.2, CPUMP8.2, CVBST1.2, CVBST2.2, CVBST3.2, CVBST4.2, CVBST5.2, CVBST6.2, CVBST7.2, CVBST8.2, CVDD1.2, CVDD2.2, CVDD3.2, CVDD4.2, CVDD5.2, CVDD6.2, CVDD7.2, CVDD8.2, CVREG1.2, CVREG2.2, CVREG3.2, CVREG4.2, CVREG5.2, CVREG6.2, CVREG7.2, CVREG8.2, DRV1.4 (GND), DRV1.5 (GND), DRV1.6 (GND), DRV1.PAD1 (PAD), DRV1.PAD2 (PAD), DRV1.PAD3 (PAD), DRV1.PAD4 (PAD), DRV1.PAD5 (PAD), DRV1.PAD6 (PAD), DRV1.PAD7 (PAD), DRV1.PAD8 (PAD), DRV1.PAD9 (PAD), DRV2.4 (GND), DRV2.5 (GND), DRV2.6 (GND), DRV2.PAD1 (PAD), DRV2.PAD2 (PAD), DRV2.PAD3 (PAD), DRV2.PAD4 (PAD), DRV2.PAD5 (PAD), DRV2.PAD6 (PAD), DRV2.PAD7 (PAD), DRV2.PAD8 (PAD), DRV2.PAD9 (PAD), DRV3.4 (GND), DRV3.5 (GND), DRV3.6 (GND), DRV3.PAD1 (PAD), DRV3.PAD2 (PAD), DRV3.PAD3 (PAD), DRV3.PAD4 (PAD), DRV3.PAD5 (PAD), DRV3.PAD6 (PAD), DRV3.PAD7 (PAD), DRV3.PAD8 (PAD), DRV3.PAD9 (PAD), DRV4.4 (GND), DRV4.5 (GND), DRV4.6 (GND), DRV4.PAD1 (PAD), DRV4.PAD2 (PAD), DRV4.PAD3 (PAD), DRV4.PAD4 (PAD), DRV4.PAD5 (PAD), DRV4.PAD6 (PAD), DRV4.PAD7 (PAD), DRV4.PAD8 (PAD), DRV4.PAD9 (PAD), DRV5.4 (GND), DRV5.5 (GND), DRV5.6 (GND), DRV5.PAD1 (PAD), DRV5.PAD2 (PAD), DRV5.PAD3 (PAD), DRV5.PAD4 (PAD), DRV5.PAD5 (PAD), DRV5.PAD6 (PAD), DRV5.PAD7 (PAD), DRV5.PAD8 (PAD), DRV5.PAD9 (PAD), DRV6.4 (GND), DRV6.5 (GND), DRV6.6 (GND), DRV6.PAD1 (PAD), DRV6.PAD2 (PAD), DRV6.PAD3 (PAD), DRV6.PAD4 (PAD), DRV6.PAD5 (PAD), DRV6.PAD6 (PAD), DRV6.PAD7 (PAD), DRV6.PAD8 (PAD), DRV6.PAD9 (PAD), DRV7.4 (GND), DRV7.5 (GND), DRV7.6 (GND), DRV7.PAD1 (PAD), DRV7.PAD2 (PAD), DRV7.PAD3 (PAD), DRV7.PAD4 (PAD), DRV7.PAD5 (PAD), DRV7.PAD6 (PAD), DRV7.PAD7 (PAD), DRV7.PAD8 (PAD), DRV7.PAD9 (PAD), DRV8.4 (GND), DRV8.5 (GND), DRV8.6 (GND), DRV8.PAD1 (PAD), DRV8.PAD2 (PAD), DRV8.PAD3 (PAD), DRV8.PAD4 (PAD), DRV8.PAD5 (PAD), DRV8.PAD6 (PAD), DRV8.PAD7 (PAD), DRV8.PAD8 (PAD), DRV8.PAD9 (PAD), REXT1.1, REXT2.1, REXT3.1, REXT4.1, REXT5.1, REXT6.1, REXT7.1, REXT8.1, RVBST1-2.1, RVBST2-2.1, RVBST3-2.1, RVBST4-2.1, RVBST5-2.1, RVBST6-2.1, RVBST7-2.1, RVBST8-2.1; also elsewhere on the board
+5V: CVDD1.1, CVDD2.1, CVDD3.1, CVDD4.1, CVDD5.1, CVDD6.1, CVDD7.1, CVDD8.1, DRV1.2 (VDD), DRV2.2 (VDD), DRV3.2 (VDD), DRV4.2 (VDD), DRV5.2 (VDD), DRV6.2 (VDD), DRV7.2 (VDD), DRV8.2 (VDD), L1.2, L2.2, L3.2, L4.2, L5.2, L6.2, L7.2, L8.2; also elsewhere on the board
CH1_I+: DRV1.17 (IN+); also elsewhere on the board
CH1_I-: DRV1.16 (IN-); also elsewhere on the board
CH1_O+: DRV1.13 (OUT+); also elsewhere on the board
CH1_O-: DRV1.14 (OUT-); also elsewhere on the board
CH2_I+: DRV2.17 (IN+); also elsewhere on the board
CH2_I-: DRV2.16 (IN-); also elsewhere on the board
CH2_O+: DRV2.13 (OUT+); also elsewhere on the board
CH2_O-: DRV2.14 (OUT-); also elsewhere on the board
CH3_I+: DRV3.17 (IN+); also elsewhere on the board
CH3_I-: DRV3.16 (IN-); also elsewhere on the board
CH3_O+: DRV3.13 (OUT+); also elsewhere on the board
CH3_O-: DRV3.14 (OUT-); also elsewhere on the board
CH4_I+: DRV4.17 (IN+); also elsewhere on the board
CH4_I-: DRV4.16 (IN-); also elsewhere on the board
CH4_O+: DRV4.13 (OUT+); also elsewhere on the board
CH4_O-: DRV4.14 (OUT-); also elsewhere on the board
CH5_I+: DRV5.17 (IN+); also elsewhere on the board
CH5_I-: DRV5.16 (IN-); also elsewhere on the board
CH5_O+: DRV5.13 (OUT+); also elsewhere on the board
CH5_O-: DRV5.14 (OUT-); also elsewhere on the board
CH6_I+: DRV6.17 (IN+); also elsewhere on the board
CH6_I-: DRV6.16 (IN-); also elsewhere on the board
CH6_O+: DRV6.13 (OUT+); also elsewhere on the board
CH6_O-: DRV6.14 (OUT-); also elsewhere on the board
CH7_I+: DRV7.17 (IN+); also elsewhere on the board
CH7_I-: DRV7.16 (IN-); also elsewhere on the board
CH7_O+: DRV7.13 (OUT+); also elsewhere on the board
CH7_O-: DRV7.14 (OUT-); also elsewhere on the board
CH8_I+: DRV8.17 (IN+); also elsewhere on the board
CH8_I-: DRV8.16 (IN-); also elsewhere on the board
CH8_O+: DRV8.13 (OUT+); also elsewhere on the board
CH8_O-: DRV8.14 (OUT-); also elsewhere on the board
CVBST1: CVBST1.1, DRV1.10 (VBST), DRV1.11 (VBST), DRV1.12 (PVDD), RVBST1-1.2
CVBST2: CVBST2.1, DRV2.10 (VBST), DRV2.11 (VBST), DRV2.12 (PVDD), RVBST2-1.2
CVBST3: CVBST3.1, DRV3.10 (VBST), DRV3.11 (VBST), DRV3.12 (PVDD), RVBST3-1.2
CVBST4: CVBST4.1, DRV4.10 (VBST), DRV4.11 (VBST), DRV4.12 (PVDD), RVBST4-1.2
CVBST5: CVBST5.1, DRV5.10 (VBST), DRV5.11 (VBST), DRV5.12 (PVDD), RVBST5-1.2
CVBST6: CVBST6.1, DRV6.10 (VBST), DRV6.11 (VBST), DRV6.12 (PVDD), RVBST6-1.2
CVBST7: CVBST7.1, DRV7.10 (VBST), DRV7.11 (VBST), DRV7.12 (PVDD), RVBST7-1.2
CVBST8: CVBST8.1, DRV8.10 (VBST), DRV8.11 (VBST), DRV8.12 (PVDD), RVBST8-1.2
L1: DRV1.7 (SW), DRV1.8 (SW), L1.1
L2: DRV2.7 (SW), DRV2.8 (SW), L2.1
L3: DRV3.7 (SW), DRV3.8 (SW), L3.1
L4: DRV4.7 (SW), DRV4.8 (SW), L4.1
L5: DRV5.7 (SW), DRV5.8 (SW), L5.1
L6: DRV6.7 (SW), DRV6.8 (SW), L6.1
L7: DRV7.7 (SW), DRV7.8 (SW), L7.1
L8: DRV8.7 (SW), DRV8.8 (SW), L8.1
unnamed: DRV1.3 (FB), RVBST1-1.1, RVBST1-2.2
unnamed: DRV1.15 (REXT), REXT1.2
unnamed: CPUMP1.1, DRV1.1 (VPUMP)
unnamed: CVREG1.1, DRV1.20 (VREG)
unnamed: DRV3.3 (FB), RVBST3-1.1, RVBST3-2.2
unnamed: DRV3.15 (REXT), REXT3.2
unnamed: CPUMP3.1, DRV3.1 (VPUMP)
unnamed: CVREG3.1, DRV3.20 (VREG)
unnamed: DRV4.3 (FB), RVBST4-1.1, RVBST4-2.2
unnamed: DRV4.15 (REXT), REXT4.2
unnamed: CPUMP4.1, DRV4.1 (VPUMP)
unnamed: CVREG4.1, DRV4.20 (VREG)
unnamed: DRV2.3 (FB), RVBST2-1.1, RVBST2-2.2
unnamed: DRV2.15 (REXT), REXT2.2
unnamed: CPUMP2.1, DRV2.1 (VPUMP)
unnamed: CVREG2.1, DRV2.20 (VREG)
unnamed: DRV5.3 (FB), RVBST5-1.1, RVBST5-2.2
unnamed: DRV5.15 (REXT), REXT5.2
unnamed: CPUMP5.1, DRV5.1 (VPUMP)
unnamed: CVREG5.1, DRV5.20 (VREG)
unnamed: DRV6.3 (FB), RVBST6-1.1, RVBST6-2.2
unnamed: DRV6.15 (REXT), REXT6.2
unnamed: CPUMP6.1, DRV6.1 (VPUMP)
unnamed: CVREG6.1, DRV6.20 (VREG)
unnamed: DRV7.3 (FB), RVBST7-1.1, RVBST7-2.2
unnamed: DRV7.15 (REXT), REXT7.2
unnamed: CPUMP7.1, DRV7.1 (VPUMP)
unnamed: CVREG7.1, DRV7.20 (VREG)
unnamed: DRV8.3 (FB), RVBST8-1.1, RVBST8-2.2
unnamed: DRV8.15 (REXT), REXT8.2
unnamed: CPUMP8.1, DRV8.1 (VPUMP)
unnamed: CVREG8.1, DRV8.20 (VREG)
TWI_SCL1: DRV1.18 (SCL); also elsewhere on the board
TWI_SCL2: DRV2.18 (SCL); also elsewhere on the board
TWI_SCL3: DRV3.18 (SCL); also elsewhere on the board
TWI_SCL4: DRV4.18 (SCL); also elsewhere on the board
TWI_SCL5: DRV5.18 (SCL); also elsewhere on the board
TWI_SCL6: DRV6.18 (SCL); also elsewhere on the board
TWI_SCL7: DRV7.18 (SCL); also elsewhere on the board
TWI_SCL8: DRV8.18 (SCL); also elsewhere on the board
TWI_SDA1: DRV1.19 (SDA); also elsewhere on the board
TWI_SDA2: DRV2.19 (SDA); also elsewhere on the board
TWI_SDA3: DRV3.19 (SDA); also elsewhere on the board
TWI_SDA4: DRV4.19 (SDA); also elsewhere on the board
TWI_SDA5: DRV5.19 (SDA); also elsewhere on the board
TWI_SDA6: DRV6.19 (SDA); also elsewhere on the board
TWI_SDA7: DRV7.19 (SDA); also elsewhere on the board
TWI_SDA8: DRV8.19 (SDA); also elsewhere on the board

Notes on the sheet:
AMPLIFIER STAGE
Audio drivers 1- 8

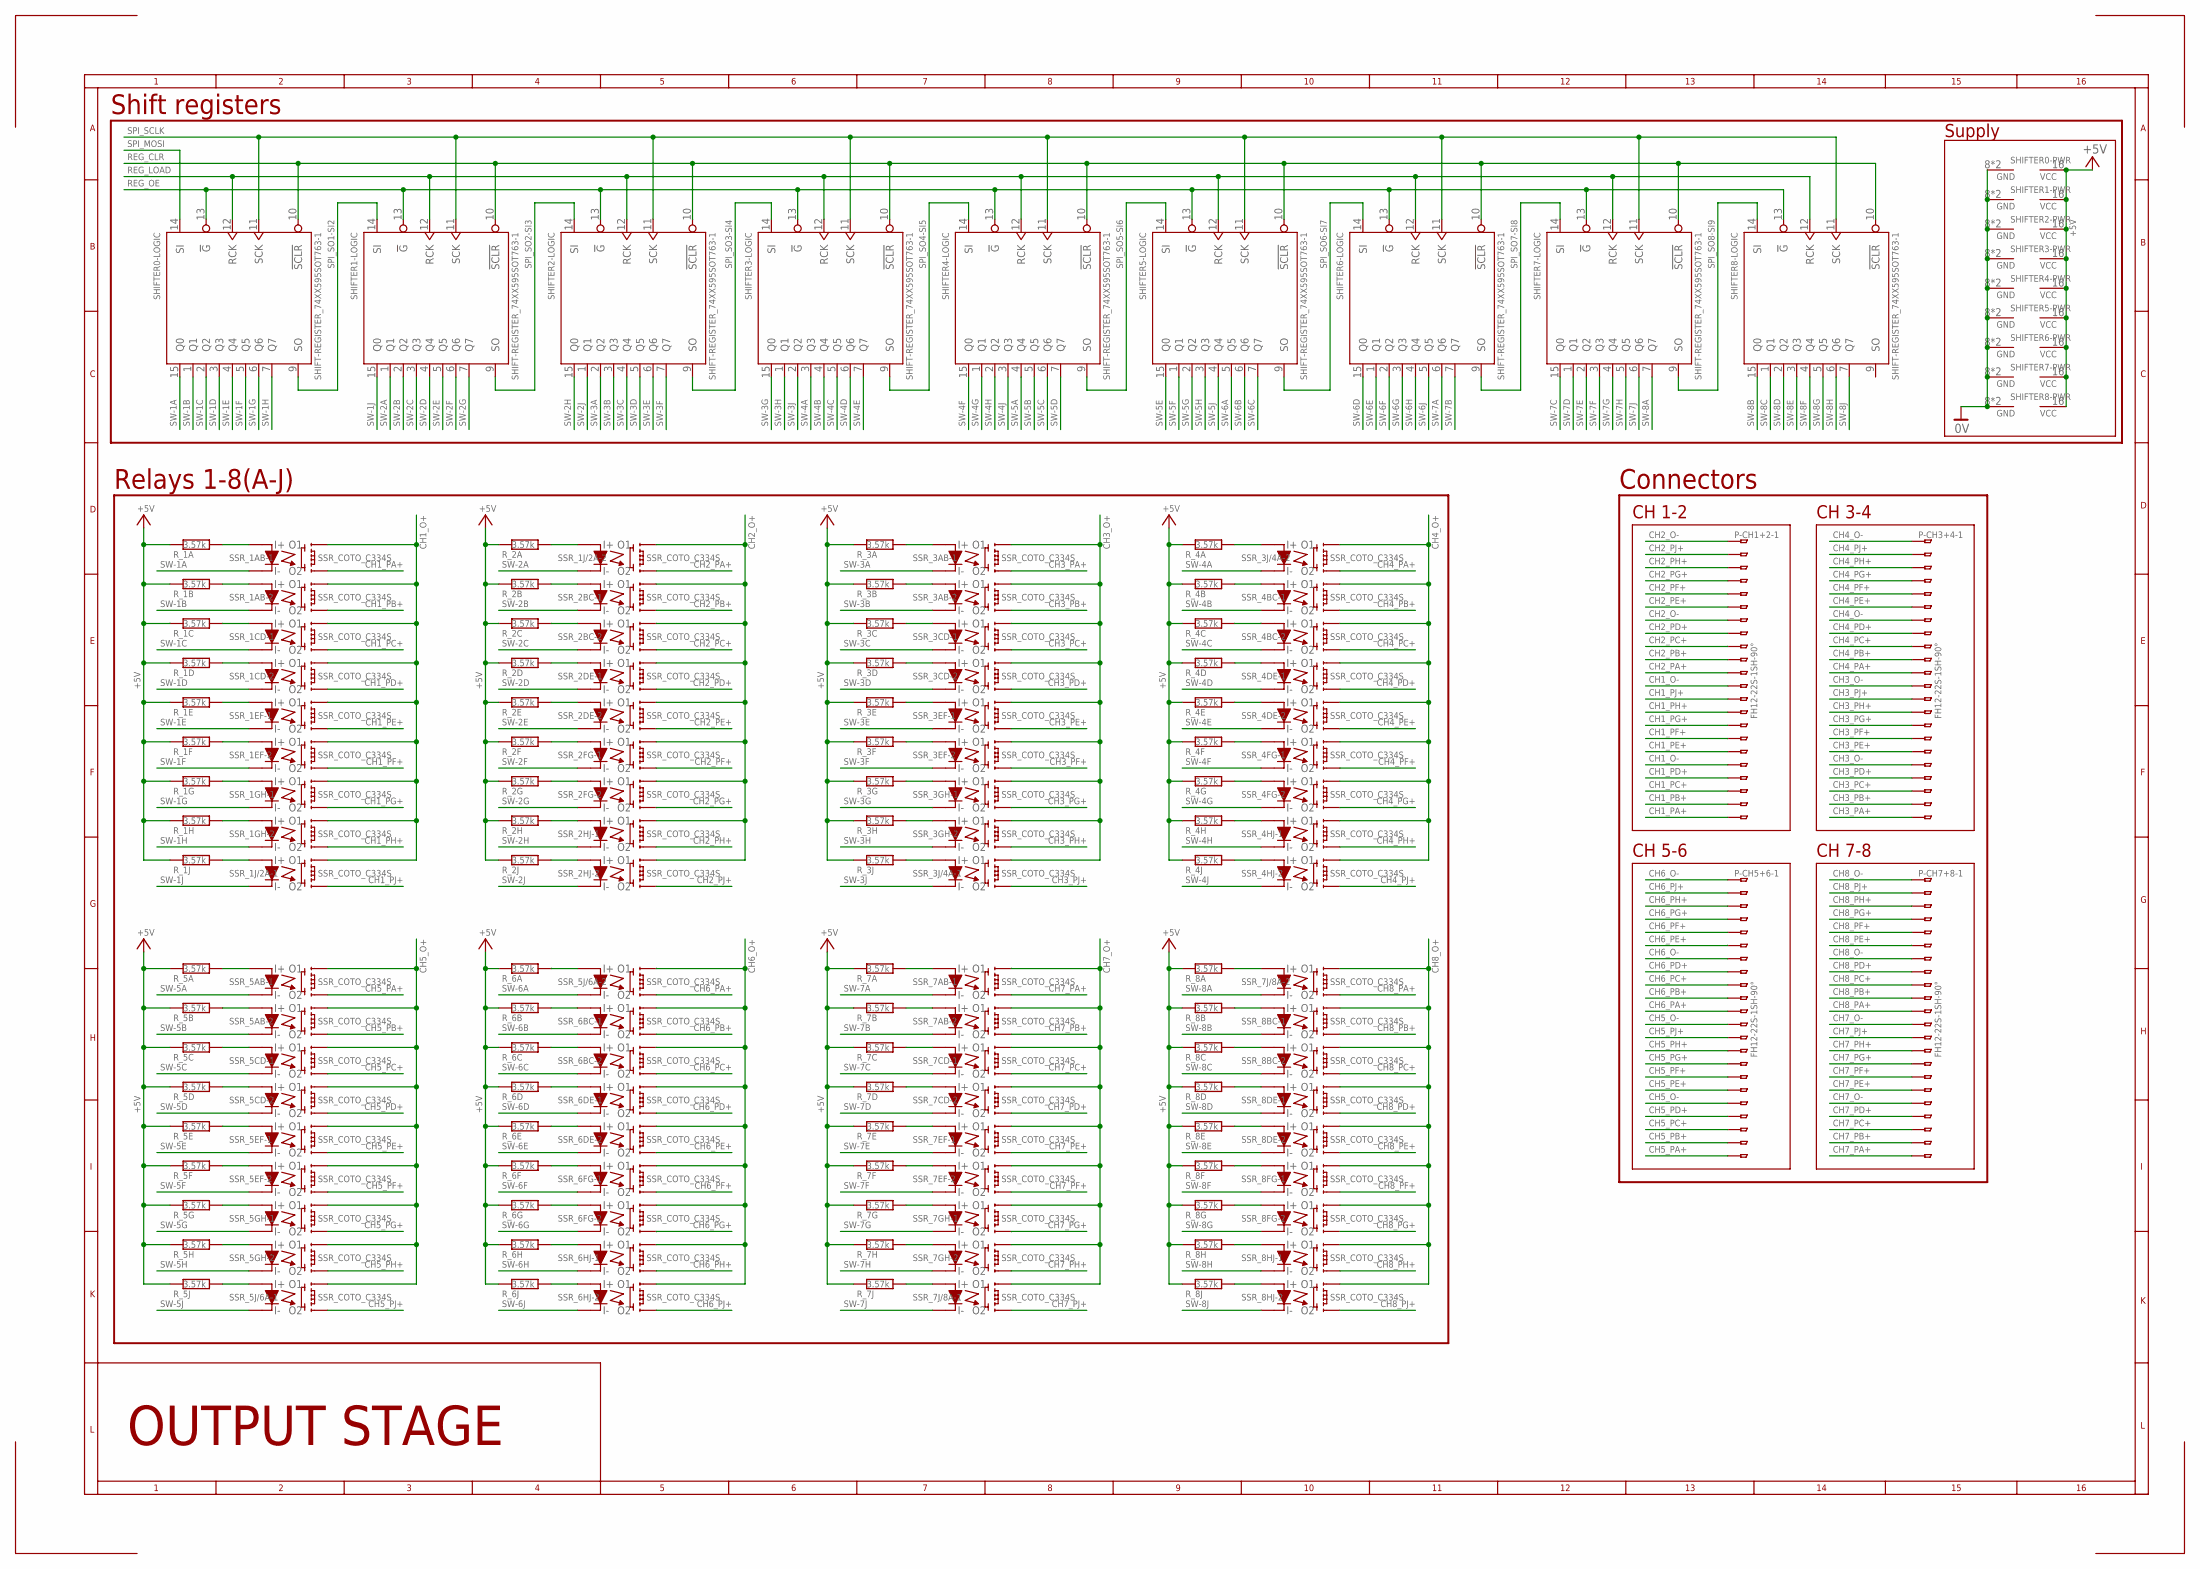
[picture p37: schematic piezo-driver_v0.95-R003.sch, sheet 3]

Parts:
P-CH1+2, P-CH3+4, P-CH5+6, P-CH7+8: FH12-22S-1SH-90°; FH12-22S-1SH
R_1A, R_1B, R_1C, R_1D, R_1E, R_1F, R_1G, R_1H, R_1J, R_2A, R_2B, R_2C, R_2D, R_2E, R_2F, R_2G, R_2H, R_2J, R_3A, R_3B, R_3C, R_3D, R_3E, R_3F, R_3G, R_3H, R_3J, R_4A, R_4B, R_4C, R_4D, R_4E, R_4F, R_4G, R_4H, R_4J, R_5A, R_5B, R_5C, R_5D, R_5E, R_5F, R_5G, R_5H, R_5J, R_6A, R_6B, R_6C, R_6D, R_6E, R_6F, R_6G, R_6H, R_6J, R_7A, R_7B, R_7C, R_7D, R_7E, R_7F, R_7G, R_7H, R_7J, R_8A, R_8B, R_8C, R_8D, R_8E, R_8F, R_8G, R_8H, R_8J: 3.57k; R0402
SHIFTER0, SHIFTER1, SHIFTER2, SHIFTER3, SHIFTER4, SHIFTER5, SHIFTER6, SHIFTER7, SHIFTER8: SHIFT-REGISTER_74XX595SOT763-1; SOT763-1
SSR_1AB, SSR_1CD, SSR_1EF, SSR_1GH, SSR_1J/2A, SSR_2BC, SSR_2DE, SSR_2FG, SSR_2HJ, SSR_3AB, SSR_3CD, SSR_3EF, SSR_3GH, SSR_3J/4A, SSR_4BC, SSR_4DE, SSR_4FG, SSR_4HJ, SSR_5AB, SSR_5CD, SSR_5EF, SSR_5GH, SSR_5J/6A, SSR_6BC, SSR_6DE, SSR_6FG, SSR_6HJ, SSR_7AB, SSR_7CD, SSR_7EF, SSR_7GH, SSR_7J/8A, SSR_8BC, SSR_8DE, SSR_8FG, SSR_8HJ: SSR_COTO_C334S; SOP8

Connections:
0V: SHIFTER0.8 (GND), SHIFTER0.PAD (GND), SHIFTER1.8 (GND), SHIFTER1.PAD (GND), SHIFTER2.8 (GND), SHIFTER2.PAD (GND), SHIFTER3.8 (GND), SHIFTER3.PAD (GND), SHIFTER4.8 (GND), SHIFTER4.PAD (GND), SHIFTER5.8 (GND), SHIFTER5.PAD (GND), SHIFTER6.8 (GND), SHIFTER6.PAD (GND), SHIFTER7.8 (GND), SHIFTER7.PAD (GND), SHIFTER8.8 (GND), SHIFTER8.PAD (GND); also elsewhere on the board
+5V: R_1A.2, R_1B.2, R_1C.2, R_1D.2, R_1E.2, R_1F.2, R_1G.2, R_1H.2, R_1J.2, R_2A.2, R_2B.2, R_2C.2, R_2D.2, R_2E.2, R_2F.2, R_2G.2, R_2H.2, R_2J.2, R_3A.2, R_3B.2, R_3C.2, R_3D.2, R_3E.2, R_3F.2, R_3G.2, R_3H.2, R_3J.2, R_4A.2, R_4B.2, R_4C.2, R_4D.2, R_4E.2, R_4F.2, R_4G.2, R_4H.2, R_4J.2, R_5A.2, R_5B.2, R_5C.2, R_5D.2, R_5E.2, R_5F.2, R_5G.2, R_5H.2, R_5J.2, R_6A.2, R_6B.2, R_6C.2, R_6D.2, R_6E.2, R_6F.2, R_6G.2, R_6H.2, R_6J.2, R_7A.2, R_7B.2, R_7C.2, R_7D.2, R_7E.2, R_7F.2, R_7G.2, R_7H.2, R_7J.2, R_8A.2, R_8B.2, R_8C.2, R_8D.2, R_8E.2, R_8F.2, R_8G.2, R_8H.2, R_8J.2, SHIFTER0.16 (VCC), SHIFTER1.16 (VCC), SHIFTER2.16 (VCC), SHIFTER3.16 (VCC), SHIFTER4.16 (VCC), SHIFTER5.16 (VCC), SHIFTER6.16 (VCC), SHIFTER7.16 (VCC), SHIFTER8.16 (VCC); also elsewhere on the board
CH1_O+: SSR_1AB.5 (O1), SSR_1AB.7 (O1), SSR_1CD.5 (O1), SSR_1CD.7 (O1), SSR_1EF.5 (O1), SSR_1EF.7 (O1), SSR_1GH.5 (O1), SSR_1GH.7 (O1), SSR_1J/2A.7 (O1); also elsewhere on the board
CH1_O-: P-CH1+2.12, P-CH1+2.18; also elsewhere on the board
CH1_PA+: P-CH1+2.22, SSR_1AB.8 (O2)
CH1_PB+: P-CH1+2.21, SSR_1AB.6 (O2)
CH1_PC+: P-CH1+2.20, SSR_1CD.8 (O2)
CH1_PD+: P-CH1+2.19, SSR_1CD.6 (O2)
CH1_PE+: P-CH1+2.17, SSR_1EF.8 (O2)
CH1_PF+: P-CH1+2.16, SSR_1EF.6 (O2)
CH1_PG+: P-CH1+2.15, SSR_1GH.8 (O2)
CH1_PH+: P-CH1+2.14, SSR_1GH.6 (O2)
CH1_PJ+: P-CH1+2.13, SSR_1J/2A.8 (O2)
CH2_O+: SSR_1J/2A.5 (O1), SSR_2BC.5 (O1), SSR_2BC.7 (O1), SSR_2DE.5 (O1), SSR_2DE.7 (O1), SSR_2FG.5 (O1), SSR_2FG.7 (O1), SSR_2HJ.5 (O1), SSR_2HJ.7 (O1); also elsewhere on the board
CH2_O-: P-CH1+2.1, P-CH1+2.7; also elsewhere on the board
CH2_PA+: P-CH1+2.11, SSR_1J/2A.6 (O2)
CH2_PB+: P-CH1+2.10, SSR_2BC.8 (O2)
CH2_PC+: P-CH1+2.9, SSR_2BC.6 (O2)
CH2_PD+: P-CH1+2.8, SSR_2DE.8 (O2)
CH2_PE+: P-CH1+2.6, SSR_2DE.6 (O2)
CH2_PF+: P-CH1+2.5, SSR_2FG.8 (O2)
CH2_PG+: P-CH1+2.4, SSR_2FG.6 (O2)
CH2_PH+: P-CH1+2.3, SSR_2HJ.8 (O2)
CH2_PJ+: P-CH1+2.2, SSR_2HJ.6 (O2)
CH3_O+: SSR_3AB.5 (O1), SSR_3AB.7 (O1), SSR_3CD.5 (O1), SSR_3CD.7 (O1), SSR_3EF.5 (O1), SSR_3EF.7 (O1), SSR_3GH.5 (O1), SSR_3GH.7 (O1), SSR_3J/4A.7 (O1); also elsewhere on the board
CH3_O-: P-CH3+4.12, P-CH3+4.18; also elsewhere on the board
CH3_PA+: P-CH3+4.22, SSR_3AB.8 (O2)
CH3_PB+: P-CH3+4.21, SSR_3AB.6 (O2)
CH3_PC+: P-CH3+4.20, SSR_3CD.8 (O2)
CH3_PD+: P-CH3+4.19, SSR_3CD.6 (O2)
CH3_PE+: P-CH3+4.17, SSR_3EF.8 (O2)
CH3_PF+: P-CH3+4.16, SSR_3EF.6 (O2)
CH3_PG+: P-CH3+4.15, SSR_3GH.8 (O2)
CH3_PH+: P-CH3+4.14, SSR_3GH.6 (O2)
CH3_PJ+: P-CH3+4.13, SSR_3J/4A.8 (O2)
CH4_O+: SSR_3J/4A.5 (O1), SSR_4BC.5 (O1), SSR_4BC.7 (O1), SSR_4DE.5 (O1), SSR_4DE.7 (O1), SSR_4FG.5 (O1), SSR_4FG.7 (O1), SSR_4HJ.5 (O1), SSR_4HJ.7 (O1); also elsewhere on the board
CH4_O-: P-CH3+4.1, P-CH3+4.7; also elsewhere on the board
CH4_PA+: P-CH3+4.11, SSR_3J/4A.6 (O2)
CH4_PB+: P-CH3+4.10, SSR_4BC.8 (O2)
CH4_PC+: P-CH3+4.9, SSR_4BC.6 (O2)
CH4_PD+: P-CH3+4.8, SSR_4DE.8 (O2)
CH4_PE+: P-CH3+4.6, SSR_4DE.6 (O2)
CH4_PF+: P-CH3+4.5, SSR_4FG.8 (O2)
CH4_PG+: P-CH3+4.4, SSR_4FG.6 (O2)
CH4_PH+: P-CH3+4.3, SSR_4HJ.8 (O2)
CH4_PJ+: P-CH3+4.2, SSR_4HJ.6 (O2)
CH5_O+: SSR_5AB.5 (O1), SSR_5AB.7 (O1), SSR_5CD.5 (O1), SSR_5CD.7 (O1), SSR_5EF.5 (O1), SSR_5EF.7 (O1), SSR_5GH.5 (O1), SSR_5GH.7 (O1), SSR_5J/6A.7 (O1); also elsewhere on the board
CH5_O-: P-CH5+6.12, P-CH5+6.18; also elsewhere on the board
CH5_PA+: P-CH5+6.22, SSR_5AB.8 (O2)
CH5_PB+: P-CH5+6.21, SSR_5AB.6 (O2)
CH5_PC+: P-CH5+6.20, SSR_5CD.8 (O2)
CH5_PD+: P-CH5+6.19, SSR_5CD.6 (O2)
CH5_PE+: P-CH5+6.17, SSR_5EF.8 (O2)
CH5_PF+: P-CH5+6.16, SSR_5EF.6 (O2)
CH5_PG+: P-CH5+6.15, SSR_5GH.8 (O2)
CH5_PH+: P-CH5+6.14, SSR_5GH.6 (O2)
CH5_PJ+: P-CH5+6.13, SSR_5J/6A.8 (O2)
CH6_O+: SSR_5J/6A.5 (O1), SSR_6BC.5 (O1), SSR_6BC.7 (O1), SSR_6DE.5 (O1), SSR_6DE.7 (O1), SSR_6FG.5 (O1), SSR_6FG.7 (O1), SSR_6HJ.5 (O1), SSR_6HJ.7 (O1); also elsewhere on the board
CH6_O-: P-CH5+6.1, P-CH5+6.7; also elsewhere on the board
CH6_PA+: P-CH5+6.11, SSR_5J/6A.6 (O2)
CH6_PB+: P-CH5+6.10, SSR_6BC.8 (O2)
CH6_PC+: P-CH5+6.9, SSR_6BC.6 (O2)
CH6_PD+: P-CH5+6.8, SSR_6DE.8 (O2)
CH6_PE+: P-CH5+6.6, SSR_6DE.6 (O2)
CH6_PF+: P-CH5+6.5, SSR_6FG.8 (O2)
CH6_PG+: P-CH5+6.4, SSR_6FG.6 (O2)
CH6_PH+: P-CH5+6.3, SSR_6HJ.8 (O2)
CH6_PJ+: P-CH5+6.2, SSR_6HJ.6 (O2)
CH7_O+: SSR_7AB.5 (O1), SSR_7AB.7 (O1), SSR_7CD.5 (O1), SSR_7CD.7 (O1), SSR_7EF.5 (O1), SSR_7EF.7 (O1), SSR_7GH.5 (O1), SSR_7GH.7 (O1), SSR_7J/8A.7 (O1); also elsewhere on the board
CH7_O-: P-CH7+8.12, P-CH7+8.18; also elsewhere on the board
CH7_PA+: P-CH7+8.22, SSR_7AB.8 (O2)
CH7_PB+: P-CH7+8.21, SSR_7AB.6 (O2)
CH7_PC+: P-CH7+8.20, SSR_7CD.8 (O2)
CH7_PD+: P-CH7+8.19, SSR_7CD.6 (O2)
CH7_PE+: P-CH7+8.17, SSR_7EF.8 (O2)
CH7_PF+: P-CH7+8.16, SSR_7EF.6 (O2)
CH7_PG+: P-CH7+8.15, SSR_7GH.8 (O2)
CH7_PH+: P-CH7+8.14, SSR_7GH.6 (O2)
CH7_PJ+: P-CH7+8.13, SSR_7J/8A.8 (O2)
CH8_O+: SSR_7J/8A.5 (O1), SSR_8BC.5 (O1), SSR_8BC.7 (O1), SSR_8DE.5 (O1), SSR_8DE.7 (O1), SSR_8FG.5 (O1), SSR_8FG.7 (O1), SSR_8HJ.5 (O1), SSR_8HJ.7 (O1); also elsewhere on the board
CH8_O-: P-CH7+8.1, P-CH7+8.7; also elsewhere on the board
CH8_PA+: P-CH7+8.11, SSR_7J/8A.6 (O2)
CH8_PB+: P-CH7+8.10, SSR_8BC.8 (O2)
CH8_PC+: P-CH7+8.9, SSR_8BC.6 (O2)
CH8_PD+: P-CH7+8.8, SSR_8DE.8 (O2)
CH8_PE+: P-CH7+8.6, SSR_8DE.6 (O2)
CH8_PF+: P-CH7+8.5, SSR_8FG.8 (O2)
CH8_PG+: P-CH7+8.4, SSR_8FG.6 (O2)
CH8_PH+: P-CH7+8.3, SSR_8HJ.8 (O2)
CH8_PJ+: P-CH7+8.2, SSR_8HJ.6 (O2)
unnamed: R_3A.1, SSR_3AB.1 (I+)
unnamed: R_3B.1, SSR_3AB.3 (I+)
unnamed: R_3C.1, SSR_3CD.1 (I+)
unnamed: R_3D.1, SSR_3CD.3 (I+)
unnamed: R_3E.1, SSR_3EF.1 (I+)
unnamed: R_3F.1, SSR_3EF.3 (I+)
unnamed: R_3G.1, SSR_3GH.1 (I+)
unnamed: R_3H.1, SSR_3GH.3 (I+)
unnamed: R_3J.1, SSR_3J/4A.1 (I+)
unnamed: R_4A.1, SSR_3J/4A.3 (I+)
unnamed: R_4B.1, SSR_4BC.1 (I+)
unnamed: R_4C.1, SSR_4BC.3 (I+)
unnamed: R_4D.1, SSR_4DE.1 (I+)
unnamed: R_4E.1, SSR_4DE.3 (I+)
unnamed: R_4F.1, SSR_4FG.1 (I+)
unnamed: R_4J.1, SSR_4HJ.3 (I+)
unnamed: R_4H.1, SSR_4HJ.1 (I+)
unnamed: R_4G.1, SSR_4FG.3 (I+)
unnamed: R_5A.1, SSR_5AB.1 (I+)
unnamed: R_5B.1, SSR_5AB.3 (I+)
unnamed: R_5C.1, SSR_5CD.1 (I+)
unnamed: R_5D.1, SSR_5CD.3 (I+)
unnamed: R_5E.1, SSR_5EF.1 (I+)
unnamed: R_5F.1, SSR_5EF.3 (I+)
unnamed: R_5G.1, SSR_5GH.1 (I+)
unnamed: R_5H.1, SSR_5GH.3 (I+)
unnamed: R_5J.1, SSR_5J/6A.1 (I+)
unnamed: R_6A.1, SSR_5J/6A.3 (I+)
unnamed: R_6B.1, SSR_6BC.1 (I+)
unnamed: R_6C.1, SSR_6BC.3 (I+)
unnamed: R_6D.1, SSR_6DE.1 (I+)
unnamed: R_6E.1, SSR_6DE.3 (I+)
unnamed: R_6F.1, SSR_6FG.1 (I+)
unnamed: R_6J.1, SSR_6HJ.3 (I+)
unnamed: R_6H.1, SSR_6HJ.1 (I+)
unnamed: R_6G.1, SSR_6FG.3 (I+)
unnamed: R_7A.1, SSR_7AB.1 (I+)
unnamed: R_7B.1, SSR_7AB.3 (I+)
unnamed: R_7C.1, SSR_7CD.1 (I+)
unnamed: R_7D.1, SSR_7CD.3 (I+)
unnamed: R_7E.1, SSR_7EF.1 (I+)
unnamed: R_1A.1, SSR_1AB.1 (I+)
unnamed: R_1B.1, SSR_1AB.3 (I+)
unnamed: R_7F.1, SSR_7EF.3 (I+)
unnamed: R_7G.1, SSR_7GH.1 (I+)
unnamed: R_1C.1, SSR_1CD.1 (I+)
unnamed: R_1D.1, SSR_1CD.3 (I+)
unnamed: R_1E.1, SSR_1EF.1 (I+)
unnamed: R_1F.1, SSR_1EF.3 (I+)
unnamed: R_1G.1, SSR_1GH.1 (I+)
unnamed: R_1H.1, SSR_1GH.3 (I+)
unnamed: R_1J.1, SSR_1J/2A.1 (I+)
unnamed: R_2A.1, SSR_1J/2A.3 (I+)
unnamed: R_2B.1, SSR_2BC.1 (I+)
unnamed: R_2C.1, SSR_2BC.3 (I+)
unnamed: R_7H.1, SSR_7GH.3 (I+)
unnamed: R_7J.1, SSR_7J/8A.1 (I+)
unnamed: R_8A.1, SSR_7J/8A.3 (I+)
unnamed: R_8B.1, SSR_8BC.1 (I+)
unnamed: R_8C.1, SSR_8BC.3 (I+)
unnamed: R_8D.1, SSR_8DE.1 (I+)
unnamed: R_8E.1, SSR_8DE.3 (I+)
unnamed: R_8F.1, SSR_8FG.1 (I+)
unnamed: R_8J.1, SSR_8HJ.3 (I+)
unnamed: R_2D.1, SSR_2DE.1 (I+)
unnamed: R_2E.1, SSR_2DE.3 (I+)
unnamed: R_2F.1, SSR_2FG.1 (I+)
unnamed: R_2J.1, SSR_2HJ.3 (I+)
unnamed: R_2H.1, SSR_2HJ.1 (I+)
unnamed: R_2G.1, SSR_2FG.3 (I+)
unnamed: R_8H.1, SSR_8HJ.1 (I+)
unnamed: R_8G.1, SSR_8FG.3 (I+)
REG_CLR: SHIFTER0.10 (!SCLR), SHIFTER1.10 (!SCLR), SHIFTER2.10 (!SCLR), SHIFTER3.10 (!SCLR), SHIFTER4.10 (!SCLR), SHIFTER5.10 (!SCLR), SHIFTER6.10 (!SCLR), SHIFTER7.10 (!SCLR), SHIFTER8.10 (!SCLR); also elsewhere on the board
REG_LOAD: SHIFTER0.12 (RCK), SHIFTER1.12 (RCK), SHIFTER2.12 (RCK), SHIFTER3.12 (RCK), SHIFTER4.12 (RCK), SHIFTER5.12 (RCK), SHIFTER6.12 (RCK), SHIFTER7.12 (RCK), SHIFTER8.12 (RCK); also elsewhere on the board
REG_OE: SHIFTER0.13 (!G), SHIFTER1.13 (!G), SHIFTER2.13 (!G), SHIFTER3.13 (!G), SHIFTER4.13 (!G), SHIFTER5.13 (!G), SHIFTER6.13 (!G), SHIFTER7.13 (!G), SHIFTER8.13 (!G); also elsewhere on the board
SPI_MOSI: SHIFTER0.14 (SI); also elsewhere on the board
SPI_SCLK: SHIFTER0.11 (SCK), SHIFTER1.11 (SCK), SHIFTER2.11 (SCK), SHIFTER3.11 (SCK), SHIFTER4.11 (SCK), SHIFTER5.11 (SCK), SHIFTER6.11 (SCK), SHIFTER7.11 (SCK), SHIFTER8.11 (SCK); also elsewhere on the board
SPI_SO1-SI2: SHIFTER0.9 (SO), SHIFTER1.14 (SI)
SPI_SO2-SI3: SHIFTER1.9 (SO), SHIFTER2.14 (SI)
SPI_SO3-SI4: SHIFTER2.9 (SO), SHIFTER3.14 (SI)
SPI_SO4-SI5: SHIFTER3.9 (SO), SHIFTER4.14 (SI)
SPI_SO5-SI6: SHIFTER4.9 (SO), SHIFTER5.14 (SI)
SPI_SO6-SI7: SHIFTER5.9 (SO), SHIFTER6.14 (SI)
SPI_SO7-SI8: SHIFTER6.9 (SO), SHIFTER7.14 (SI)
SPI_SO8-SI9: SHIFTER7.9 (SO), SHIFTER8.14 (SI)
SW-1A: SHIFTER0.15 (Q0), SSR_1AB.2 (I-)
SW-1B: SHIFTER0.1 (Q1), SSR_1AB.4 (I-)
SW-1C: SHIFTER0.2 (Q2), SSR_1CD.2 (I-)
SW-1D: SHIFTER0.3 (Q3), SSR_1CD.4 (I-)
SW-1E: SHIFTER0.4 (Q4), SSR_1EF.2 (I-)
SW-1F: SHIFTER0.5 (Q5), SSR_1EF.4 (I-)
SW-1G: SHIFTER0.6 (Q6), SSR_1GH.2 (I-)
SW-1H: SHIFTER0.7 (Q7), SSR_1GH.4 (I-)
SW-1J: SHIFTER1.15 (Q0), SSR_1J/2A.2 (I-)
SW-2A: SHIFTER1.1 (Q1), SSR_1J/2A.4 (I-)
SW-2B: SHIFTER1.2 (Q2), SSR_2BC.2 (I-)
SW-2C: SHIFTER1.3 (Q3), SSR_2BC.4 (I-)
SW-2D: SHIFTER1.4 (Q4), SSR_2DE.2 (I-)
SW-2E: SHIFTER1.5 (Q5), SSR_2DE.4 (I-)
SW-2F: SHIFTER1.6 (Q6), SSR_2FG.2 (I-)
SW-2G: SHIFTER1.7 (Q7), SSR_2FG.4 (I-)
SW-2H: SHIFTER2.15 (Q0), SSR_2HJ.2 (I-)
SW-2J: SHIFTER2.1 (Q1), SSR_2HJ.4 (I-)
SW-3A: SHIFTER2.2 (Q2), SSR_3AB.2 (I-)
SW-3B: SHIFTER2.3 (Q3), SSR_3AB.4 (I-)
SW-3C: SHIFTER2.4 (Q4), SSR_3CD.2 (I-)
SW-3D: SHIFTER2.5 (Q5), SSR_3CD.4 (I-)
SW-3E: SHIFTER2.6 (Q6), SSR_3EF.2 (I-)
SW-3F: SHIFTER2.7 (Q7), SSR_3EF.4 (I-)
SW-3G: SHIFTER3.15 (Q0), SSR_3GH.2 (I-)
SW-3H: SHIFTER3.1 (Q1), SSR_3GH.4 (I-)
SW-3J: SHIFTER3.2 (Q2), SSR_3J/4A.2 (I-)
SW-4A: SHIFTER3.3 (Q3), SSR_3J/4A.4 (I-)
SW-4B: SHIFTER3.4 (Q4), SSR_4BC.2 (I-)
SW-4C: SHIFTER3.5 (Q5), SSR_4BC.4 (I-)
SW-4D: SHIFTER3.6 (Q6), SSR_4DE.2 (I-)
SW-4E: SHIFTER3.7 (Q7), SSR_4DE.4 (I-)
SW-4F: SHIFTER4.15 (Q0), SSR_4FG.2 (I-)
SW-4G: SHIFTER4.1 (Q1), SSR_4FG.4 (I-)
SW-4H: SHIFTER4.2 (Q2), SSR_4HJ.2 (I-)
SW-4J: SHIFTER4.3 (Q3), SSR_4HJ.4 (I-)
SW-5A: SHIFTER4.4 (Q4), SSR_5AB.2 (I-)
SW-5B: SHIFTER4.5 (Q5), SSR_5AB.4 (I-)
SW-5C: SHIFTER4.6 (Q6), SSR_5CD.2 (I-)
SW-5D: SHIFTER4.7 (Q7), SSR_5CD.4 (I-)
SW-5E: SHIFTER5.15 (Q0), SSR_5EF.2 (I-)
SW-5F: SHIFTER5.1 (Q1), SSR_5EF.4 (I-)
SW-5G: SHIFTER5.2 (Q2), SSR_5GH.2 (I-)
SW-5H: SHIFTER5.3 (Q3), SSR_5GH.4 (I-)
SW-5J: SHIFTER5.4 (Q4), SSR_5J/6A.2 (I-)
SW-6A: SHIFTER5.5 (Q5), SSR_5J/6A.4 (I-)
SW-6B: SHIFTER5.6 (Q6), SSR_6BC.2 (I-)
SW-6C: SHIFTER5.7 (Q7), SSR_6BC.4 (I-)
SW-6D: SHIFTER6.15 (Q0), SSR_6DE.2 (I-)
SW-6E: SHIFTER6.1 (Q1), SSR_6DE.4 (I-)
SW-6F: SHIFTER6.2 (Q2), SSR_6FG.2 (I-)
SW-6G: SHIFTER6.3 (Q3), SSR_6FG.4 (I-)
SW-6H: SHIFTER6.4 (Q4), SSR_6HJ.2 (I-)
SW-6J: SHIFTER6.5 (Q5), SSR_6HJ.4 (I-)
SW-7A: SHIFTER6.6 (Q6), SSR_7AB.2 (I-)
SW-7B: SHIFTER6.7 (Q7), SSR_7AB.4 (I-)
SW-7C: SHIFTER7.15 (Q0), SSR_7CD.2 (I-)
SW-7D: SHIFTER7.1 (Q1), SSR_7CD.4 (I-)
SW-7E: SHIFTER7.2 (Q2), SSR_7EF.2 (I-)
SW-7F: SHIFTER7.3 (Q3), SSR_7EF.4 (I-)
SW-7G: SHIFTER7.4 (Q4), SSR_7GH.2 (I-)
SW-7H: SHIFTER7.5 (Q5), SSR_7GH.4 (I-)
SW-7J: SHIFTER7.6 (Q6), SSR_7J/8A.2 (I-)
SW-8A: SHIFTER7.7 (Q7), SSR_7J/8A.4 (I-)
SW-8B: SHIFTER8.15 (Q0), SSR_8BC.2 (I-)
SW-8C: SHIFTER8.1 (Q1), SSR_8BC.4 (I-)
SW-8D: SHIFTER8.2 (Q2), SSR_8DE.2 (I-)
SW-8E: SHIFTER8.3 (Q3), SSR_8DE.4 (I-)
SW-8F: SHIFTER8.4 (Q4), SSR_8FG.2 (I-)
SW-8G: SHIFTER8.5 (Q5), SSR_8FG.4 (I-)
SW-8H: SHIFTER8.6 (Q6), SSR_8HJ.2 (I-)
SW-8J: SHIFTER8.7 (Q7), SSR_8HJ.4 (I-)

Notes on the sheet:
OUTPUT STAGE
Relays 1-8(A-J)
Shift registers
Supply
Connectors
CH 1-2
CH 3-4
CH 5-6
CH 7-8

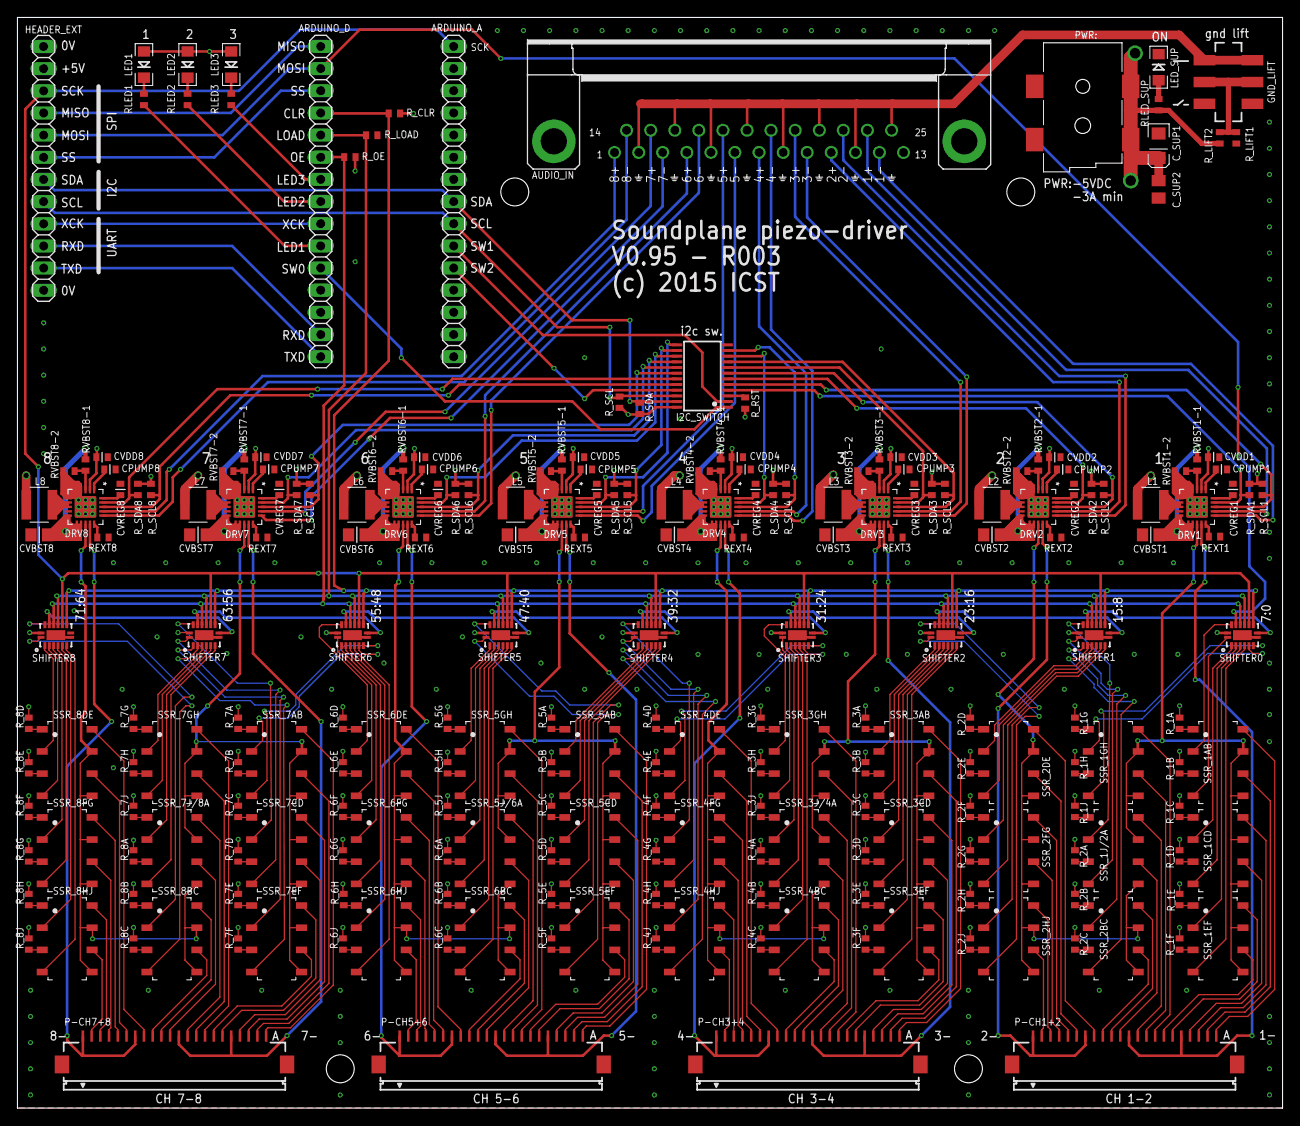
[picture p38: board piezo-driver_v0.95-R003.brd from above]

Board: 4 copper layers, 145.0 x 125.0 mm, 234 parts (0 on the bottom side), 347 nets.
