ICST-AHMI/HSoundplane_design/eagle/piezo-driver/piezo-driver_v0.1-R002.brd

## EAGLE design eagle/piezo-driver/piezo-driver_v0.1-R002.brd (2015-09-08, an earlier design)

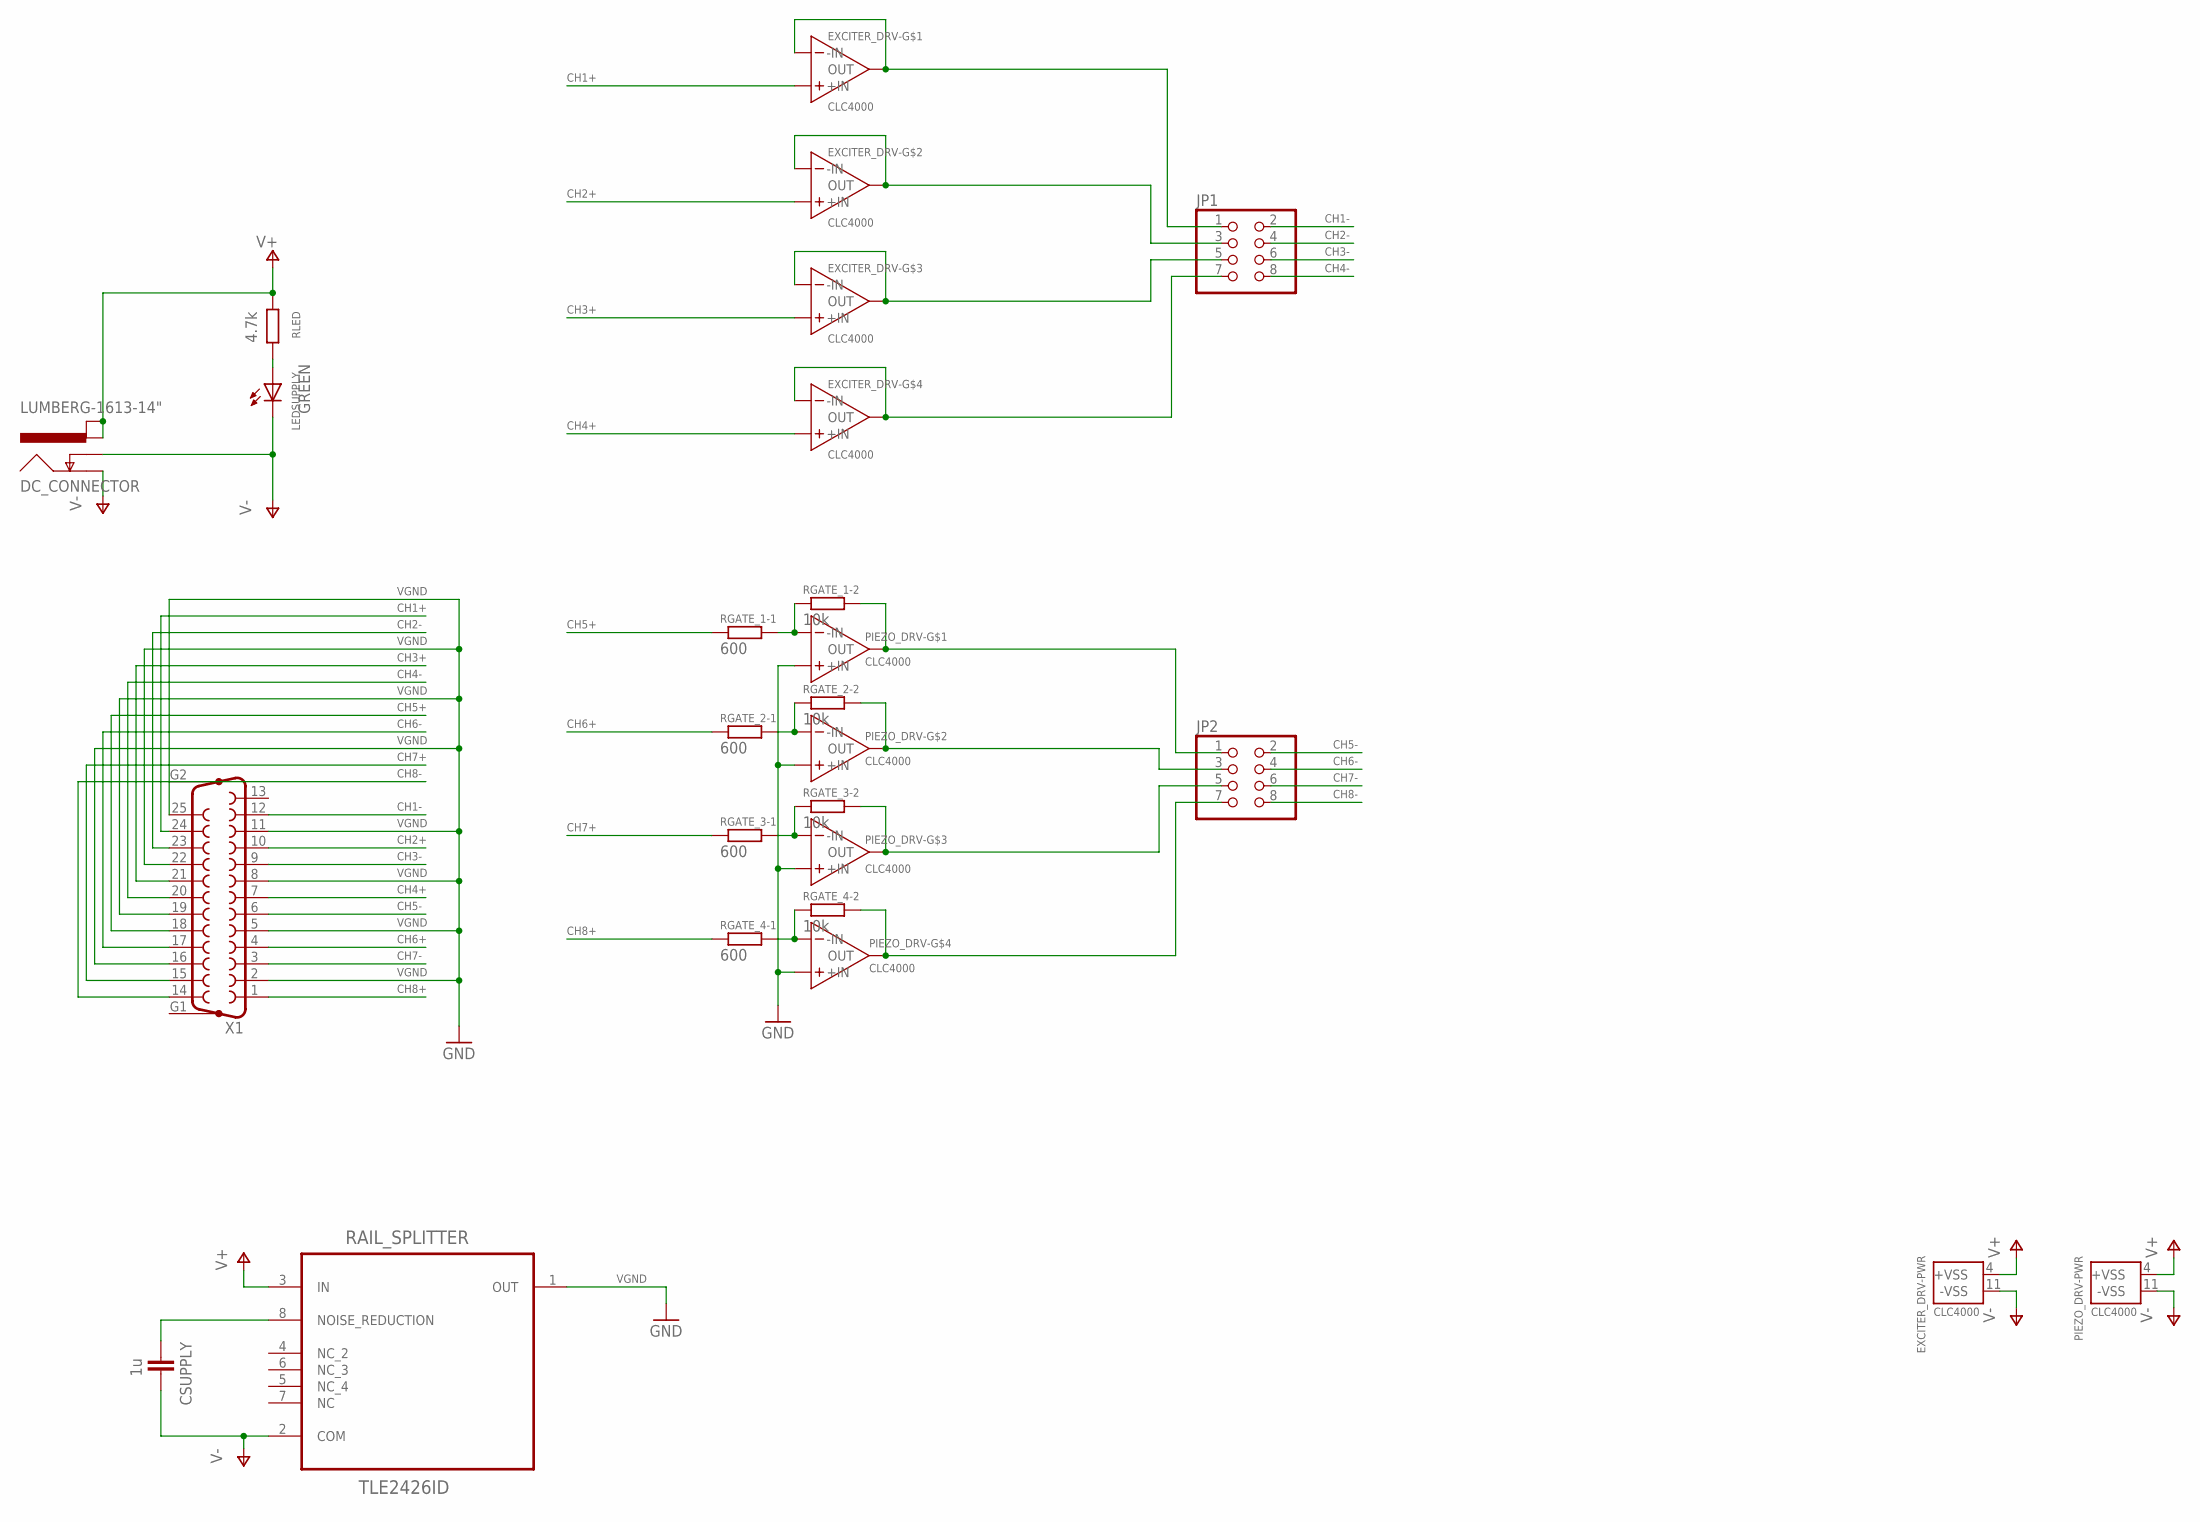
[picture p39: schematic piezo-driver_v0.1-R002.sch]

Parts:
CSUPPLY: 1u; C0603
DC_CONNECTOR: LUMBERG-1613-14"; LUMBERG-1613_14
EXCITER_DRV: CLC4000; SOIC-14
JP1, JP2: PINHD-2X4/90; 2X04/90
LEDSUPPLY: GREEN; LED3MM
PIEZO_DRV: CLC4000; SOIC-14
RAIL_SPLITTER: TLE2426ID; SOIC127P600X175-8N
RGATE_1-1, RGATE_2-1, RGATE_3-1, RGATE_4-1: 600; R0805
RGATE_1-2, RGATE_2-2, RGATE_3-2, RGATE_4-2: 10k; R0805
RLED: 4.7k; R0805
X1: F25HP

Connections:
CH1+: EXCITER_DRV.3 (+IN), X1.24
CH1-: JP1.2, X1.12
CH2+: EXCITER_DRV.5 (+IN), X1.10
CH2-: JP1.4, X1.23
CH3+: EXCITER_DRV.10 (+IN), X1.21
CH3-: JP1.6, X1.9
CH4+: EXCITER_DRV.12 (+IN), X1.7
CH4-: JP1.8, X1.20
CH5+: RGATE_1-1.1, X1.18
CH5-: JP2.2, X1.6
CH6+: RGATE_2-1.1, X1.4
CH6-: JP2.4, X1.17
CH7+: RGATE_3-1.1, X1.15
CH7-: JP2.6, X1.3
CH8+: RGATE_4-1.1, X1.1
CH8-: JP2.8, X1.14
unnamed: EXCITER_DRV.1 (OUT), EXCITER_DRV.2 (-IN), JP1.1
unnamed: EXCITER_DRV.6 (-IN), EXCITER_DRV.7 (OUT), JP1.3
unnamed: EXCITER_DRV.8 (OUT), EXCITER_DRV.9 (-IN), JP1.5
unnamed: EXCITER_DRV.13 (-IN), EXCITER_DRV.14 (OUT), JP1.7
unnamed: CSUPPLY.1, RAIL_SPLITTER.8 (NOISE_REDUCTION)
unnamed: PIEZO_DRV.2 (-IN), RGATE_1-1.2, RGATE_1-2.1
unnamed: JP2.1, PIEZO_DRV.1 (OUT), RGATE_1-2.2
unnamed: PIEZO_DRV.6 (-IN), RGATE_2-1.2, RGATE_2-2.1
unnamed: JP2.3, PIEZO_DRV.7 (OUT), RGATE_2-2.2
unnamed: PIEZO_DRV.9 (-IN), RGATE_3-1.2, RGATE_3-2.1
unnamed: JP2.5, PIEZO_DRV.8 (OUT), RGATE_3-2.2
unnamed: PIEZO_DRV.13 (-IN), RGATE_4-1.2, RGATE_4-2.1
unnamed: JP2.7, PIEZO_DRV.14 (OUT), RGATE_4-2.2
unnamed: LEDSUPPLY.A, RLED.1
V+: DC_CONNECTOR.3 (PWR_1), DC_CONNECTOR.4 (PWR_2), EXCITER_DRV.4 (+VSS), PIEZO_DRV.4 (+VSS), RAIL_SPLITTER.3 (IN), RLED.2
V-: CSUPPLY.2, DC_CONNECTOR.1 (GND), DC_CONNECTOR.2 (GND_INS), EXCITER_DRV.11 (-VSS), LEDSUPPLY.K (C), PIEZO_DRV.11 (-VSS), RAIL_SPLITTER.2 (COM)
VGND: PIEZO_DRV.3 (+IN), PIEZO_DRV.5 (+IN), PIEZO_DRV.10 (+IN), PIEZO_DRV.12 (+IN), RAIL_SPLITTER.1 (OUT), X1.2, X1.5, X1.8, X1.11, X1.16, X1.19, X1.22, X1.25

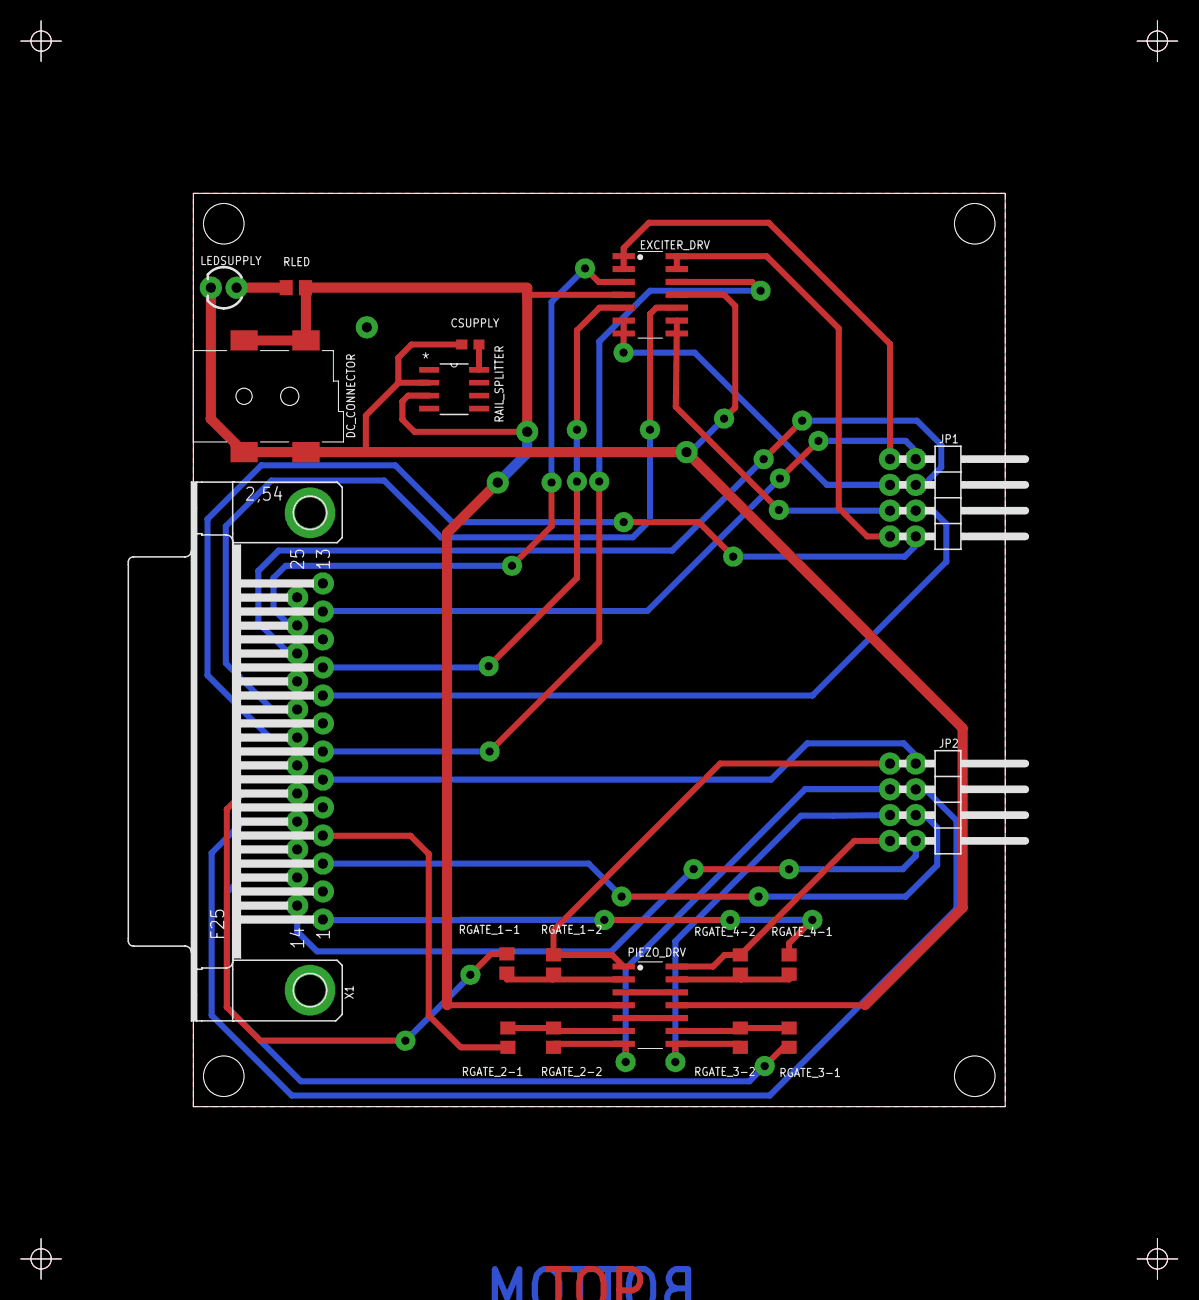
[picture p40: board piezo-driver_v0.1-R002.brd from above]

Board: 2 copper layers, 80.0 x 90.0 mm, 18 parts (0 on the bottom side), 33 nets.
