ICST-AHMI/HSoundplane_design/eagle/piezo-driver/piezo-driver_v0.9a-R001.brd

## EAGLE design eagle/piezo-driver/piezo-driver_v0.9a-R001.brd (2015-09-08)

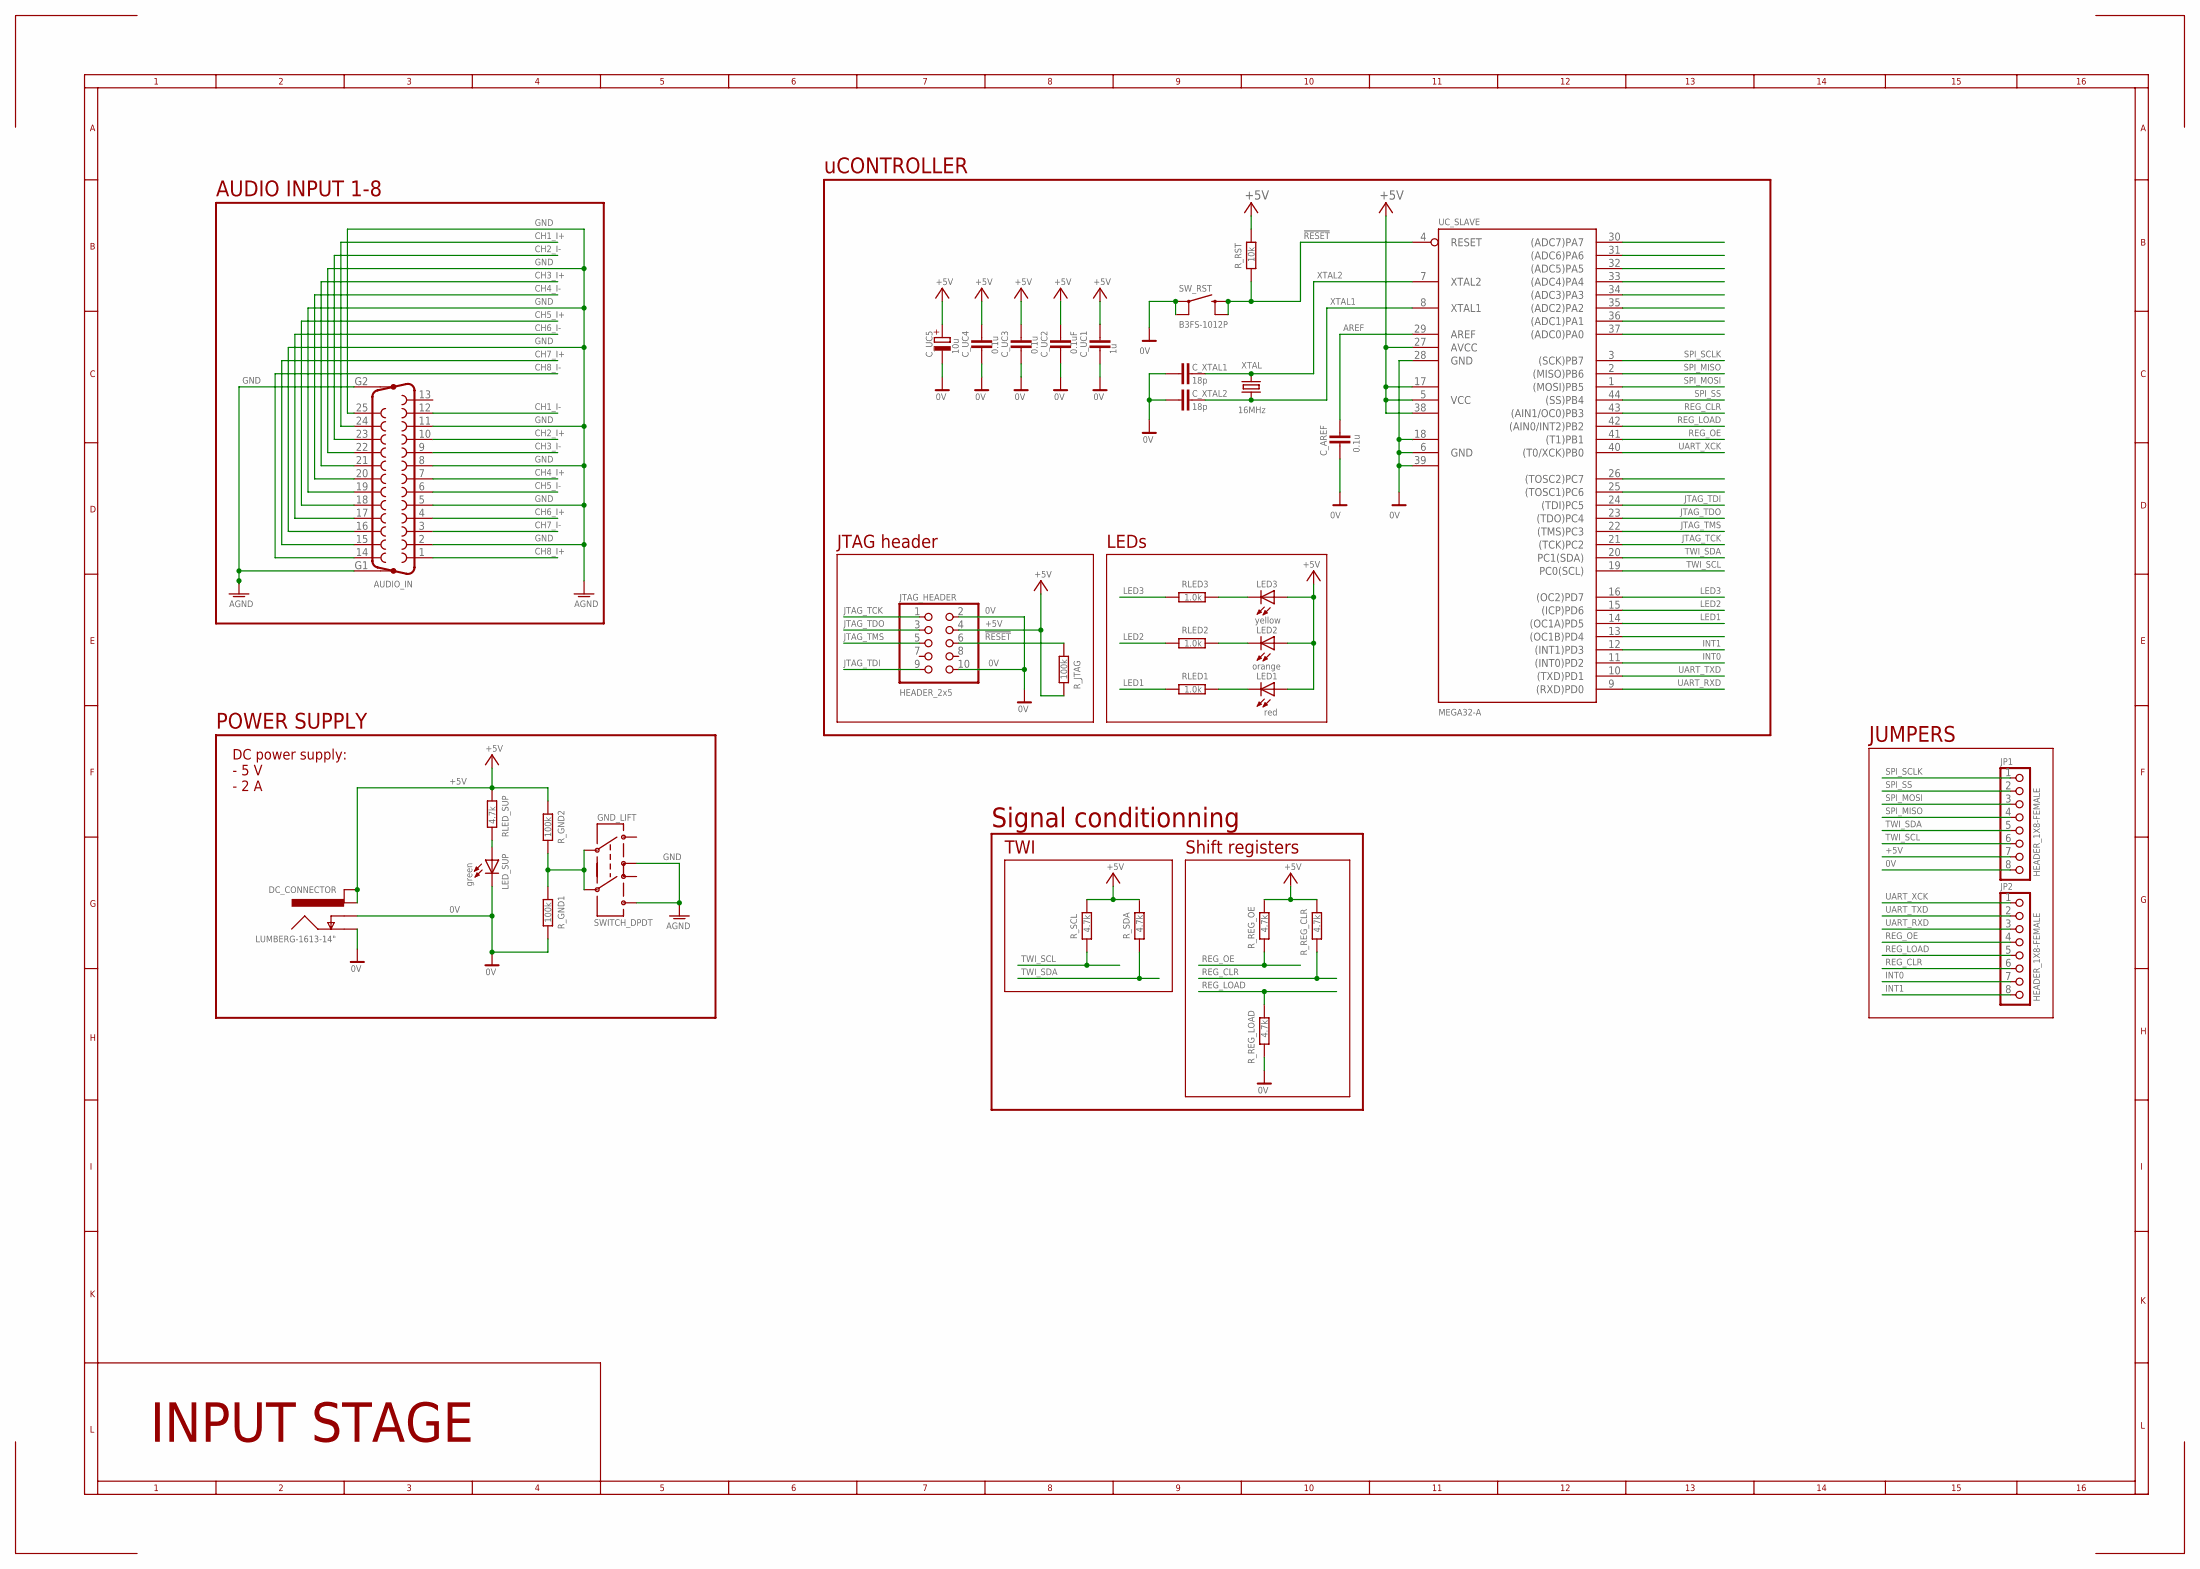
[picture p41: schematic piezo-driver_v0.9a-R001.sch, sheet 1]

Parts:
AUDIO_IN: F25HP
C_AREF: 0.1u; C0402
C_UC1: 1u; C0402
C_UC2: 0.1uF; C0402
C_UC3, C_UC4: 0.1u; C0402
C_UC5: 10u; B/3528-21R
C_XTAL1, C_XTAL2: 18p; C0402
DC_CONNECTOR: LUMBERG-1613-14"; LUMBERG-1613_14
GND_LIFT: SWITCH_DPDT; SWITCH_JS202011
JP1, JP2: HEADER_1X8-FEMALE; 1X08_2.54
JTAG_HEADER: HEADER_2x5; 2X05_1.27MM
LED1: red; LED-0603
LED2: orange; LED-0603
LED3: yellow; LED-0603
LED_SUP: green; LED-0603
RLED1, RLED2, RLED3: 1.0k; R0805
RLED_SUP: 4.7k; R0805
R_GND1, R_GND2: 100k; R0805
R_JTAG: 100k; R0402
R_REG_CLR: 4.7k; R0402
R_REG_LOAD: 4.7k; R0402
R_REG_OE: 4.7k; R0402
R_RST: 10k; R0402
R_SCL: 4.7k; R0402
R_SDA: 4.7k; R0402
SW_RST: B3FS-1012P; B3FS
UC_SLAVE: MEGA32-A; TQFP44
XTAL: 16MHz; CTS406

Connections:
0V: DC_CONNECTOR.2 (GND_INS), JP1.8, JTAG_HEADER.2, JTAG_HEADER.10, LED_SUP.C, R_GND1.1, R_REG_LOAD.1, UC_SLAVE.6 (GND), UC_SLAVE.18 (GND1), UC_SLAVE.28 (GND), UC_SLAVE.39 (GND2); also elsewhere on the board
!RESET: JTAG_HEADER.6, R_JTAG.1, R_RST.1, SW_RST.3 (SW_1), SW_RST.4 (SW_2), UC_SLAVE.4 (RESET)
+5V: C_UC1.2, C_UC2.2, C_UC3.2, C_UC4.2, C_UC5.+, DC_CONNECTOR.3 (PWR_1), DC_CONNECTOR.4 (PWR_2), JP1.7, JTAG_HEADER.4, LED1.A, LED2.A, LED3.A, RLED_SUP.2, R_GND2.2, R_JTAG.2, R_REG_CLR.2, R_REG_OE.2, R_RST.2, R_SCL.2, R_SDA.2, UC_SLAVE.5 (VCC), UC_SLAVE.17 (VCC1), UC_SLAVE.27 (AVCC), UC_SLAVE.38 (VCC2); also elsewhere on the board
AREF: C_AREF.2, UC_SLAVE.29 (AREF)
CH1_I+: AUDIO_IN.24; also elsewhere on the board
CH1_I-: AUDIO_IN.12; also elsewhere on the board
CH2_I+: AUDIO_IN.10; also elsewhere on the board
CH2_I-: AUDIO_IN.23; also elsewhere on the board
CH3_I+: AUDIO_IN.21; also elsewhere on the board
CH3_I-: AUDIO_IN.9; also elsewhere on the board
CH4_I+: AUDIO_IN.7; also elsewhere on the board
CH4_I-: AUDIO_IN.20; also elsewhere on the board
CH5_I+: AUDIO_IN.18; also elsewhere on the board
CH5_I-: AUDIO_IN.6; also elsewhere on the board
CH6_I+: AUDIO_IN.4; also elsewhere on the board
CH6_I-: AUDIO_IN.17; also elsewhere on the board
CH7_I+: AUDIO_IN.15; also elsewhere on the board
CH7_I-: AUDIO_IN.3; also elsewhere on the board
CH8_I+: AUDIO_IN.1; also elsewhere on the board
CH8_I-: AUDIO_IN.14; also elsewhere on the board
GND: AUDIO_IN.2, AUDIO_IN.5, AUDIO_IN.8, AUDIO_IN.11, AUDIO_IN.16, AUDIO_IN.19, AUDIO_IN.22, AUDIO_IN.25, AUDIO_IN.G1, AUDIO_IN.G2, C_AREF.1, C_UC1.1, C_UC2.1, C_UC3.1, C_UC4.1, C_UC5.-, C_XTAL1.1, C_XTAL2.1, DC_CONNECTOR.1 (GND), GND_LIFT.1 (T1A), GND_LIFT.4 (T2A), SW_RST.1 (CON_1), SW_RST.2 (CON_2)
INT0: JP2.7, UC_SLAVE.11 ((INT0)PD2)
INT1: JP2.8, UC_SLAVE.12 ((INT1)PD3)
JTAG_TCK: JTAG_HEADER.1, UC_SLAVE.21 ((TCK)PC2)
JTAG_TDI: JTAG_HEADER.9, UC_SLAVE.24 ((TDI)PC5)
JTAG_TDO: JTAG_HEADER.3, UC_SLAVE.23 ((TDO)PC4)
JTAG_TMS: JTAG_HEADER.5, UC_SLAVE.22 ((TMS)PC3)
LED1: RLED1.1, UC_SLAVE.14 ((OC1A)PD5)
LED2: RLED2.1, UC_SLAVE.15 ((ICP)PD6)
LED3: RLED3.1, UC_SLAVE.16 ((OC2)PD7)
unnamed: LED_SUP.A, RLED_SUP.1
unnamed: LED3.C, RLED3.2
unnamed: LED2.C, RLED2.2
unnamed: LED1.C, RLED1.2
unnamed: GND_LIFT.2 (P1), GND_LIFT.5 (P2), R_GND1.2, R_GND2.1
REG_CLR: JP2.6, R_REG_CLR.1, UC_SLAVE.43 ((AIN1/OC0)PB3); also elsewhere on the board
REG_LOAD: JP2.5, R_REG_LOAD.2, UC_SLAVE.42 ((AIN0/INT2)PB2); also elsewhere on the board
REG_OE: JP2.4, R_REG_OE.1, UC_SLAVE.41 ((T1)PB1); also elsewhere on the board
SPI_MISO: JP1.4, UC_SLAVE.2 ((MISO)PB6)
SPI_MOSI: JP1.3, UC_SLAVE.1 ((MOSI)PB5); also elsewhere on the board
SPI_SCLK: JP1.1, UC_SLAVE.3 ((SCK)PB7); also elsewhere on the board
SPI_SS: JP1.2, UC_SLAVE.44 ((SS)PB4)
TWI_SCL: JP1.6, R_SCL.1, UC_SLAVE.19 (PC0(SCL)); also elsewhere on the board
TWI_SDA: JP1.5, R_SDA.1, UC_SLAVE.20 (PC1(SDA)); also elsewhere on the board
UART_RXD: JP2.3, UC_SLAVE.9 ((RXD)PD0)
UART_TXD: JP2.2, UC_SLAVE.10 ((TXD)PD1); also elsewhere on the board
UART_XCK: JP2.1, UC_SLAVE.40 ((T0/XCK)PB0)
XTAL1: C_XTAL2.2, UC_SLAVE.8 (XTAL1), XTAL.1
XTAL2: C_XTAL1.2, UC_SLAVE.7 (XTAL2), XTAL.3 (2)

Notes on the sheet:
AUDIO INPUT 1-8
POWER SUPPLY
DC power supply: - 5 V - 2 A
INPUT STAGE
uCONTROLLER
LEDs
JUMPERS
JTAG header
Signal conditionning
TWI
Shift registers

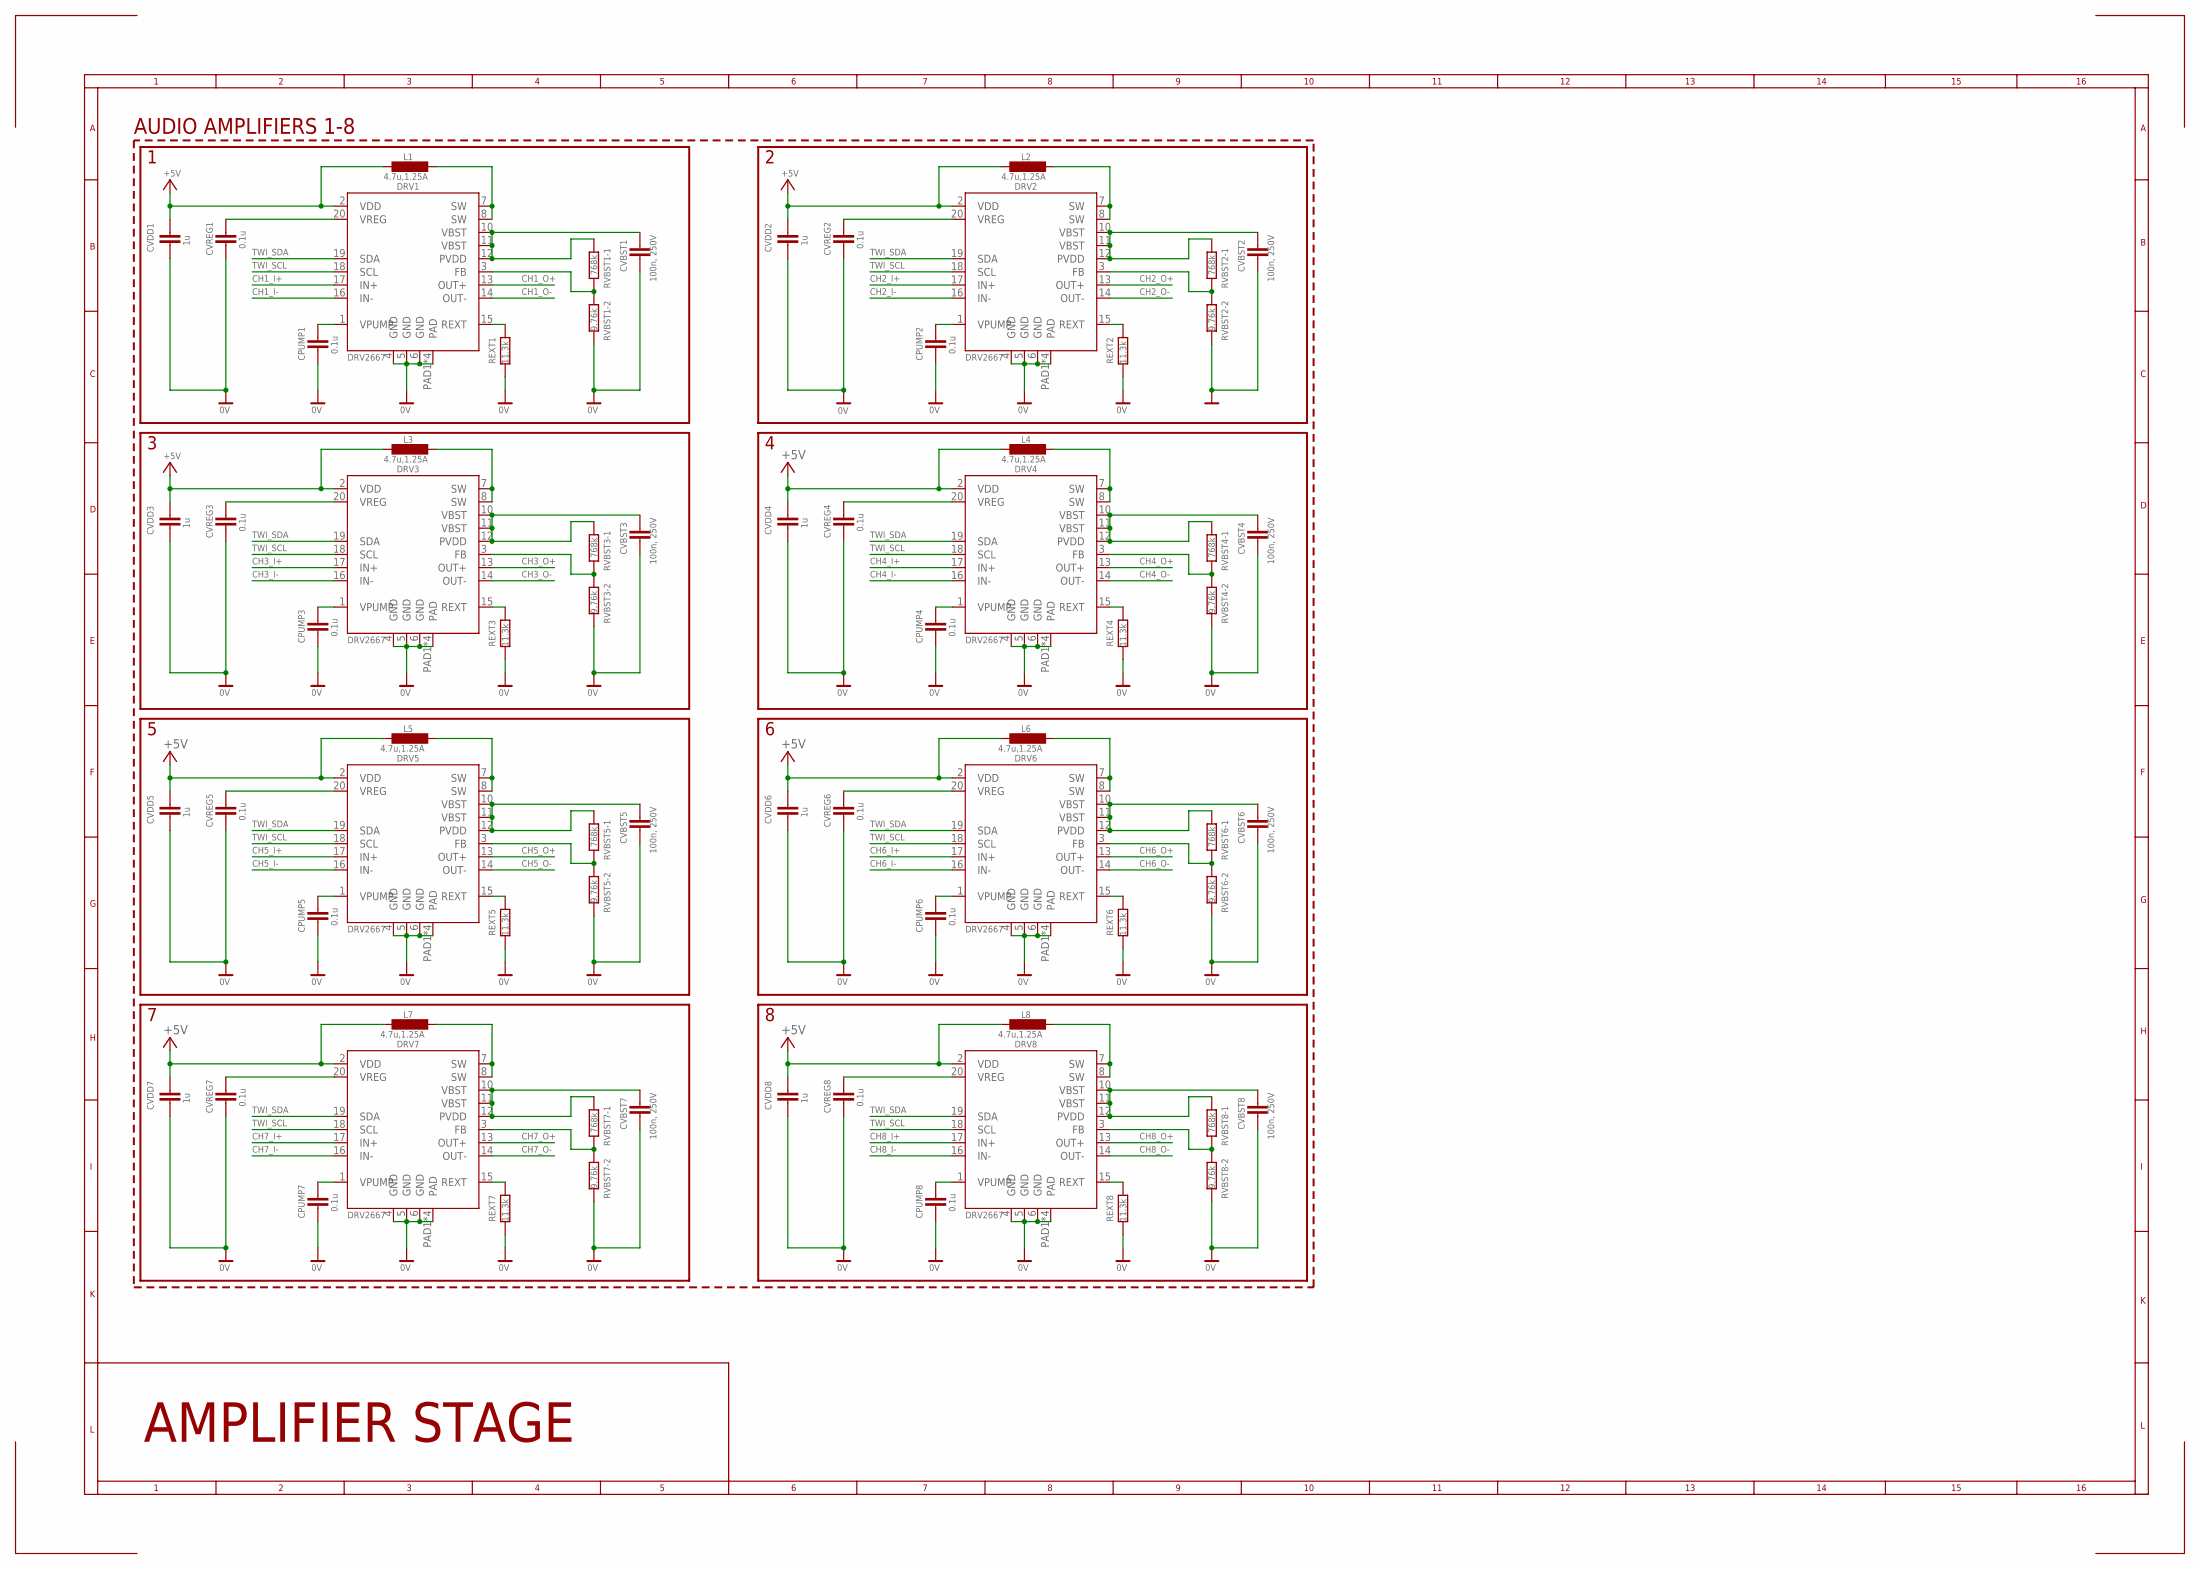
[picture p42: schematic piezo-driver_v0.9a-R001.sch, sheet 2]

Parts:
CPUMP1, CPUMP2, CPUMP3, CPUMP4, CPUMP5, CPUMP6, CPUMP7, CPUMP8: 0.1u; C0805
CVBST1, CVBST2, CVBST3, CVBST4, CVBST5, CVBST6, CVBST7, CVBST8: 100n, 250V; C0805
CVDD1, CVDD2, CVDD3, CVDD4, CVDD5, CVDD6, CVDD7, CVDD8: 1u; C0805
CVREG1, CVREG2, CVREG3, CVREG4, CVREG5, CVREG6, CVREG7, CVREG8: 0.1u; C0805
DRV1, DRV2, DRV3, DRV4, DRV5, DRV6, DRV7, DRV8: DRV2667QFN; QFN400X400
L1, L2, L3, L4, L5, L6, L7, L8: 4.7u,1.25A; L3225M
REXT1, REXT2, REXT3, REXT4, REXT5, REXT6, REXT7, REXT8: 11.3k; R0805
RVBST1-1, RVBST2-1, RVBST3-1, RVBST4-1, RVBST5-1, RVBST6-1, RVBST7-1, RVBST8-1: 768k; R0805
RVBST1-2, RVBST2-2, RVBST3-2, RVBST4-2, RVBST5-2, RVBST6-2, RVBST7-2, RVBST8-2: 9.76k; R0805

Connections:
0V: CPUMP1.2, CPUMP2.2, CPUMP3.2, CPUMP4.2, CPUMP5.2, CPUMP6.2, CPUMP7.2, CPUMP8.2, CVBST1.2, CVBST2.2, CVBST3.2, CVBST4.2, CVBST5.2, CVBST6.2, CVBST7.2, CVBST8.2, CVDD1.2, CVDD2.2, CVDD3.2, CVDD4.2, CVDD5.2, CVDD6.2, CVDD7.2, CVDD8.2, CVREG1.2, CVREG2.2, CVREG3.2, CVREG4.2, CVREG5.2, CVREG6.2, CVREG7.2, CVREG8.2, DRV1.4 (GND), DRV1.5 (GND), DRV1.6 (GND), DRV1.PAD1 (PAD), DRV1.PAD2 (PAD), DRV1.PAD3 (PAD), DRV1.PAD4 (PAD), DRV2.4 (GND), DRV2.5 (GND), DRV2.6 (GND), DRV2.PAD1 (PAD), DRV2.PAD2 (PAD), DRV2.PAD3 (PAD), DRV2.PAD4 (PAD), DRV3.4 (GND), DRV3.5 (GND), DRV3.6 (GND), DRV3.PAD1 (PAD), DRV3.PAD2 (PAD), DRV3.PAD3 (PAD), DRV3.PAD4 (PAD), DRV4.4 (GND), DRV4.5 (GND), DRV4.6 (GND), DRV4.PAD1 (PAD), DRV4.PAD2 (PAD), DRV4.PAD3 (PAD), DRV4.PAD4 (PAD), DRV5.4 (GND), DRV5.5 (GND), DRV5.6 (GND), DRV5.PAD1 (PAD), DRV5.PAD2 (PAD), DRV5.PAD3 (PAD), DRV5.PAD4 (PAD), DRV6.4 (GND), DRV6.5 (GND), DRV6.6 (GND), DRV6.PAD1 (PAD), DRV6.PAD2 (PAD), DRV6.PAD3 (PAD), DRV6.PAD4 (PAD), DRV7.4 (GND), DRV7.5 (GND), DRV7.6 (GND), DRV7.PAD1 (PAD), DRV7.PAD2 (PAD), DRV7.PAD3 (PAD), DRV7.PAD4 (PAD), DRV8.4 (GND), DRV8.5 (GND), DRV8.6 (GND), DRV8.PAD1 (PAD), DRV8.PAD2 (PAD), DRV8.PAD3 (PAD), DRV8.PAD4 (PAD), REXT1.1, REXT2.1, REXT3.1, REXT4.1, REXT5.1, REXT6.1, REXT7.1, REXT8.1, RVBST1-2.1, RVBST2-2.1, RVBST3-2.1, RVBST4-2.1, RVBST5-2.1, RVBST6-2.1, RVBST7-2.1, RVBST8-2.1; also elsewhere on the board
+5V: CVDD1.1, CVDD2.1, CVDD3.1, CVDD4.1, CVDD5.1, CVDD6.1, CVDD7.1, CVDD8.1, DRV1.2 (VDD), DRV2.2 (VDD), DRV3.2 (VDD), DRV4.2 (VDD), DRV5.2 (VDD), DRV6.2 (VDD), DRV7.2 (VDD), DRV8.2 (VDD), L1.2, L2.2, L3.2, L4.2, L5.2, L6.2, L7.2, L8.2; also elsewhere on the board
CH1_I+: DRV1.17 (IN+); also elsewhere on the board
CH1_I-: DRV1.16 (IN-); also elsewhere on the board
CH1_O+: DRV1.13 (OUT+); also elsewhere on the board
CH1_O-: DRV1.14 (OUT-); also elsewhere on the board
CH2_I+: DRV2.17 (IN+); also elsewhere on the board
CH2_I-: DRV2.16 (IN-); also elsewhere on the board
CH2_O+: DRV2.13 (OUT+); also elsewhere on the board
CH2_O-: DRV2.14 (OUT-); also elsewhere on the board
CH3_I+: DRV3.17 (IN+); also elsewhere on the board
CH3_I-: DRV3.16 (IN-); also elsewhere on the board
CH3_O+: DRV3.13 (OUT+); also elsewhere on the board
CH3_O-: DRV3.14 (OUT-); also elsewhere on the board
CH4_I+: DRV4.17 (IN+); also elsewhere on the board
CH4_I-: DRV4.16 (IN-); also elsewhere on the board
CH4_O+: DRV4.13 (OUT+); also elsewhere on the board
CH4_O-: DRV4.14 (OUT-); also elsewhere on the board
CH5_I+: DRV5.17 (IN+); also elsewhere on the board
CH5_I-: DRV5.16 (IN-); also elsewhere on the board
CH5_O+: DRV5.13 (OUT+); also elsewhere on the board
CH5_O-: DRV5.14 (OUT-); also elsewhere on the board
CH6_I+: DRV6.17 (IN+); also elsewhere on the board
CH6_I-: DRV6.16 (IN-); also elsewhere on the board
CH6_O+: DRV6.13 (OUT+); also elsewhere on the board
CH6_O-: DRV6.14 (OUT-); also elsewhere on the board
CH7_I+: DRV7.17 (IN+); also elsewhere on the board
CH7_I-: DRV7.16 (IN-); also elsewhere on the board
CH7_O+: DRV7.13 (OUT+); also elsewhere on the board
CH7_O-: DRV7.14 (OUT-); also elsewhere on the board
CH8_I+: DRV8.17 (IN+); also elsewhere on the board
CH8_I-: DRV8.16 (IN-); also elsewhere on the board
CH8_O+: DRV8.13 (OUT+); also elsewhere on the board
CH8_O-: DRV8.14 (OUT-); also elsewhere on the board
unnamed: DRV1.7 (SW), DRV1.8 (SW), L1.1
unnamed: CVBST1.1, DRV1.10 (VBST), DRV1.11 (VBST), DRV1.12 (PVDD), RVBST1-1.2
unnamed: DRV1.3 (FB), RVBST1-1.1, RVBST1-2.2
unnamed: DRV1.15 (REXT), REXT1.2
unnamed: CPUMP1.1, DRV1.1 (VPUMP)
unnamed: CVREG1.1, DRV1.20 (VREG)
unnamed: DRV3.7 (SW), DRV3.8 (SW), L3.1
unnamed: CVBST3.1, DRV3.10 (VBST), DRV3.11 (VBST), DRV3.12 (PVDD), RVBST3-1.2
unnamed: DRV3.3 (FB), RVBST3-1.1, RVBST3-2.2
unnamed: DRV3.15 (REXT), REXT3.2
unnamed: CPUMP3.1, DRV3.1 (VPUMP)
unnamed: CVREG3.1, DRV3.20 (VREG)
unnamed: DRV2.7 (SW), DRV2.8 (SW), L2.1
unnamed: CVBST2.1, DRV2.10 (VBST), DRV2.11 (VBST), DRV2.12 (PVDD), RVBST2-1.2
unnamed: DRV2.3 (FB), RVBST2-1.1, RVBST2-2.2
unnamed: DRV2.15 (REXT), REXT2.2
unnamed: CPUMP2.1, DRV2.1 (VPUMP)
unnamed: CVREG2.1, DRV2.20 (VREG)
unnamed: DRV4.7 (SW), DRV4.8 (SW), L4.1
unnamed: CVBST4.1, DRV4.10 (VBST), DRV4.11 (VBST), DRV4.12 (PVDD), RVBST4-1.2
unnamed: DRV4.3 (FB), RVBST4-1.1, RVBST4-2.2
unnamed: DRV4.15 (REXT), REXT4.2
unnamed: CPUMP4.1, DRV4.1 (VPUMP)
unnamed: CVREG4.1, DRV4.20 (VREG)
unnamed: DRV5.7 (SW), DRV5.8 (SW), L5.1
unnamed: CVBST5.1, DRV5.10 (VBST), DRV5.11 (VBST), DRV5.12 (PVDD), RVBST5-1.2
unnamed: DRV5.3 (FB), RVBST5-1.1, RVBST5-2.2
unnamed: DRV5.15 (REXT), REXT5.2
unnamed: CPUMP5.1, DRV5.1 (VPUMP)
unnamed: CVREG5.1, DRV5.20 (VREG)
unnamed: DRV7.7 (SW), DRV7.8 (SW), L7.1
unnamed: CVBST7.1, DRV7.10 (VBST), DRV7.11 (VBST), DRV7.12 (PVDD), RVBST7-1.2
unnamed: DRV7.3 (FB), RVBST7-1.1, RVBST7-2.2
unnamed: DRV7.15 (REXT), REXT7.2
unnamed: CPUMP7.1, DRV7.1 (VPUMP)
unnamed: CVREG7.1, DRV7.20 (VREG)
unnamed: DRV6.7 (SW), DRV6.8 (SW), L6.1
unnamed: CVBST6.1, DRV6.10 (VBST), DRV6.11 (VBST), DRV6.12 (PVDD), RVBST6-1.2
unnamed: DRV6.3 (FB), RVBST6-1.1, RVBST6-2.2
unnamed: DRV6.15 (REXT), REXT6.2
unnamed: CPUMP6.1, DRV6.1 (VPUMP)
unnamed: CVREG6.1, DRV6.20 (VREG)
unnamed: DRV8.7 (SW), DRV8.8 (SW), L8.1
unnamed: CVBST8.1, DRV8.10 (VBST), DRV8.11 (VBST), DRV8.12 (PVDD), RVBST8-1.2
unnamed: DRV8.3 (FB), RVBST8-1.1, RVBST8-2.2
unnamed: DRV8.15 (REXT), REXT8.2
unnamed: CPUMP8.1, DRV8.1 (VPUMP)
unnamed: CVREG8.1, DRV8.20 (VREG)
TWI_SCL: DRV1.18 (SCL), DRV2.18 (SCL), DRV3.18 (SCL), DRV4.18 (SCL), DRV5.18 (SCL), DRV6.18 (SCL), DRV7.18 (SCL), DRV8.18 (SCL); also elsewhere on the board
TWI_SDA: DRV1.19 (SDA), DRV2.19 (SDA), DRV3.19 (SDA), DRV4.19 (SDA), DRV5.19 (SDA), DRV6.19 (SDA), DRV7.19 (SDA), DRV8.19 (SDA); also elsewhere on the board

Notes on the sheet:
AMPLIFIER STAGE
AUDIO AMPLIFIERS 1-8
