ICST-AHMI/HSoundplane_design/eagle/piezo-driver/piezo-driver_v0.9a-R001.brd

## EAGLE design eagle/piezo-driver/piezo-driver_v0.9a-R001.brd (continued)

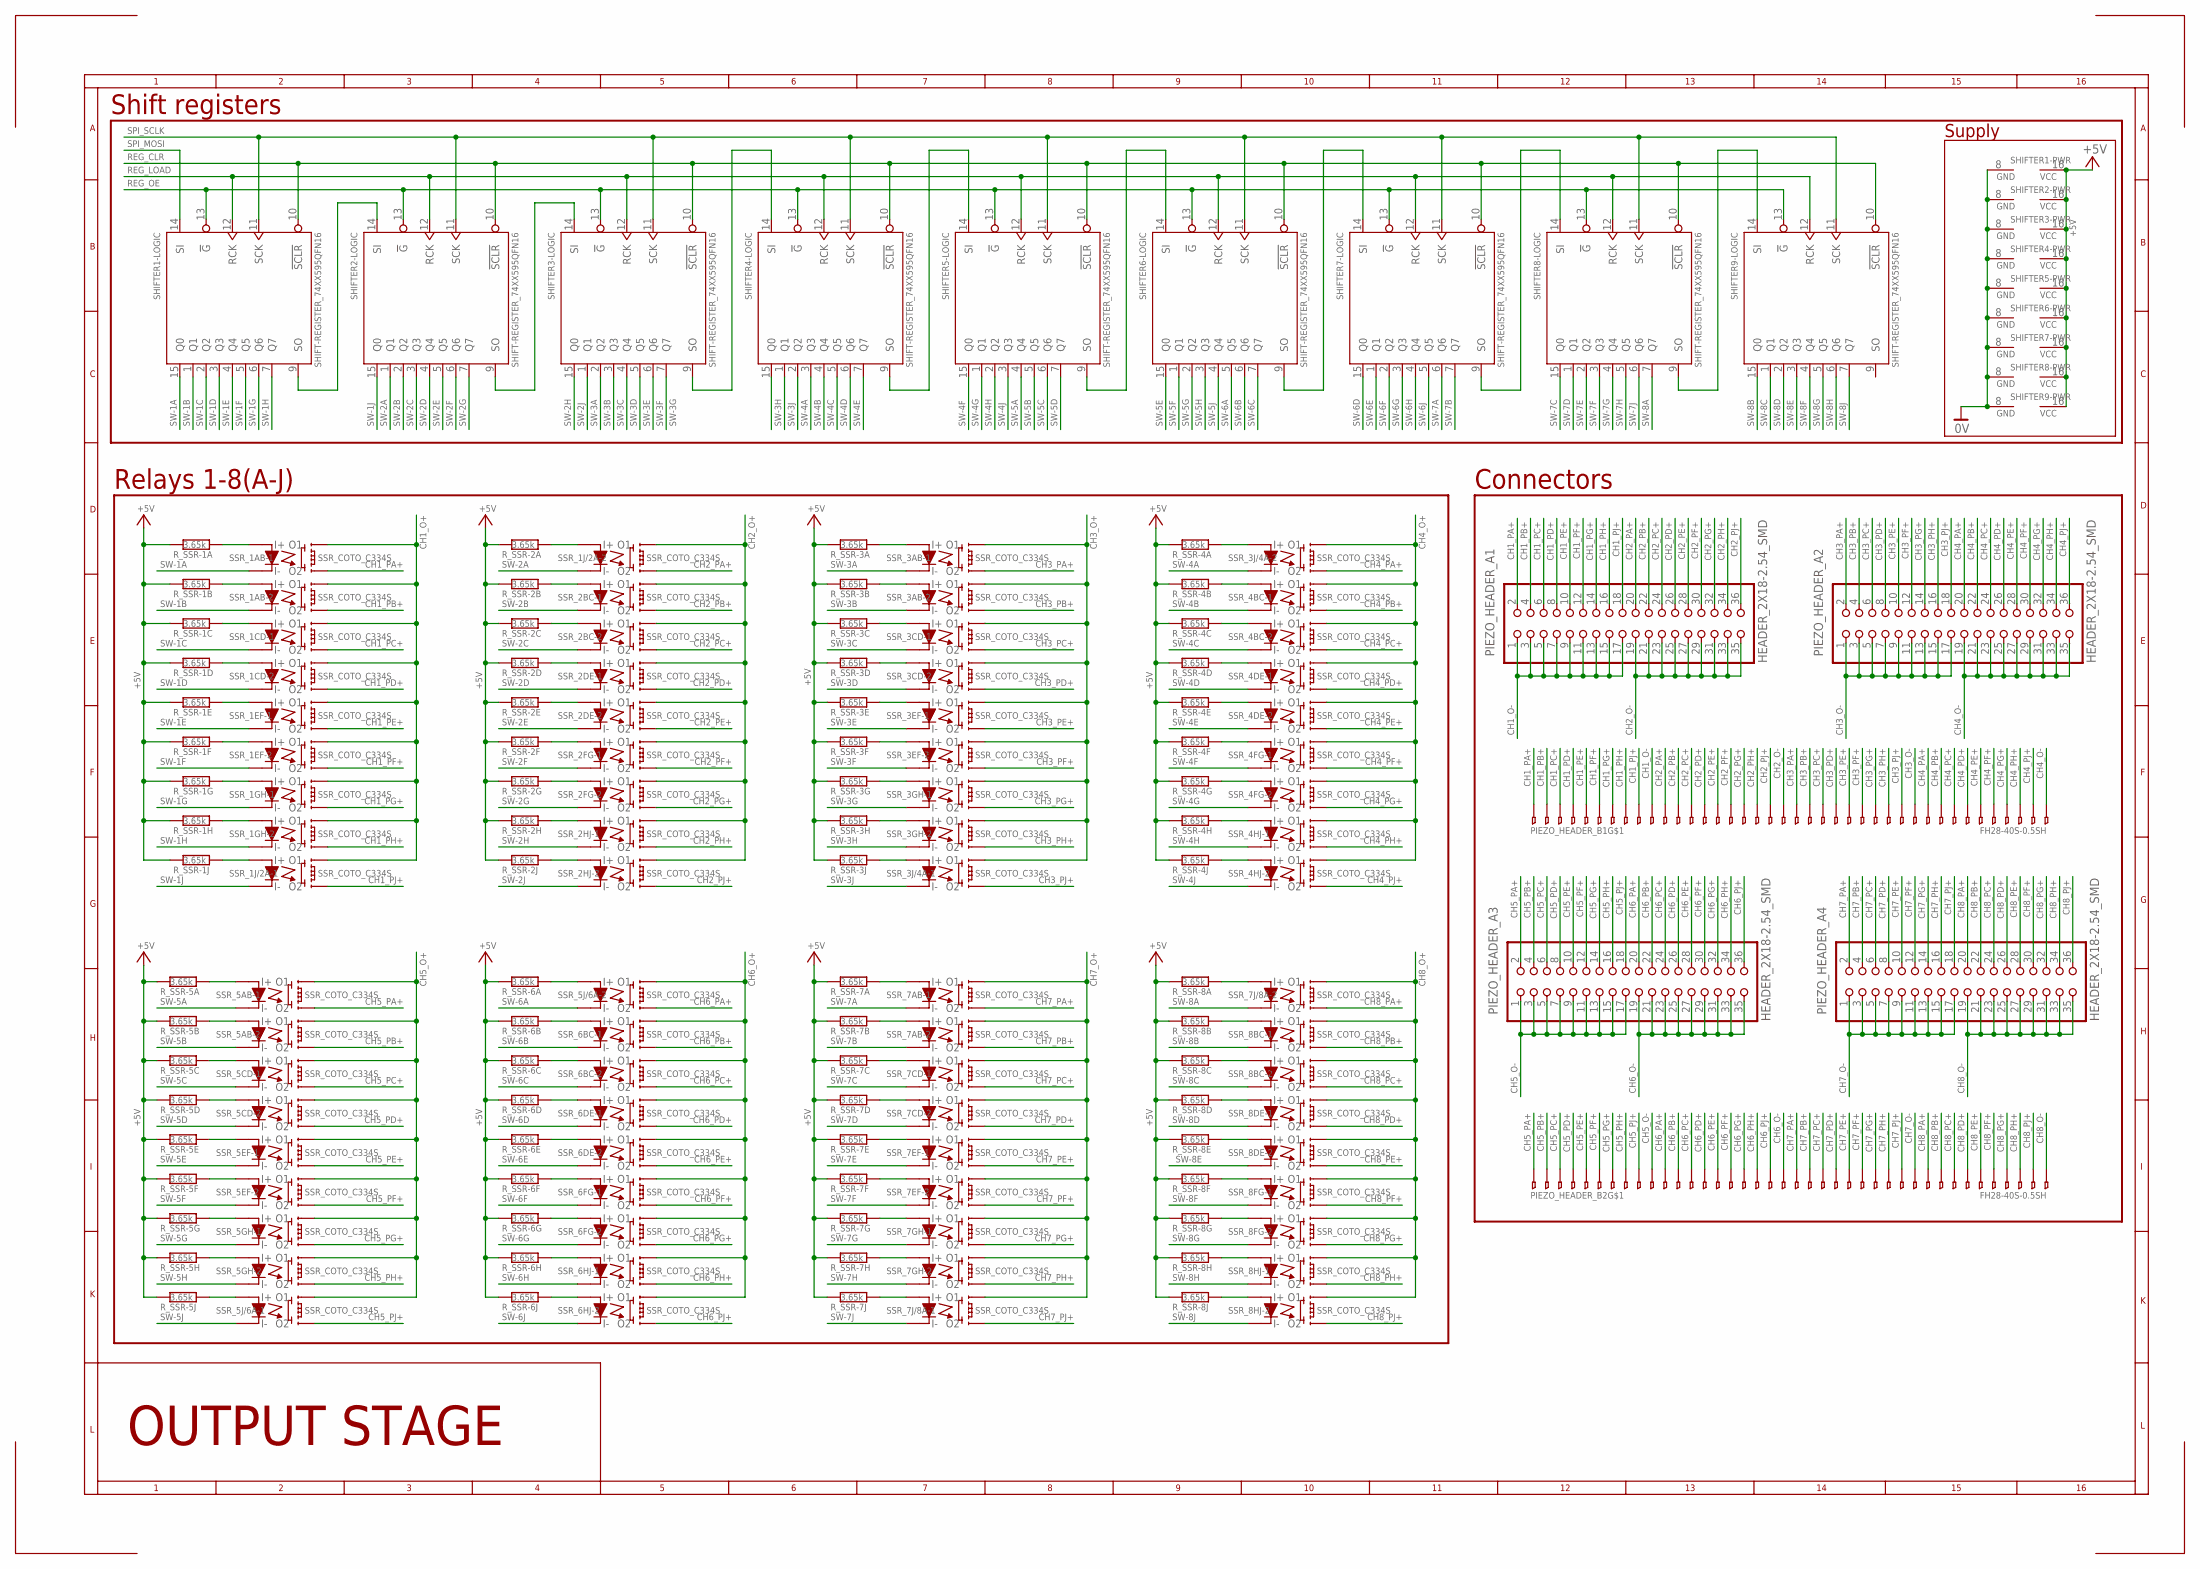
[picture p43: schematic piezo-driver_v0.9a-R001.sch, sheet 3]

Parts:
PIEZO_HEADER_A1, PIEZO_HEADER_A2, PIEZO_HEADER_A3, PIEZO_HEADER_A4: HEADER_2X18-2.54_SMD; 2X18_2.54_SMD
PIEZO_HEADER_B1, PIEZO_HEADER_B2: FH28-40S-0.5SH
R_SSR-1A, R_SSR-1B, R_SSR-1C, R_SSR-1D, R_SSR-1E, R_SSR-1F, R_SSR-1G, R_SSR-1H, R_SSR-1J, R_SSR-2A, R_SSR-2B, R_SSR-2C, R_SSR-2D, R_SSR-2E, R_SSR-2F, R_SSR-2G, R_SSR-2H, R_SSR-2J, R_SSR-3A, R_SSR-3B, R_SSR-3C, R_SSR-3D, R_SSR-3E, R_SSR-3F, R_SSR-3G, R_SSR-3H, R_SSR-3J, R_SSR-4A, R_SSR-4B, R_SSR-4C, R_SSR-4D, R_SSR-4E, R_SSR-4F, R_SSR-4G, R_SSR-4H, R_SSR-4J, R_SSR-5A, R_SSR-5B, R_SSR-5C, R_SSR-5D, R_SSR-5E, R_SSR-5F, R_SSR-5G, R_SSR-5H, R_SSR-5J, R_SSR-6A, R_SSR-6B, R_SSR-6C, R_SSR-6D, R_SSR-6E, R_SSR-6F, R_SSR-6G, R_SSR-6H, R_SSR-6J, R_SSR-7A, R_SSR-7B, R_SSR-7C, R_SSR-7D, R_SSR-7E, R_SSR-7F, R_SSR-7G, R_SSR-7H, R_SSR-7J, R_SSR-8A, R_SSR-8B, R_SSR-8C, R_SSR-8D, R_SSR-8E, R_SSR-8F, R_SSR-8G, R_SSR-8H, R_SSR-8J: 3.65k; R0805
SHIFTER1, SHIFTER2, SHIFTER3, SHIFTER4, SHIFTER5, SHIFTER6, SHIFTER7, SHIFTER8, SHIFTER9: SHIFT-REGISTER_74XX595QFN16; QFN-16
SSR_1AB, SSR_1CD, SSR_1EF, SSR_1GH, SSR_1J/2A, SSR_2BC, SSR_2DE, SSR_2FG, SSR_2HJ, SSR_3AB, SSR_3CD, SSR_3EF, SSR_3GH, SSR_3J/4A, SSR_4BC, SSR_4DE, SSR_4FG, SSR_4HJ, SSR_5AB, SSR_5CD, SSR_5EF, SSR_5GH, SSR_5J/6A, SSR_6BC, SSR_6DE, SSR_6FG, SSR_6HJ, SSR_7AB, SSR_7CD, SSR_7EF, SSR_7GH, SSR_7J/8A, SSR_8BC, SSR_8DE, SSR_8FG, SSR_8HJ: SSR_COTO_C334S; SOP8

Connections:
0V: SHIFTER1.8 (GND), SHIFTER2.8 (GND), SHIFTER3.8 (GND), SHIFTER4.8 (GND), SHIFTER5.8 (GND), SHIFTER6.8 (GND), SHIFTER7.8 (GND), SHIFTER8.8 (GND), SHIFTER9.8 (GND); also elsewhere on the board
+5V: R_SSR-1A.2, R_SSR-1B.2, R_SSR-1C.2, R_SSR-1D.2, R_SSR-1E.2, R_SSR-1F.2, R_SSR-1G.2, R_SSR-1H.2, R_SSR-1J.2, R_SSR-2A.2, R_SSR-2B.2, R_SSR-2C.2, R_SSR-2D.2, R_SSR-2E.2, R_SSR-2F.2, R_SSR-2G.2, R_SSR-2H.2, R_SSR-2J.2, R_SSR-3A.2, R_SSR-3B.2, R_SSR-3C.2, R_SSR-3D.2, R_SSR-3E.2, R_SSR-3F.2, R_SSR-3G.2, R_SSR-3H.2, R_SSR-3J.2, R_SSR-4A.2, R_SSR-4B.2, R_SSR-4C.2, R_SSR-4D.2, R_SSR-4E.2, R_SSR-4F.2, R_SSR-4G.2, R_SSR-4H.2, R_SSR-4J.2, R_SSR-5A.2, R_SSR-5B.2, R_SSR-5C.2, R_SSR-5D.2, R_SSR-5E.2, R_SSR-5F.2, R_SSR-5G.2, R_SSR-5H.2, R_SSR-5J.2, R_SSR-6A.2, R_SSR-6B.2, R_SSR-6C.2, R_SSR-6D.2, R_SSR-6E.2, R_SSR-6F.2, R_SSR-6G.2, R_SSR-6H.2, R_SSR-6J.2, R_SSR-7A.2, R_SSR-7B.2, R_SSR-7C.2, R_SSR-7D.2, R_SSR-7E.2, R_SSR-7F.2, R_SSR-7G.2, R_SSR-7H.2, R_SSR-7J.2, R_SSR-8A.2, R_SSR-8B.2, R_SSR-8C.2, R_SSR-8D.2, R_SSR-8E.2, R_SSR-8F.2, R_SSR-8G.2, R_SSR-8H.2, R_SSR-8J.2, SHIFTER1.16 (VCC), SHIFTER2.16 (VCC), SHIFTER3.16 (VCC), SHIFTER4.16 (VCC), SHIFTER5.16 (VCC), SHIFTER6.16 (VCC), SHIFTER7.16 (VCC), SHIFTER8.16 (VCC), SHIFTER9.16 (VCC); also elsewhere on the board
CH1_O+: SSR_1AB.5 (O1), SSR_1AB.7 (O1), SSR_1CD.5 (O1), SSR_1CD.7 (O1), SSR_1EF.5 (O1), SSR_1EF.7 (O1), SSR_1GH.5 (O1), SSR_1GH.7 (O1), SSR_1J/2A.7 (O1); also elsewhere on the board
CH1_O-: PIEZO_HEADER_A1.1, PIEZO_HEADER_A1.3, PIEZO_HEADER_A1.5, PIEZO_HEADER_A1.7, PIEZO_HEADER_A1.9, PIEZO_HEADER_A1.11, PIEZO_HEADER_A1.13, PIEZO_HEADER_A1.15, PIEZO_HEADER_A1.17, PIEZO_HEADER_B1.10; also elsewhere on the board
CH1_PA+: PIEZO_HEADER_A1.2, PIEZO_HEADER_B1.1, SSR_1AB.8 (O2)
CH1_PB+: PIEZO_HEADER_A1.4, PIEZO_HEADER_B1.2, SSR_1AB.6 (O2)
CH1_PC+: PIEZO_HEADER_A1.6, PIEZO_HEADER_B1.3, SSR_1CD.8 (O2)
CH1_PD+: PIEZO_HEADER_A1.8, PIEZO_HEADER_B1.4, SSR_1CD.6 (O2)
CH1_PE+: PIEZO_HEADER_A1.10, PIEZO_HEADER_B1.5, SSR_1EF.8 (O2)
CH1_PF+: PIEZO_HEADER_A1.12, PIEZO_HEADER_B1.6, SSR_1EF.6 (O2)
CH1_PG+: PIEZO_HEADER_A1.14, PIEZO_HEADER_B1.7, SSR_1GH.8 (O2)
CH1_PH+: PIEZO_HEADER_A1.16, PIEZO_HEADER_B1.8, SSR_1GH.6 (O2)
CH1_PJ+: PIEZO_HEADER_A1.18, PIEZO_HEADER_B1.9, SSR_1J/2A.8 (O2)
CH2_O+: SSR_1J/2A.5 (O1), SSR_2BC.5 (O1), SSR_2BC.7 (O1), SSR_2DE.5 (O1), SSR_2DE.7 (O1), SSR_2FG.5 (O1), SSR_2FG.7 (O1), SSR_2HJ.5 (O1), SSR_2HJ.7 (O1); also elsewhere on the board
CH2_O-: PIEZO_HEADER_A1.19, PIEZO_HEADER_A1.21, PIEZO_HEADER_A1.23, PIEZO_HEADER_A1.25, PIEZO_HEADER_A1.27, PIEZO_HEADER_A1.29, PIEZO_HEADER_A1.31, PIEZO_HEADER_A1.33, PIEZO_HEADER_A1.35, PIEZO_HEADER_B1.20; also elsewhere on the board
CH2_PA+: PIEZO_HEADER_A1.20, PIEZO_HEADER_B1.11, SSR_1J/2A.6 (O2)
CH2_PB+: PIEZO_HEADER_A1.22, PIEZO_HEADER_B1.12, SSR_2BC.8 (O2)
CH2_PC+: PIEZO_HEADER_A1.24, PIEZO_HEADER_B1.13, SSR_2BC.6 (O2)
CH2_PD+: PIEZO_HEADER_A1.26, PIEZO_HEADER_B1.14, SSR_2DE.8 (O2)
CH2_PE+: PIEZO_HEADER_A1.28, PIEZO_HEADER_B1.15, SSR_2DE.6 (O2)
CH2_PF+: PIEZO_HEADER_A1.30, PIEZO_HEADER_B1.16, SSR_2FG.8 (O2)
CH2_PG+: PIEZO_HEADER_A1.32, PIEZO_HEADER_B1.17, SSR_2FG.6 (O2)
CH2_PH+: PIEZO_HEADER_A1.34, PIEZO_HEADER_B1.18, SSR_2HJ.8 (O2)
CH2_PJ+: PIEZO_HEADER_A1.36, PIEZO_HEADER_B1.19, SSR_2HJ.6 (O2)
CH3_O+: SSR_3AB.5 (O1), SSR_3AB.7 (O1), SSR_3CD.5 (O1), SSR_3CD.7 (O1), SSR_3EF.5 (O1), SSR_3EF.7 (O1), SSR_3GH.5 (O1), SSR_3GH.7 (O1), SSR_3J/4A.7 (O1); also elsewhere on the board
CH3_O-: PIEZO_HEADER_A2.1, PIEZO_HEADER_A2.3, PIEZO_HEADER_A2.5, PIEZO_HEADER_A2.7, PIEZO_HEADER_A2.9, PIEZO_HEADER_A2.11, PIEZO_HEADER_A2.13, PIEZO_HEADER_A2.15, PIEZO_HEADER_A2.17, PIEZO_HEADER_B1.30; also elsewhere on the board
CH3_PA+: PIEZO_HEADER_A2.2, PIEZO_HEADER_B1.21, SSR_3AB.8 (O2)
CH3_PB+: PIEZO_HEADER_A2.4, PIEZO_HEADER_B1.22, SSR_3AB.6 (O2)
CH3_PC+: PIEZO_HEADER_A2.6, PIEZO_HEADER_B1.23, SSR_3CD.8 (O2)
CH3_PD+: PIEZO_HEADER_A2.8, PIEZO_HEADER_B1.24, SSR_3CD.6 (O2)
CH3_PE+: PIEZO_HEADER_A2.10, PIEZO_HEADER_B1.25, SSR_3EF.8 (O2)
CH3_PF+: PIEZO_HEADER_A2.12, PIEZO_HEADER_B1.26, SSR_3EF.6 (O2)
CH3_PG+: PIEZO_HEADER_A2.14, PIEZO_HEADER_B1.27, SSR_3GH.8 (O2)
CH3_PH+: PIEZO_HEADER_A2.16, PIEZO_HEADER_B1.28, SSR_3GH.6 (O2)
CH3_PJ+: PIEZO_HEADER_A2.18, PIEZO_HEADER_B1.29, SSR_3J/4A.8 (O2)
CH4_O+: SSR_3J/4A.5 (O1), SSR_4BC.5 (O1), SSR_4BC.7 (O1), SSR_4DE.5 (O1), SSR_4DE.7 (O1), SSR_4FG.5 (O1), SSR_4FG.7 (O1), SSR_4HJ.5 (O1), SSR_4HJ.7 (O1); also elsewhere on the board
CH4_O-: PIEZO_HEADER_A2.19, PIEZO_HEADER_A2.21, PIEZO_HEADER_A2.23, PIEZO_HEADER_A2.25, PIEZO_HEADER_A2.27, PIEZO_HEADER_A2.29, PIEZO_HEADER_A2.31, PIEZO_HEADER_A2.33, PIEZO_HEADER_A2.35, PIEZO_HEADER_B1.40; also elsewhere on the board
CH4_PA+: PIEZO_HEADER_A2.20, PIEZO_HEADER_B1.31, SSR_3J/4A.6 (O2)
CH4_PB+: PIEZO_HEADER_A2.22, PIEZO_HEADER_B1.32, SSR_4BC.8 (O2)
CH4_PC+: PIEZO_HEADER_A2.24, PIEZO_HEADER_B1.33, SSR_4BC.6 (O2)
CH4_PD+: PIEZO_HEADER_A2.26, PIEZO_HEADER_B1.34, SSR_4DE.8 (O2)
CH4_PE+: PIEZO_HEADER_A2.28, PIEZO_HEADER_B1.35, SSR_4DE.6 (O2)
CH4_PF+: PIEZO_HEADER_A2.30, PIEZO_HEADER_B1.36, SSR_4FG.8 (O2)
CH4_PG+: PIEZO_HEADER_A2.32, PIEZO_HEADER_B1.37, SSR_4FG.6 (O2)
CH4_PH+: PIEZO_HEADER_A2.34, PIEZO_HEADER_B1.38, SSR_4HJ.8 (O2)
CH4_PJ+: PIEZO_HEADER_A2.36, PIEZO_HEADER_B1.39, SSR_4HJ.6 (O2)
CH5_O+: SSR_5AB.5 (O1), SSR_5AB.7 (O1), SSR_5CD.5 (O1), SSR_5CD.7 (O1), SSR_5EF.5 (O1), SSR_5EF.7 (O1), SSR_5GH.5 (O1), SSR_5GH.7 (O1), SSR_5J/6A.7 (O1); also elsewhere on the board
CH5_O-: PIEZO_HEADER_A3.1, PIEZO_HEADER_A3.3, PIEZO_HEADER_A3.5, PIEZO_HEADER_A3.7, PIEZO_HEADER_A3.9, PIEZO_HEADER_A3.11, PIEZO_HEADER_A3.13, PIEZO_HEADER_A3.15, PIEZO_HEADER_A3.17, PIEZO_HEADER_B2.10; also elsewhere on the board
CH5_PA+: PIEZO_HEADER_A3.2, PIEZO_HEADER_B2.1, SSR_5AB.8 (O2)
CH5_PB+: PIEZO_HEADER_A3.4, PIEZO_HEADER_B2.2, SSR_5AB.6 (O2)
CH5_PC+: PIEZO_HEADER_A3.6, PIEZO_HEADER_B2.3, SSR_5CD.8 (O2)
CH5_PD+: PIEZO_HEADER_A3.8, PIEZO_HEADER_B2.4, SSR_5CD.6 (O2)
CH5_PE+: PIEZO_HEADER_A3.10, PIEZO_HEADER_B2.5, SSR_5EF.8 (O2)
CH5_PF+: PIEZO_HEADER_A3.12, PIEZO_HEADER_B2.6, SSR_5EF.6 (O2)
CH5_PG+: PIEZO_HEADER_A3.14, PIEZO_HEADER_B2.7, SSR_5GH.8 (O2)
CH5_PH+: PIEZO_HEADER_A3.16, PIEZO_HEADER_B2.8, SSR_5GH.6 (O2)
CH5_PJ+: PIEZO_HEADER_A3.18, PIEZO_HEADER_B2.9, SSR_5J/6A.8 (O2)
CH6_O+: SSR_5J/6A.5 (O1), SSR_6BC.5 (O1), SSR_6BC.7 (O1), SSR_6DE.5 (O1), SSR_6DE.7 (O1), SSR_6FG.5 (O1), SSR_6FG.7 (O1), SSR_6HJ.5 (O1), SSR_6HJ.7 (O1); also elsewhere on the board
CH6_O-: PIEZO_HEADER_A3.19, PIEZO_HEADER_A3.21, PIEZO_HEADER_A3.23, PIEZO_HEADER_A3.25, PIEZO_HEADER_A3.27, PIEZO_HEADER_A3.29, PIEZO_HEADER_A3.31, PIEZO_HEADER_A3.33, PIEZO_HEADER_A3.35, PIEZO_HEADER_B2.20; also elsewhere on the board
CH6_PA+: PIEZO_HEADER_A3.20, PIEZO_HEADER_B2.11, SSR_5J/6A.6 (O2)
CH6_PB+: PIEZO_HEADER_A3.22, PIEZO_HEADER_B2.12, SSR_6BC.8 (O2)
CH6_PC+: PIEZO_HEADER_A3.24, PIEZO_HEADER_B2.13, SSR_6BC.6 (O2)
CH6_PD+: PIEZO_HEADER_A3.26, PIEZO_HEADER_B2.14, SSR_6DE.8 (O2)
CH6_PE+: PIEZO_HEADER_A3.28, PIEZO_HEADER_B2.15, SSR_6DE.6 (O2)
CH6_PF+: PIEZO_HEADER_A3.30, PIEZO_HEADER_B2.16, SSR_6FG.8 (O2)
CH6_PG+: PIEZO_HEADER_A3.32, PIEZO_HEADER_B2.17, SSR_6FG.6 (O2)
CH6_PH+: PIEZO_HEADER_A3.34, PIEZO_HEADER_B2.18, SSR_6HJ.8 (O2)
CH6_PJ+: PIEZO_HEADER_A3.36, PIEZO_HEADER_B2.19, SSR_6HJ.6 (O2)
CH7_O+: SSR_7AB.5 (O1), SSR_7AB.7 (O1), SSR_7CD.5 (O1), SSR_7CD.7 (O1), SSR_7EF.5 (O1), SSR_7EF.7 (O1), SSR_7GH.5 (O1), SSR_7GH.7 (O1), SSR_7J/8A.7 (O1); also elsewhere on the board
CH7_O-: PIEZO_HEADER_A4.1, PIEZO_HEADER_A4.3, PIEZO_HEADER_A4.5, PIEZO_HEADER_A4.7, PIEZO_HEADER_A4.9, PIEZO_HEADER_A4.11, PIEZO_HEADER_A4.13, PIEZO_HEADER_A4.15, PIEZO_HEADER_A4.17, PIEZO_HEADER_B2.30; also elsewhere on the board
CH7_PA+: PIEZO_HEADER_A4.2, PIEZO_HEADER_B2.21, SSR_7AB.8 (O2)
CH7_PB+: PIEZO_HEADER_A4.4, PIEZO_HEADER_B2.22, SSR_7AB.6 (O2)
CH7_PC+: PIEZO_HEADER_A4.6, PIEZO_HEADER_B2.23, SSR_7CD.8 (O2)
CH7_PD+: PIEZO_HEADER_A4.8, PIEZO_HEADER_B2.24, SSR_7CD.6 (O2)
CH7_PE+: PIEZO_HEADER_A4.10, PIEZO_HEADER_B2.25, SSR_7EF.8 (O2)
CH7_PF+: PIEZO_HEADER_A4.12, PIEZO_HEADER_B2.26, SSR_7EF.6 (O2)
CH7_PG+: PIEZO_HEADER_A4.14, PIEZO_HEADER_B2.27, SSR_7GH.8 (O2)
CH7_PH+: PIEZO_HEADER_A4.16, PIEZO_HEADER_B2.28, SSR_7GH.6 (O2)
CH7_PJ+: PIEZO_HEADER_A4.18, PIEZO_HEADER_B2.29, SSR_7J/8A.8 (O2)
CH8_O+: SSR_7J/8A.5 (O1), SSR_8BC.5 (O1), SSR_8BC.7 (O1), SSR_8DE.5 (O1), SSR_8DE.7 (O1), SSR_8FG.5 (O1), SSR_8FG.7 (O1), SSR_8HJ.5 (O1), SSR_8HJ.7 (O1); also elsewhere on the board
CH8_O-: PIEZO_HEADER_A4.19, PIEZO_HEADER_A4.21, PIEZO_HEADER_A4.23, PIEZO_HEADER_A4.25, PIEZO_HEADER_A4.27, PIEZO_HEADER_A4.29, PIEZO_HEADER_A4.31, PIEZO_HEADER_A4.33, PIEZO_HEADER_A4.35, PIEZO_HEADER_B2.40; also elsewhere on the board
CH8_PA+: PIEZO_HEADER_A4.20, PIEZO_HEADER_B2.31, SSR_7J/8A.6 (O2)
CH8_PB+: PIEZO_HEADER_A4.22, PIEZO_HEADER_B2.32, SSR_8BC.8 (O2)
CH8_PC+: PIEZO_HEADER_A4.24, PIEZO_HEADER_B2.33, SSR_8BC.6 (O2)
CH8_PD+: PIEZO_HEADER_A4.26, PIEZO_HEADER_B2.34, SSR_8DE.8 (O2)
CH8_PE+: PIEZO_HEADER_A4.28, PIEZO_HEADER_B2.35, SSR_8DE.6 (O2)
CH8_PF+: PIEZO_HEADER_A4.30, PIEZO_HEADER_B2.36, SSR_8FG.8 (O2)
CH8_PG+: PIEZO_HEADER_A4.32, PIEZO_HEADER_B2.37, SSR_8FG.6 (O2)
CH8_PH+: PIEZO_HEADER_A4.34, PIEZO_HEADER_B2.38, SSR_8HJ.8 (O2)
CH8_PJ+: PIEZO_HEADER_A4.36, PIEZO_HEADER_B2.39, SSR_8HJ.6 (O2)
unnamed: SHIFTER2.9 (SO), SHIFTER3.14 (SI)
unnamed: SHIFTER1.9 (SO), SHIFTER2.14 (SI)
unnamed: SHIFTER3.9 (SO), SHIFTER4.14 (SI)
unnamed: SHIFTER4.9 (SO), SHIFTER5.14 (SI)
unnamed: SHIFTER5.9 (SO), SHIFTER6.14 (SI)
unnamed: SHIFTER6.9 (SO), SHIFTER7.14 (SI)
unnamed: SHIFTER7.9 (SO), SHIFTER8.14 (SI)
unnamed: R_SSR-1A.1, SSR_1AB.1 (I+)
unnamed: R_SSR-1B.1, SSR_1AB.3 (I+)
unnamed: R_SSR-1C.1, SSR_1CD.1 (I+)
unnamed: R_SSR-1D.1, SSR_1CD.3 (I+)
unnamed: R_SSR-1E.1, SSR_1EF.1 (I+)
unnamed: R_SSR-1F.1, SSR_1EF.3 (I+)
unnamed: R_SSR-1G.1, SSR_1GH.1 (I+)
unnamed: R_SSR-1H.1, SSR_1GH.3 (I+)
unnamed: R_SSR-1J.1, SSR_1J/2A.1 (I+)
unnamed: R_SSR-2A.1, SSR_1J/2A.3 (I+)
unnamed: R_SSR-2B.1, SSR_2BC.1 (I+)
unnamed: R_SSR-2C.1, SSR_2BC.3 (I+)
unnamed: R_SSR-3A.1, SSR_3AB.1 (I+)
unnamed: R_SSR-3B.1, SSR_3AB.3 (I+)
unnamed: R_SSR-3C.1, SSR_3CD.1 (I+)
unnamed: R_SSR-3D.1, SSR_3CD.3 (I+)
unnamed: R_SSR-3E.1, SSR_3EF.1 (I+)
unnamed: R_SSR-3F.1, SSR_3EF.3 (I+)
unnamed: R_SSR-3J.1, SSR_3J/4A.1 (I+)
unnamed: R_SSR-3H.1, SSR_3GH.3 (I+)
unnamed: R_SSR-3G.1, SSR_3GH.1 (I+)
unnamed: R_SSR-2D.1, SSR_2DE.1 (I+)
unnamed: R_SSR-2E.1, SSR_2DE.3 (I+)
unnamed: R_SSR-2F.1, SSR_2FG.1 (I+)
unnamed: R_SSR-2J.1, SSR_2HJ.3 (I+)
unnamed: R_SSR-2H.1, SSR_2HJ.1 (I+)
unnamed: R_SSR-2G.1, SSR_2FG.3 (I+)
unnamed: R_SSR-4A.1, SSR_3J/4A.3 (I+)
unnamed: R_SSR-4B.1, SSR_4BC.1 (I+)
unnamed: R_SSR-4C.1, SSR_4BC.3 (I+)
unnamed: R_SSR-4D.1, SSR_4DE.1 (I+)
unnamed: R_SSR-4E.1, SSR_4DE.3 (I+)
unnamed: R_SSR-4F.1, SSR_4FG.1 (I+)
unnamed: R_SSR-4J.1, SSR_4HJ.3 (I+)
unnamed: R_SSR-4H.1, SSR_4HJ.1 (I+)
unnamed: R_SSR-4G.1, SSR_4FG.3 (I+)
unnamed: R_SSR-5A.1, SSR_5AB.1 (I+)
unnamed: R_SSR-5B.1, SSR_5AB.3 (I+)
unnamed: R_SSR-5C.1, SSR_5CD.1 (I+)
unnamed: R_SSR-5D.1, SSR_5CD.3 (I+)
unnamed: R_SSR-5E.1, SSR_5EF.1 (I+)
unnamed: R_SSR-5F.1, SSR_5EF.3 (I+)
unnamed: R_SSR-5J.1, SSR_5J/6A.1 (I+)
unnamed: R_SSR-5H.1, SSR_5GH.3 (I+)
unnamed: R_SSR-5G.1, SSR_5GH.1 (I+)
unnamed: R_SSR-6A.1, SSR_5J/6A.3 (I+)
unnamed: R_SSR-6B.1, SSR_6BC.1 (I+)
unnamed: R_SSR-6C.1, SSR_6BC.3 (I+)
unnamed: R_SSR-6D.1, SSR_6DE.1 (I+)
unnamed: R_SSR-6E.1, SSR_6DE.3 (I+)
unnamed: R_SSR-6F.1, SSR_6FG.1 (I+)
unnamed: R_SSR-6J.1, SSR_6HJ.3 (I+)
unnamed: R_SSR-6H.1, SSR_6HJ.1 (I+)
unnamed: R_SSR-6G.1, SSR_6FG.3 (I+)
unnamed: R_SSR-7A.1, SSR_7AB.1 (I+)
unnamed: R_SSR-7B.1, SSR_7AB.3 (I+)
unnamed: R_SSR-7C.1, SSR_7CD.1 (I+)
unnamed: R_SSR-7D.1, SSR_7CD.3 (I+)
unnamed: R_SSR-7E.1, SSR_7EF.1 (I+)
unnamed: R_SSR-7F.1, SSR_7EF.3 (I+)
unnamed: R_SSR-7J.1, SSR_7J/8A.1 (I+)
unnamed: R_SSR-7H.1, SSR_7GH.3 (I+)
unnamed: R_SSR-7G.1, SSR_7GH.1 (I+)
unnamed: R_SSR-8A.1, SSR_7J/8A.3 (I+)
unnamed: R_SSR-8B.1, SSR_8BC.1 (I+)
unnamed: R_SSR-8C.1, SSR_8BC.3 (I+)
unnamed: R_SSR-8D.1, SSR_8DE.1 (I+)
unnamed: R_SSR-8E.1, SSR_8DE.3 (I+)
unnamed: R_SSR-8F.1, SSR_8FG.1 (I+)
unnamed: R_SSR-8J.1, SSR_8HJ.3 (I+)
unnamed: R_SSR-8H.1, SSR_8HJ.1 (I+)
unnamed: R_SSR-8G.1, SSR_8FG.3 (I+)
REG_CLR: SHIFTER1.10 (!SCLR), SHIFTER2.10 (!SCLR), SHIFTER3.10 (!SCLR), SHIFTER4.10 (!SCLR), SHIFTER5.10 (!SCLR), SHIFTER6.10 (!SCLR), SHIFTER7.10 (!SCLR), SHIFTER8.10 (!SCLR), SHIFTER9.10 (!SCLR); also elsewhere on the board
REG_LOAD: SHIFTER1.12 (RCK), SHIFTER2.12 (RCK), SHIFTER3.12 (RCK), SHIFTER4.12 (RCK), SHIFTER5.12 (RCK), SHIFTER6.12 (RCK), SHIFTER7.12 (RCK), SHIFTER8.12 (RCK), SHIFTER9.12 (RCK); also elsewhere on the board
REG_OE: SHIFTER1.13 (!G), SHIFTER2.13 (!G), SHIFTER3.13 (!G), SHIFTER4.13 (!G), SHIFTER5.13 (!G), SHIFTER6.13 (!G), SHIFTER7.13 (!G), SHIFTER8.13 (!G), SHIFTER9.13 (!G); also elsewhere on the board
SPI_MOSI: SHIFTER1.14 (SI); also elsewhere on the board
SPI_SCLK: SHIFTER1.11 (SCK), SHIFTER2.11 (SCK), SHIFTER3.11 (SCK), SHIFTER4.11 (SCK), SHIFTER5.11 (SCK), SHIFTER6.11 (SCK), SHIFTER7.11 (SCK), SHIFTER8.11 (SCK), SHIFTER9.11 (SCK); also elsewhere on the board
SW-1A: SHIFTER1.15 (Q0), SSR_1AB.2 (I-)
SW-1B: SHIFTER1.1 (Q1), SSR_1AB.4 (I-)
SW-1C: SHIFTER1.2 (Q2), SSR_1CD.2 (I-)
SW-1D: SHIFTER1.3 (Q3), SSR_1CD.4 (I-)
SW-1E: SHIFTER1.4 (Q4), SSR_1EF.2 (I-)
SW-1F: SHIFTER1.5 (Q5), SSR_1EF.4 (I-)
SW-1G: SHIFTER1.6 (Q6), SSR_1GH.2 (I-)
SW-1H: SHIFTER1.7 (Q7), SSR_1GH.4 (I-)
SW-1J: SHIFTER2.15 (Q0), SSR_1J/2A.2 (I-)
SW-2A: SHIFTER2.1 (Q1), SSR_1J/2A.4 (I-)
SW-2B: SHIFTER2.2 (Q2), SSR_2BC.2 (I-)
SW-2C: SHIFTER2.3 (Q3), SSR_2BC.4 (I-)
SW-2D: SHIFTER2.4 (Q4), SSR_2DE.2 (I-)
SW-2E: SHIFTER2.5 (Q5), SSR_2DE.4 (I-)
SW-2F: SHIFTER2.6 (Q6), SSR_2FG.2 (I-)
SW-2G: SHIFTER2.7 (Q7), SSR_2FG.4 (I-)
SW-2H: SHIFTER3.15 (Q0), SSR_2HJ.2 (I-)
SW-2J: SHIFTER3.1 (Q1), SSR_2HJ.4 (I-)
SW-3A: SHIFTER3.2 (Q2), SSR_3AB.2 (I-)
SW-3B: SHIFTER3.3 (Q3), SSR_3AB.4 (I-)
SW-3C: SHIFTER3.4 (Q4), SSR_3CD.2 (I-)
SW-3D: SHIFTER3.5 (Q5), SSR_3CD.4 (I-)
SW-3E: SHIFTER3.6 (Q6), SSR_3EF.2 (I-)
SW-3F: SHIFTER3.7 (Q7), SSR_3EF.4 (I-)
SW-3G: SHIFTER4.15 (Q0), SSR_3GH.2 (I-)
SW-3H: SHIFTER4.1 (Q1), SSR_3GH.4 (I-)
SW-3J: SHIFTER4.2 (Q2), SSR_3J/4A.2 (I-)
SW-4A: SHIFTER4.3 (Q3), SSR_3J/4A.4 (I-)
SW-4B: SHIFTER4.4 (Q4), SSR_4BC.2 (I-)
SW-4C: SHIFTER4.5 (Q5), SSR_4BC.4 (I-)
SW-4D: SHIFTER4.6 (Q6), SSR_4DE.2 (I-)
SW-4E: SHIFTER4.7 (Q7), SSR_4DE.4 (I-)
SW-4F: SHIFTER5.15 (Q0), SSR_4FG.2 (I-)
SW-4G: SHIFTER5.1 (Q1), SSR_4FG.4 (I-)
SW-4H: SHIFTER5.2 (Q2), SSR_4HJ.2 (I-)
SW-4J: SHIFTER5.3 (Q3), SSR_4HJ.4 (I-)
SW-5A: SHIFTER5.4 (Q4), SSR_5AB.2 (I-)
SW-5B: SHIFTER5.5 (Q5), SSR_5AB.4 (I-)
SW-5C: SHIFTER5.6 (Q6), SSR_5CD.2 (I-)
SW-5D: SHIFTER5.7 (Q7), SSR_5CD.4 (I-)
SW-5E: SHIFTER6.15 (Q0), SSR_5EF.2 (I-)
SW-5F: SHIFTER6.1 (Q1), SSR_5EF.4 (I-)
SW-5G: SHIFTER6.2 (Q2), SSR_5GH.2 (I-)
SW-5H: SHIFTER6.3 (Q3), SSR_5GH.4 (I-)
SW-5J: SHIFTER6.4 (Q4), SSR_5J/6A.2 (I-)
SW-6A: SHIFTER6.5 (Q5), SSR_5J/6A.4 (I-)
SW-6B: SHIFTER6.6 (Q6), SSR_6BC.2 (I-)
SW-6C: SHIFTER6.7 (Q7), SSR_6BC.4 (I-)
SW-6D: SHIFTER7.15 (Q0), SSR_6DE.2 (I-)
SW-6E: SHIFTER7.1 (Q1), SSR_6DE.4 (I-)
SW-6F: SHIFTER7.2 (Q2), SSR_6FG.2 (I-)
SW-6G: SHIFTER7.3 (Q3), SSR_6FG.4 (I-)
SW-6H: SHIFTER7.4 (Q4), SSR_6HJ.2 (I-)
SW-6J: SHIFTER7.5 (Q5), SSR_6HJ.4 (I-)
SW-7A: SHIFTER7.6 (Q6), SSR_7AB.2 (I-)
SW-7B: SHIFTER7.7 (Q7), SSR_7AB.4 (I-)
SW-7C: SHIFTER8.15 (Q0), SSR_7CD.2 (I-)
SW-7D: SHIFTER8.1 (Q1), SSR_7CD.4 (I-)
SW-7E: SHIFTER8.2 (Q2), SSR_7EF.2 (I-)
SW-7F: SHIFTER8.3 (Q3), SSR_7EF.4 (I-)
SW-7G: SHIFTER8.4 (Q4), SSR_7GH.2 (I-)
SW-7H: SHIFTER8.5 (Q5), SSR_7GH.4 (I-)
SW-7J: SHIFTER8.6 (Q6), SSR_7J/8A.2 (I-)
SW-8A: SHIFTER8.7 (Q7), SSR_7J/8A.4 (I-)
SW-8B: SHIFTER9.15 (Q0), SSR_8BC.2 (I-)
SW-8C: SHIFTER9.1 (Q1), SSR_8BC.4 (I-)
SW-8D: SHIFTER9.2 (Q2), SSR_8DE.2 (I-)
SW-8E: SHIFTER9.3 (Q3), SSR_8DE.4 (I-)
SW-8F: SHIFTER9.4 (Q4), SSR_8FG.2 (I-)
SW-8G: SHIFTER9.5 (Q5), SSR_8FG.4 (I-)
SW-8H: SHIFTER9.6 (Q6), SSR_8HJ.2 (I-)
SW-8J: SHIFTER9.7 (Q7), SSR_8HJ.4 (I-)
UART_TXD: SHIFTER8.9 (SO), SHIFTER9.14 (SI); also elsewhere on the board

Notes on the sheet:
OUTPUT STAGE
Relays 1-8(A-J)
Shift registers
Supply
Connectors

Board: 2 copper layers, 229 parts (0 on the bottom side), 336 nets, no tracks yet.
