ICST-AHMI/HSoundplane_design/(commit log)

2015-09-14 added blender files
    [SP_0072_V2.blend, SP_0072_V3.blend, SP_0072_V4.blend, SP_0072_V5.blend, SP_0072_V6.blend, SP_0072_V7.blend, SP_0072_V8.blend, SP_0072_V9.blend]
2015-09-16 tiny changes
    [SP_0072_V9.blend]
2015-09-21 added foil support object
    [SP_0072_V9.blend]
2016-02-24 added design for testing table so I can interact with the HSoundplane while it is upside down and with the guts open.
    [SP_0072_V9.blend]
