ICST-AHMI/HSoundplane_design/(notices)

Notices in the files:
eagle/piezo-layer/piezo-layer_v0.95-R005.brd:
(c) 2015 ICST
